Wanzi-z/access-controller/images/20260709_174217.jpg

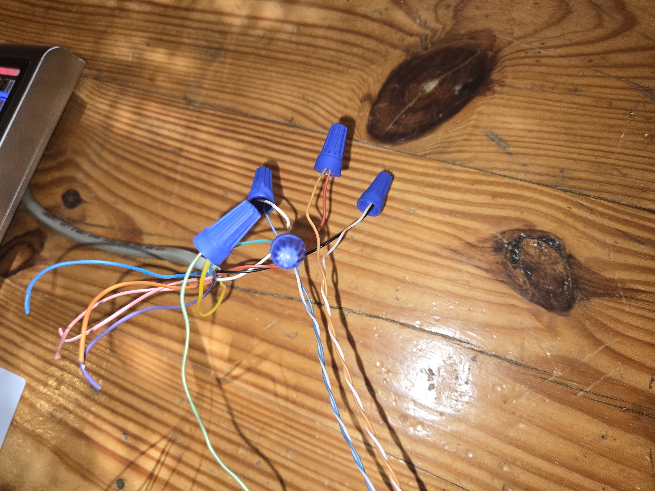
images/20260709_174217.jpg
