Wanzi-z/access-controller/images/20260709_174414.jpg

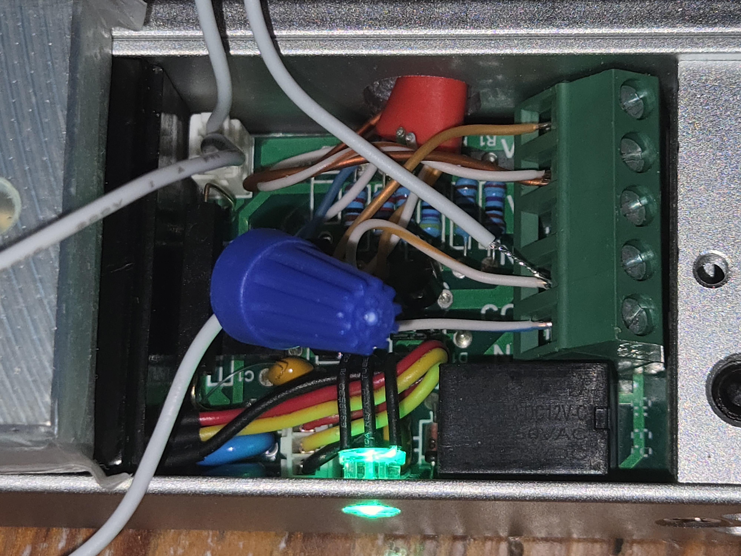
images/20260709_174414.jpg
