Wanzi-z/access-controller/code/controller/tests/artifacts/system-overview-mobile.png

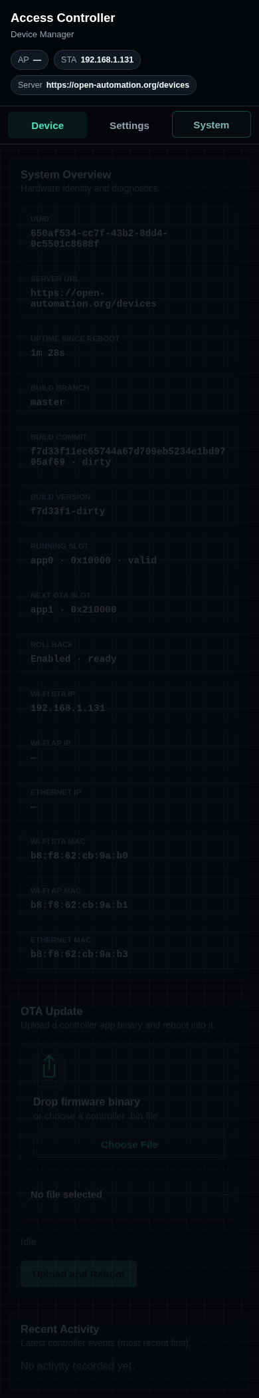
code/controller/tests/artifacts/system-overview-mobile.png
