Wanzi-z/access-controller/code/controller/tests/artifacts/system-overview-wide-refined.png

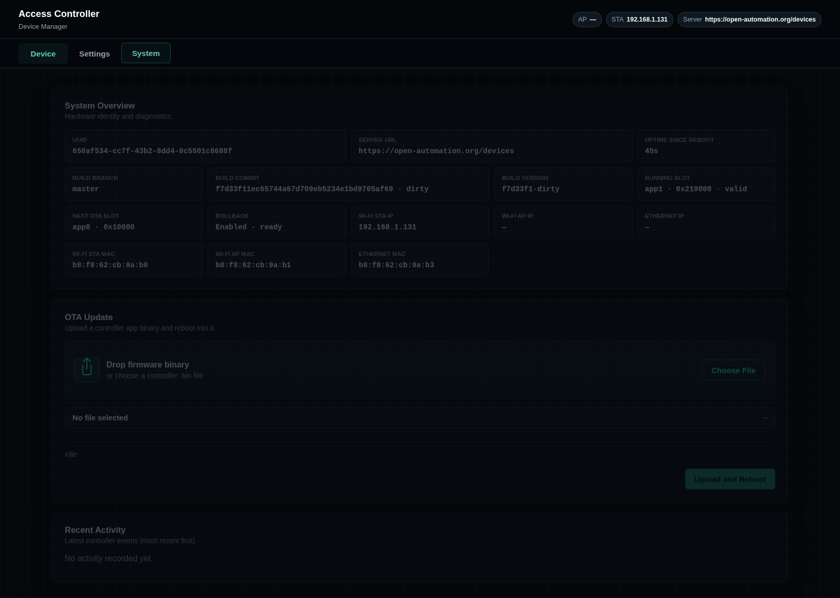
code/controller/tests/artifacts/system-overview-wide-refined.png
