Wanzi-z/access-controller/code/controller/tests/artifacts/system-overview-wide.png

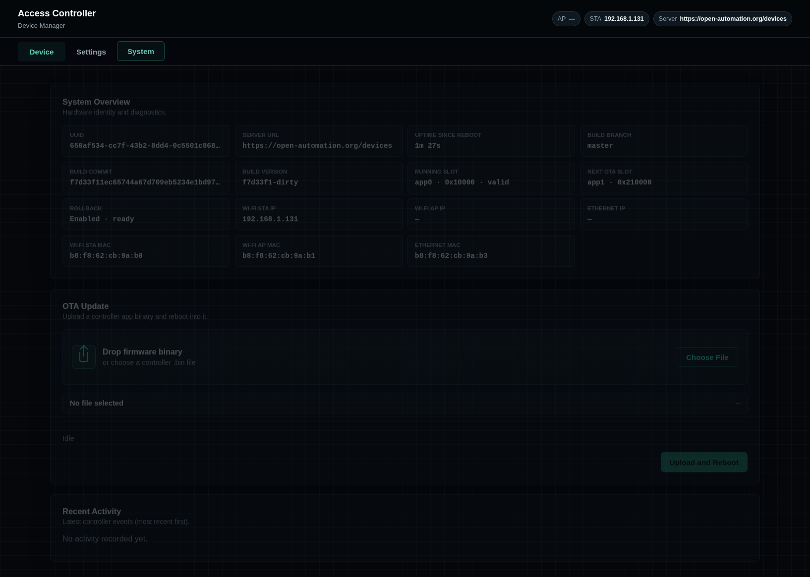
code/controller/tests/artifacts/system-overview-wide.png
