Wanzi-z/access-controller/images/20260709_150411.jpg

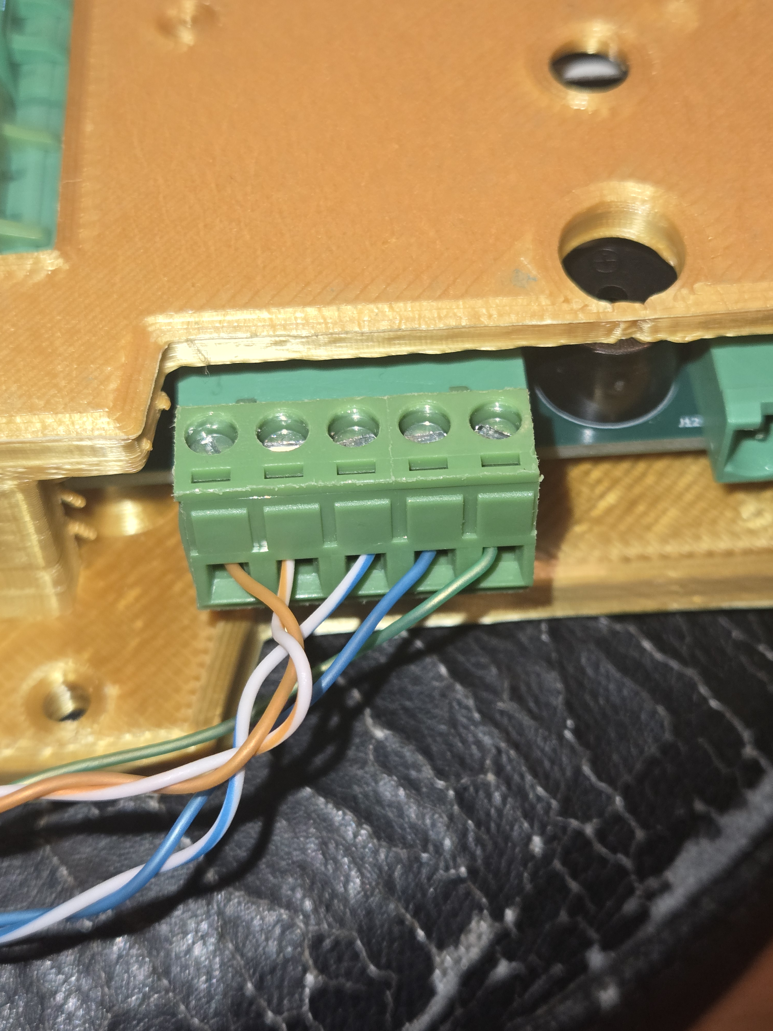
images/20260709_150411.jpg
