Wanzi-z/access-controller/images/20260709_150417.jpg

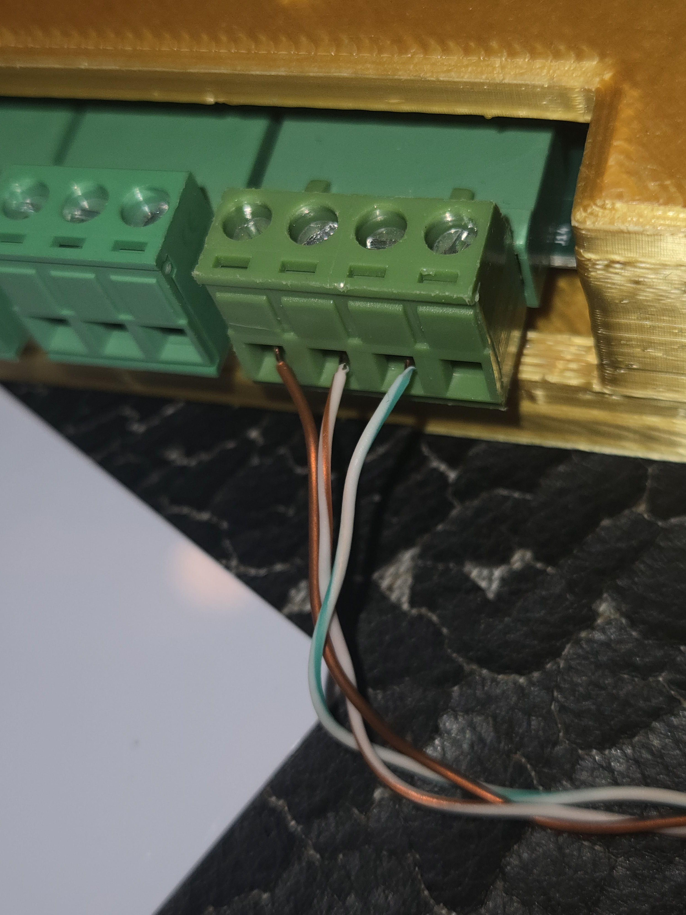
images/20260709_150417.jpg
