Wanzi-z/access-controller/images/20260709_174208.jpg

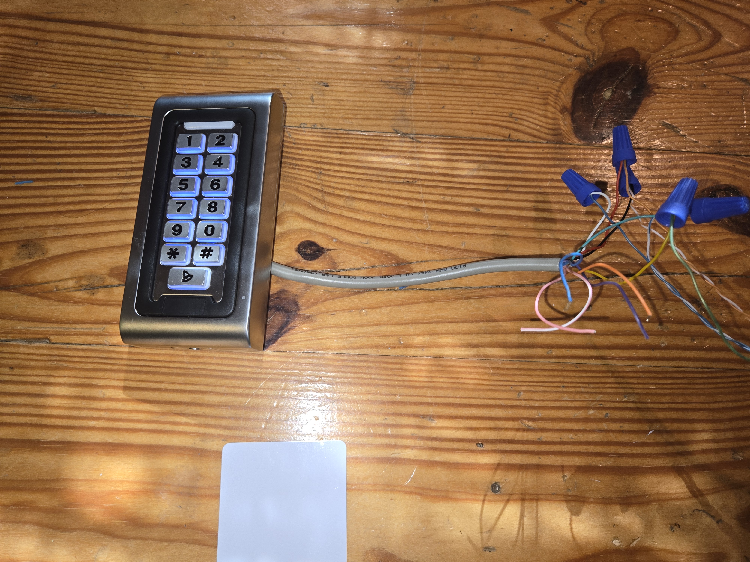
images/20260709_174208.jpg
