Wanzi-z/access-controller/images/20260709_174212.jpg

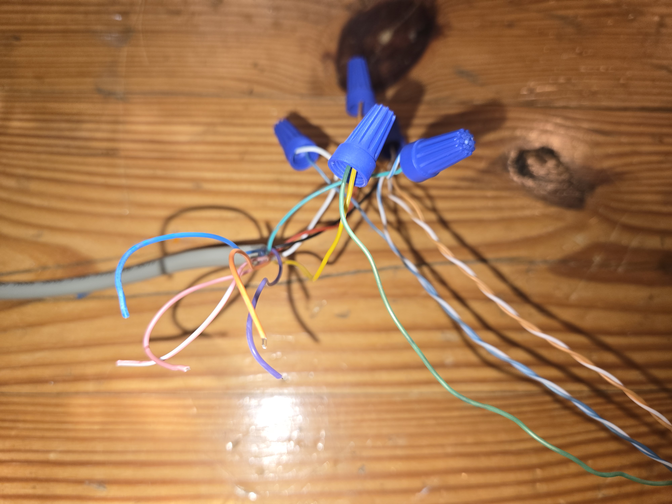
images/20260709_174212.jpg
