Wanzi-z/access-controller/images/20260709_174222.jpg

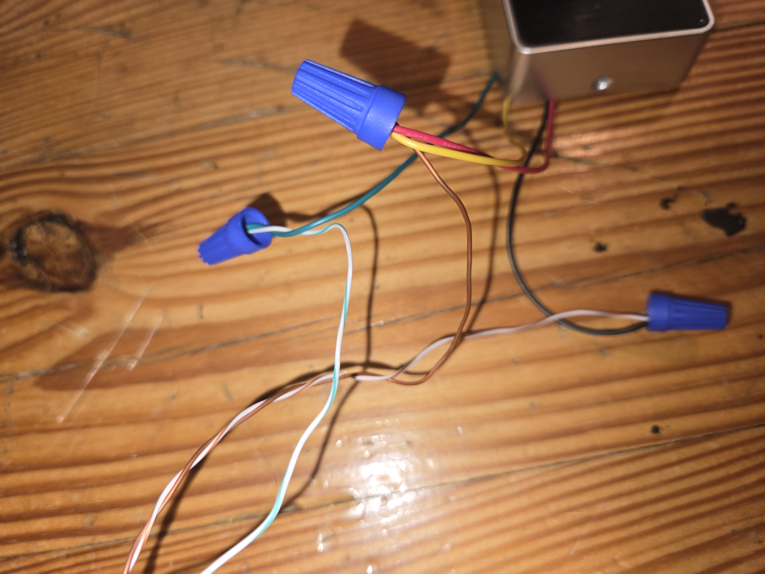
images/20260709_174222.jpg
