Wanzi-z/access-controller/images/20260709_174225.jpg

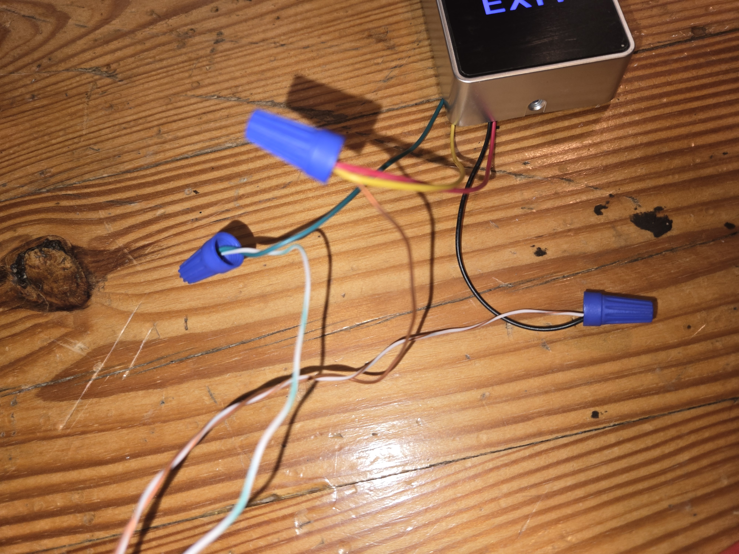
images/20260709_174225.jpg
