Wanzi-z/access-controller/images/20260709_174229.jpg

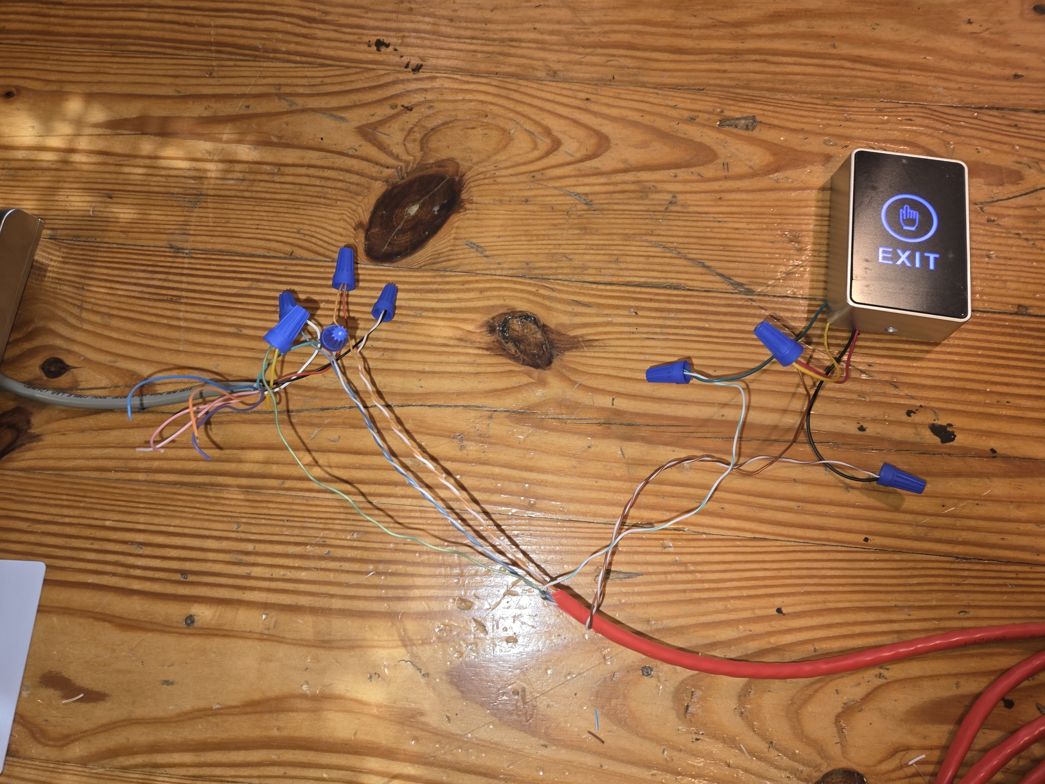
images/20260709_174229.jpg
