Wanzi-z/access-controller/images/20260709_174233.jpg

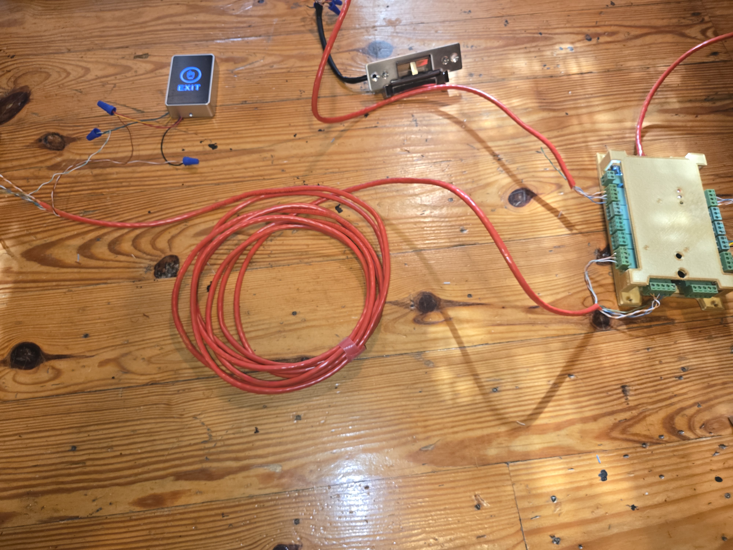
images/20260709_174233.jpg
