Wanzi-z/access-controller/images/20260709_174241.jpg

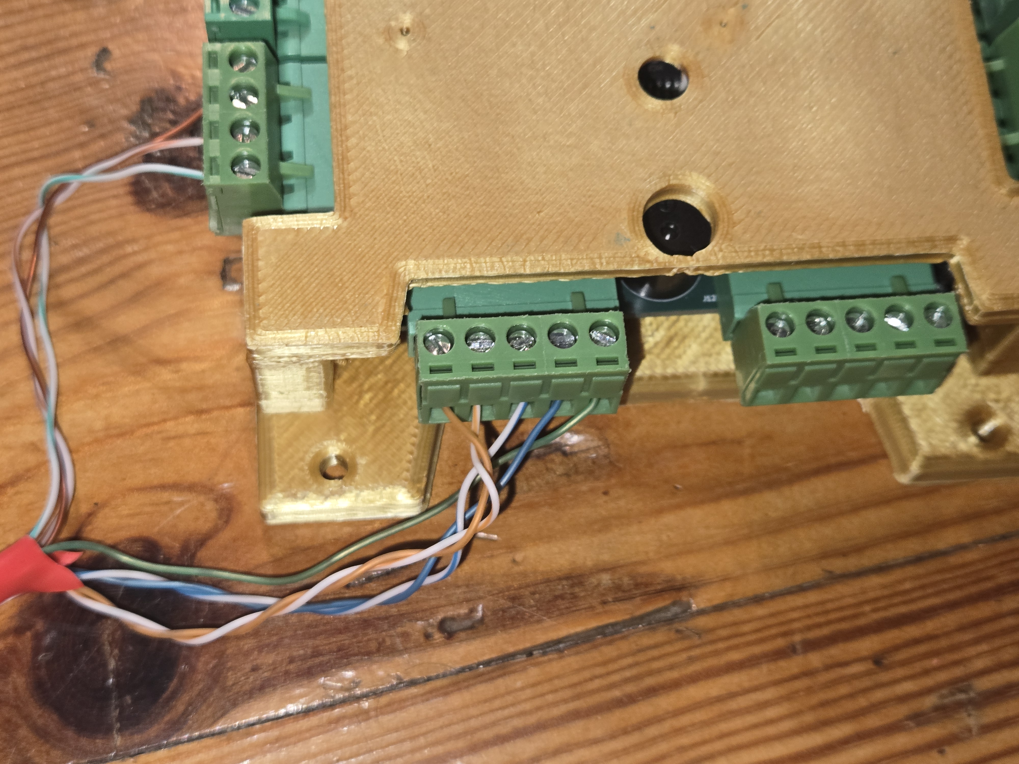
images/20260709_174241.jpg
