Wanzi-z/access-controller/images/20260709_174245.jpg

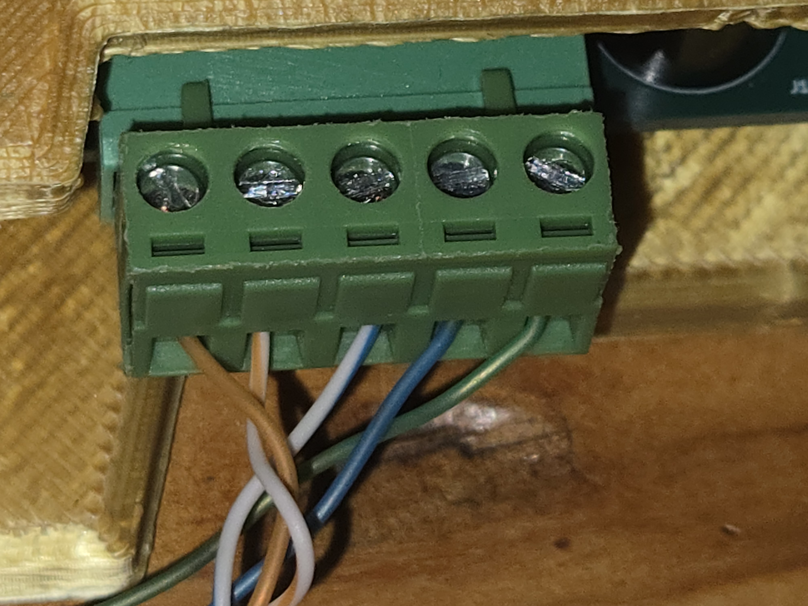
images/20260709_174245.jpg
