Wanzi-z/access-controller/images/20260709_174251.jpg

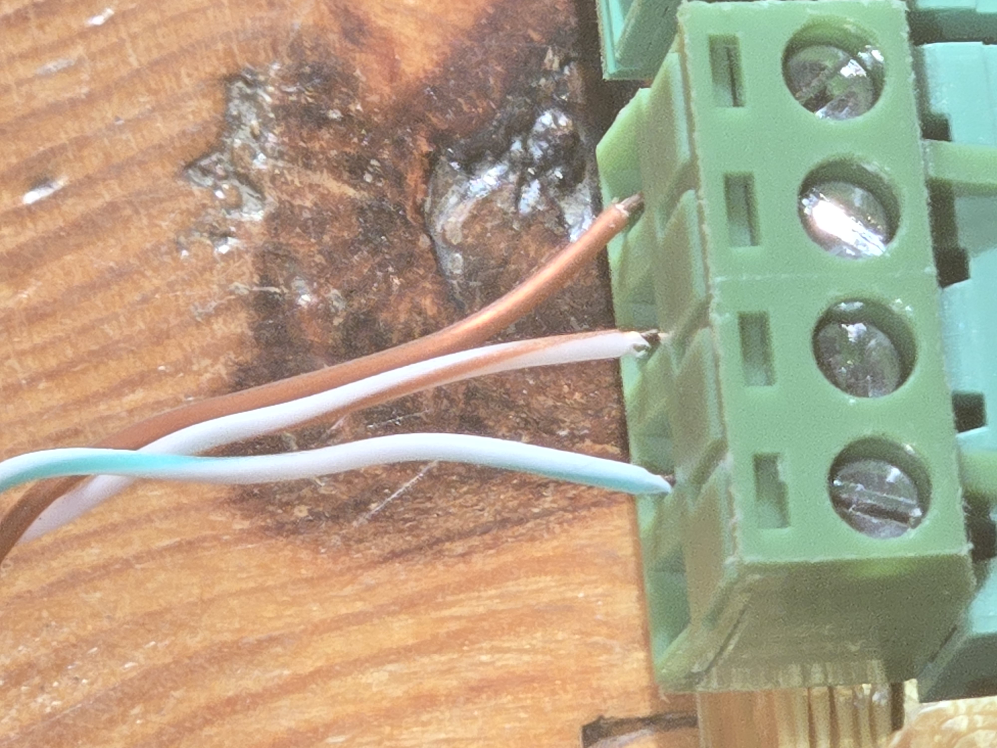
images/20260709_174251.jpg
