Wanzi-z/access-controller/images/20260709_174256.jpg

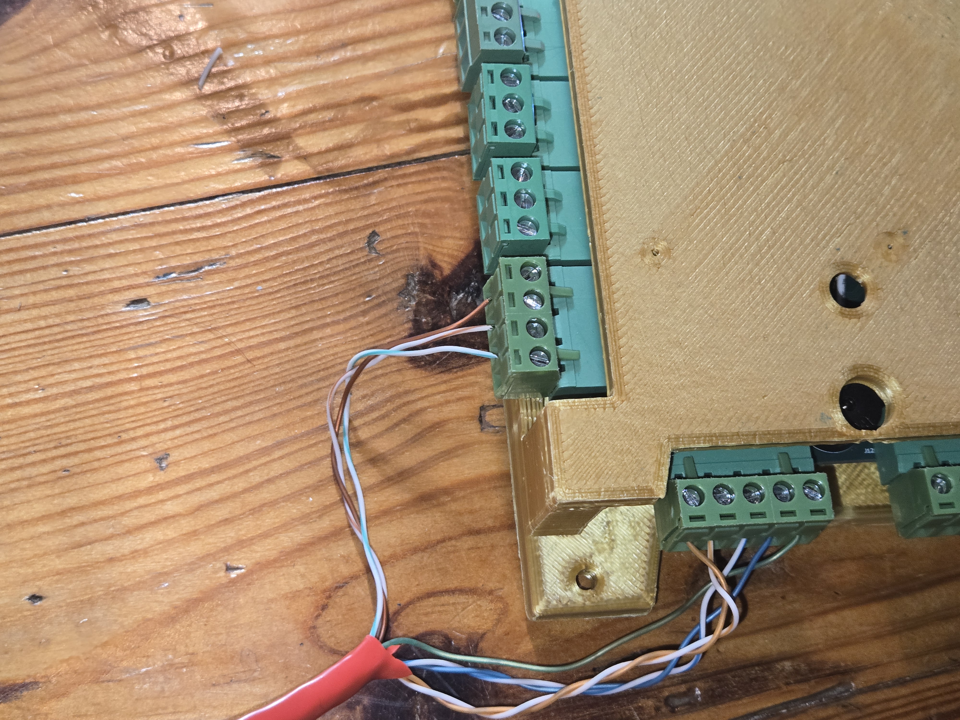
images/20260709_174256.jpg
