Wanzi-z/access-controller/images/20260709_174305.jpg

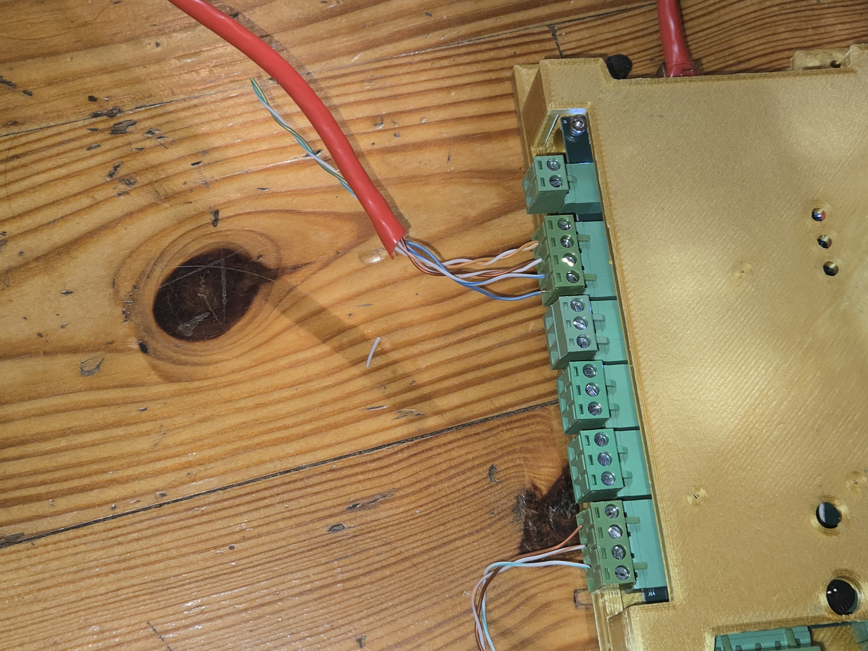
images/20260709_174305.jpg
