Wanzi-z/access-controller/images/20260709_174310.jpg

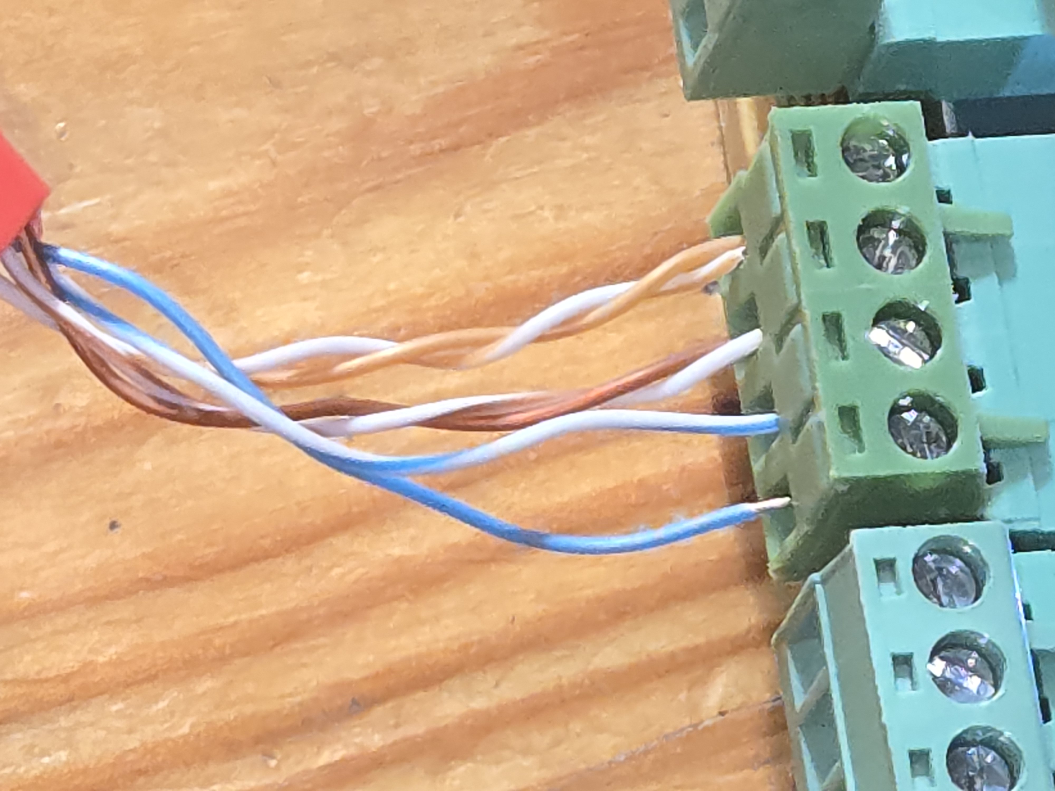
images/20260709_174310.jpg
