Wanzi-z/access-controller/images/20260709_174321.jpg

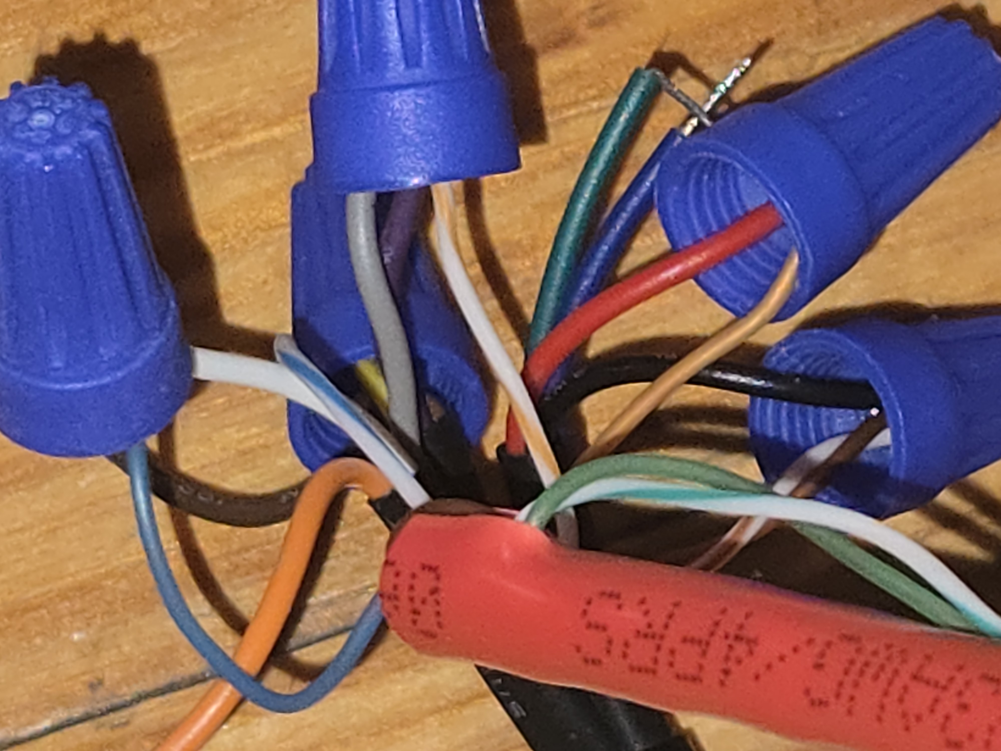
images/20260709_174321.jpg
