Wanzi-z/access-controller/images/20260709_174329.jpg

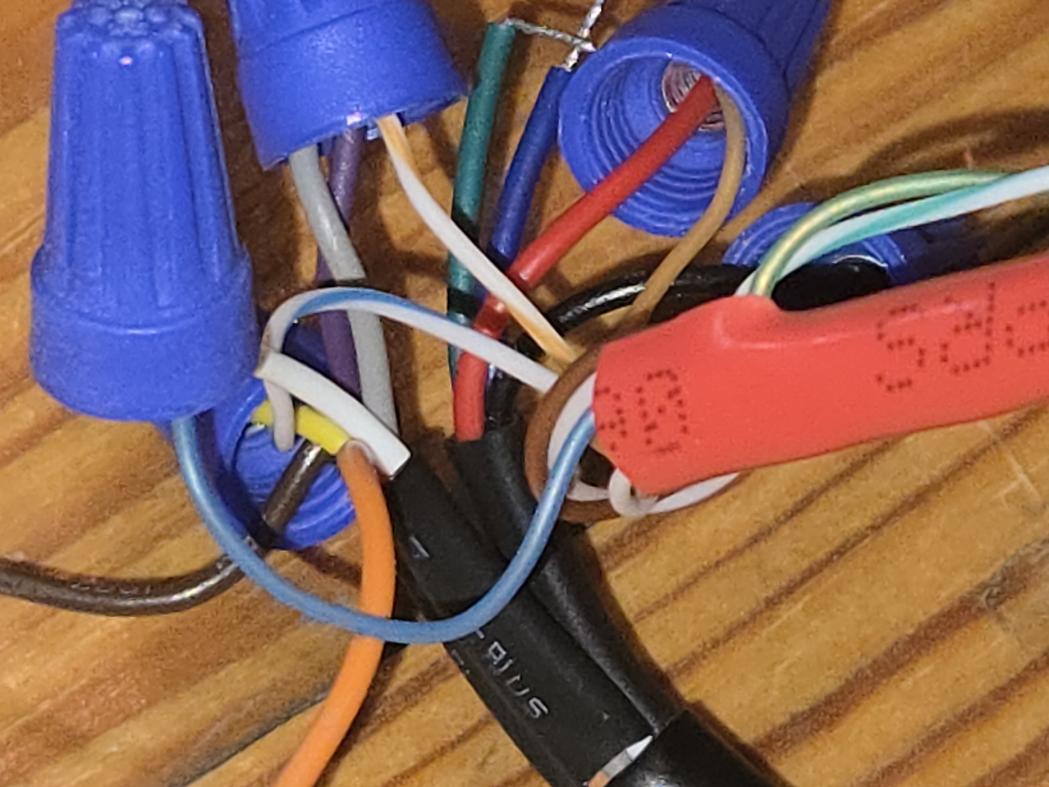
images/20260709_174329.jpg
