Wanzi-z/access-controller/images/20260709_174342.jpg

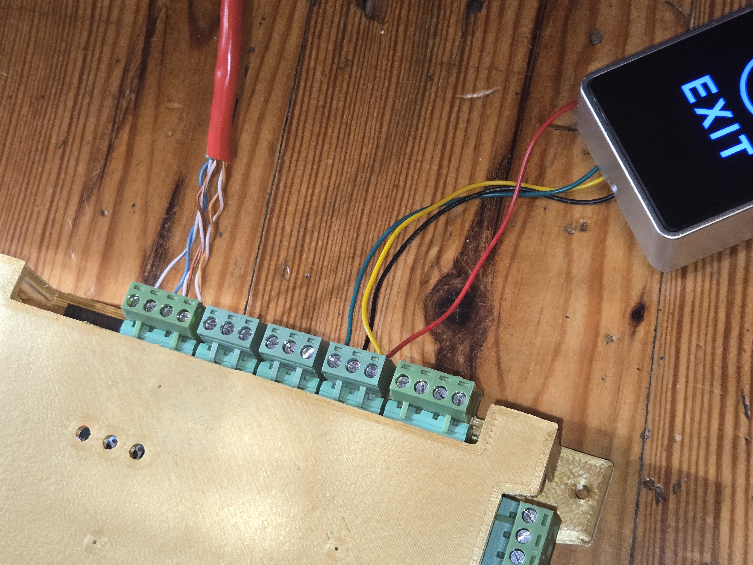
images/20260709_174342.jpg
