Wanzi-z/access-controller/images/20260709_174347.jpg

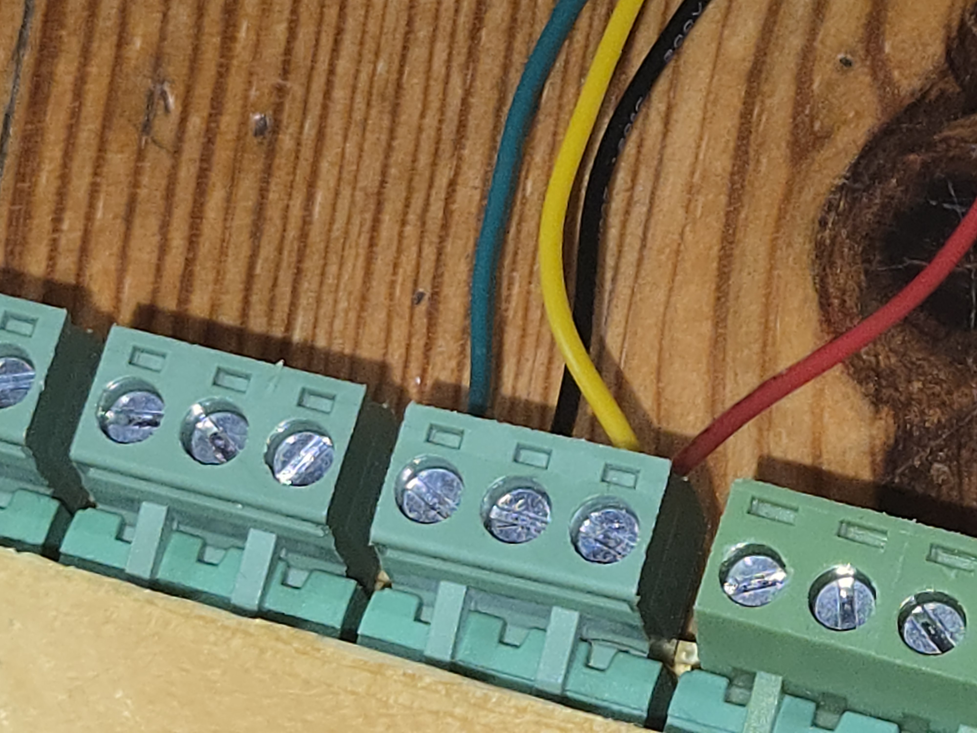
images/20260709_174347.jpg
