Wanzi-z/access-controller/images/20260709_174352.jpg

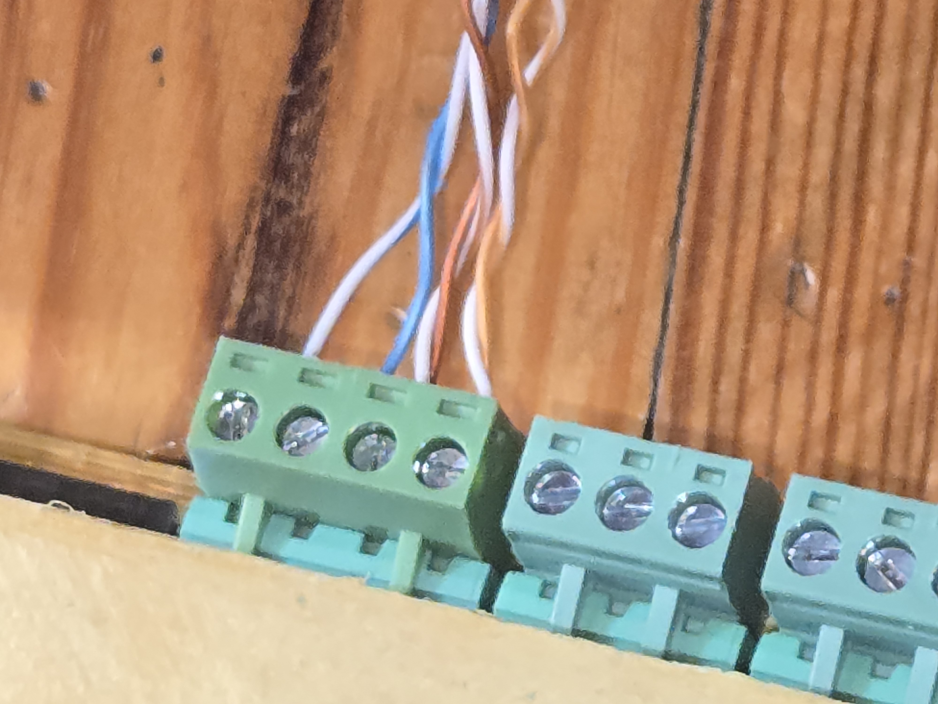
images/20260709_174352.jpg
