Wanzi-z/access-controller/images/20260709_174356.jpg

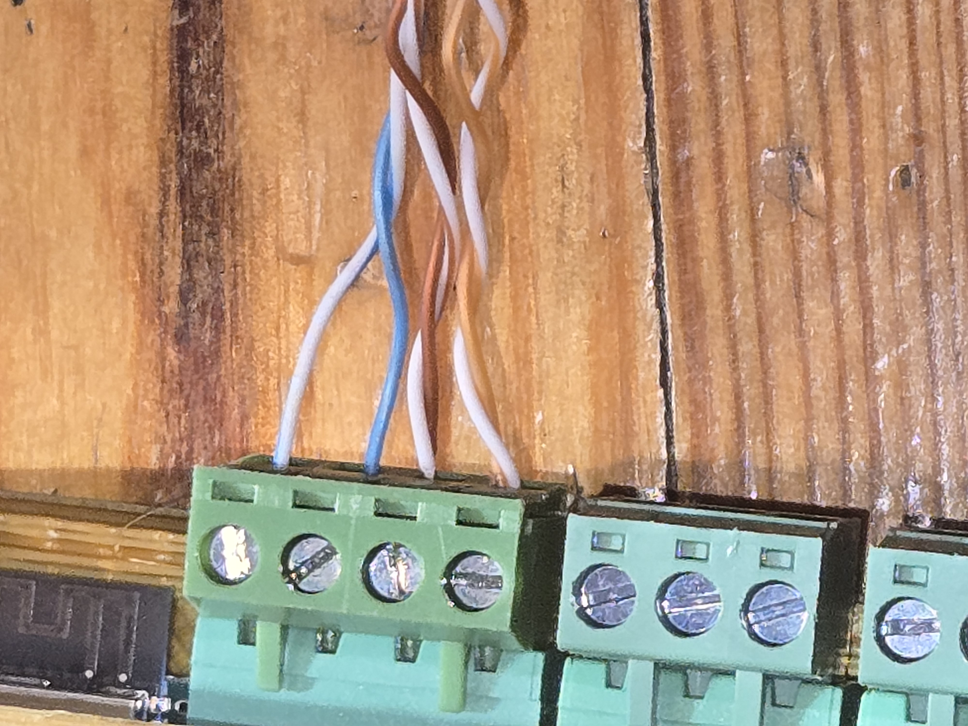
images/20260709_174356.jpg
