Wanzi-z/access-controller/images/20260709_174419.jpg

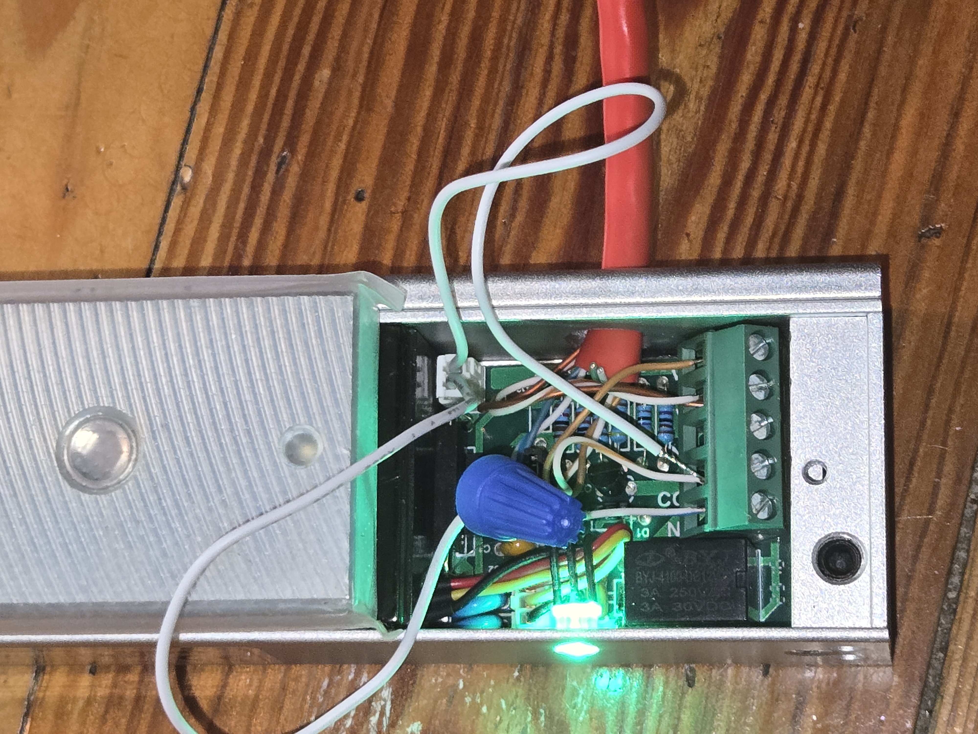
images/20260709_174419.jpg
