Wanzi-z/access-controller/images/20260709_174429.jpg

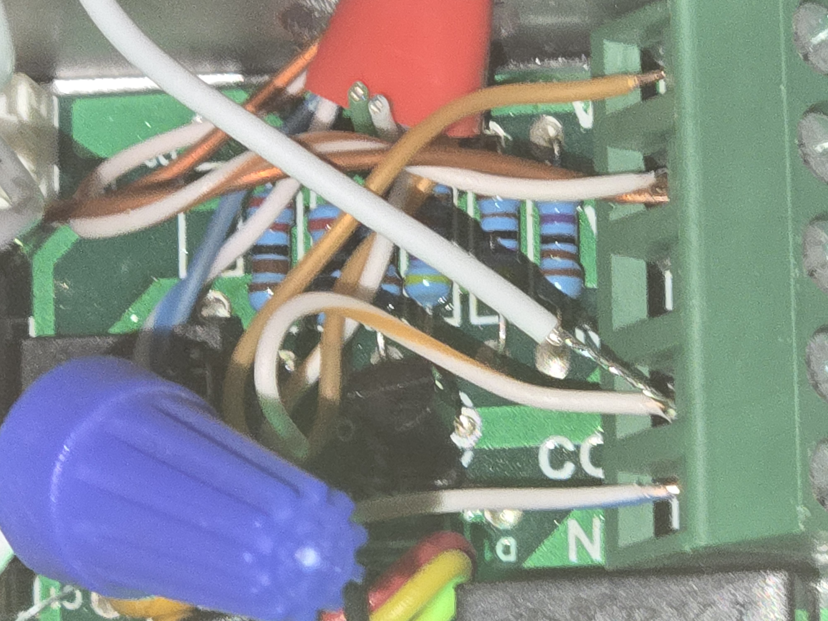
images/20260709_174429.jpg
