Wanzi-z/access-controller/images/20260724_203152.jpg

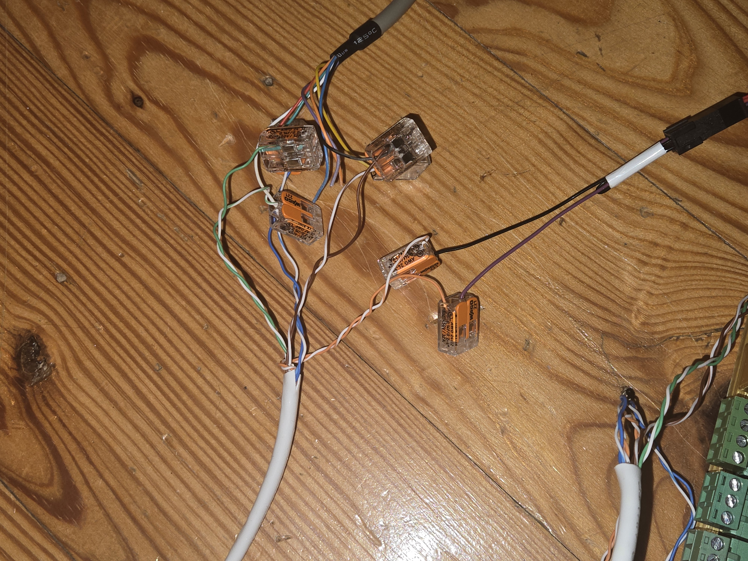
images/20260724_203152.jpg
