Wanzi-z/access-controller/images/20260724_203221.jpg

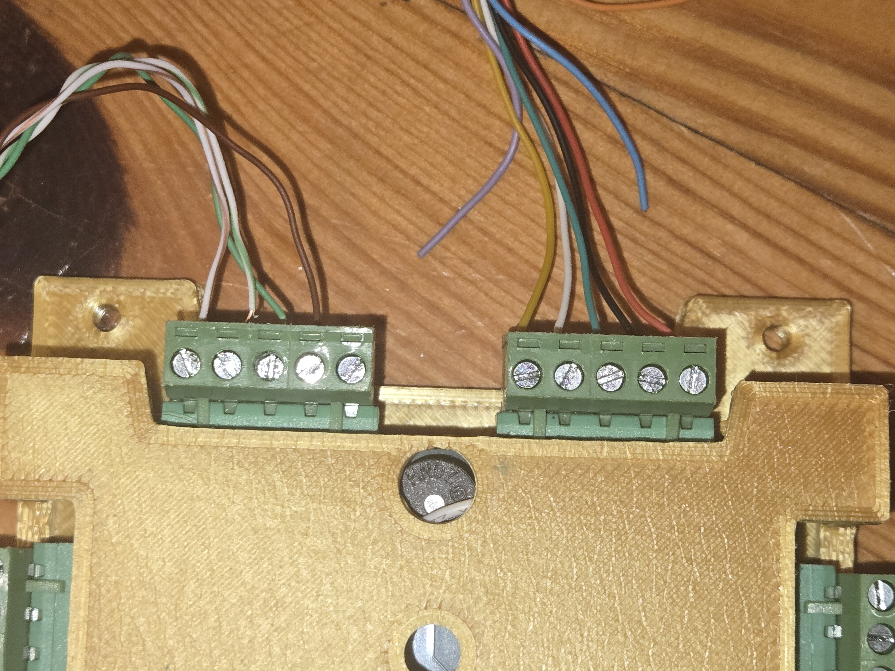
images/20260724_203221.jpg
