Wanzi-z/access-controller/images/20260724_203311.jpg

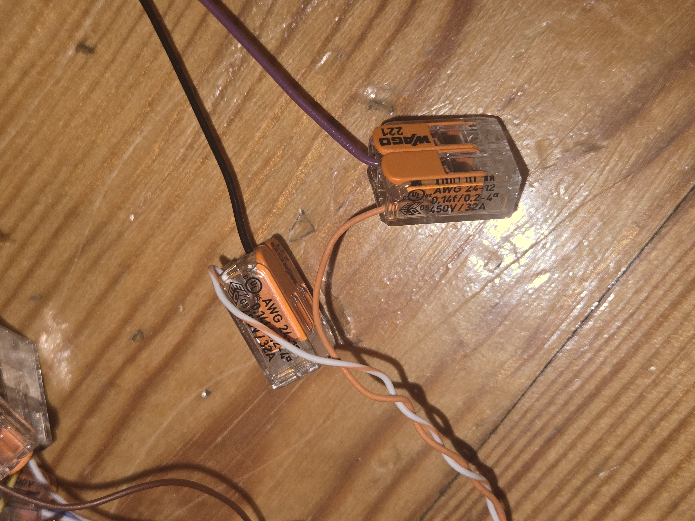
images/20260724_203311.jpg
