Wanzi-z/access-controller/images/20260724_203321.jpg

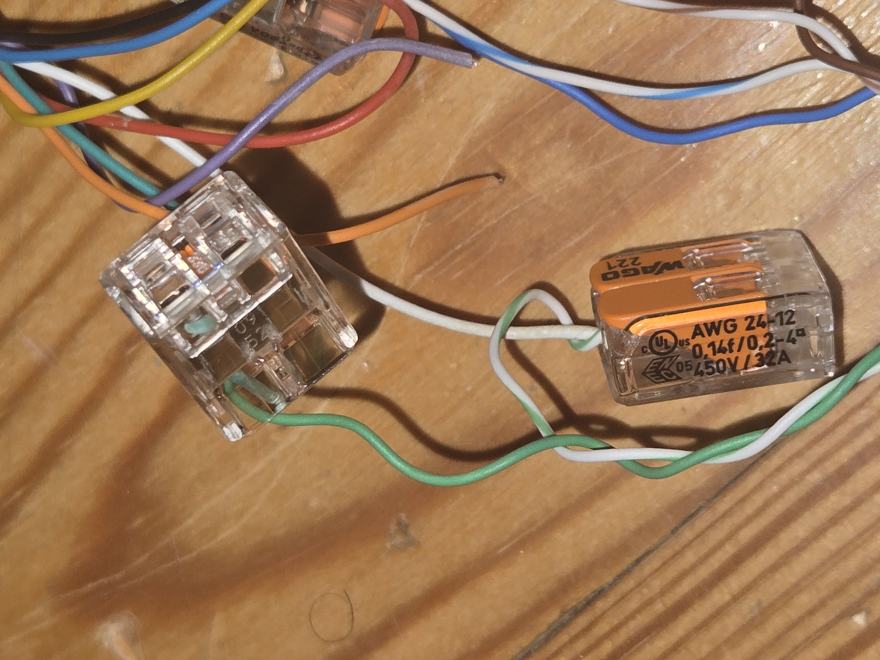
images/20260724_203321.jpg
