Wanzi-z/access-controller/images/20260724_203324.jpg

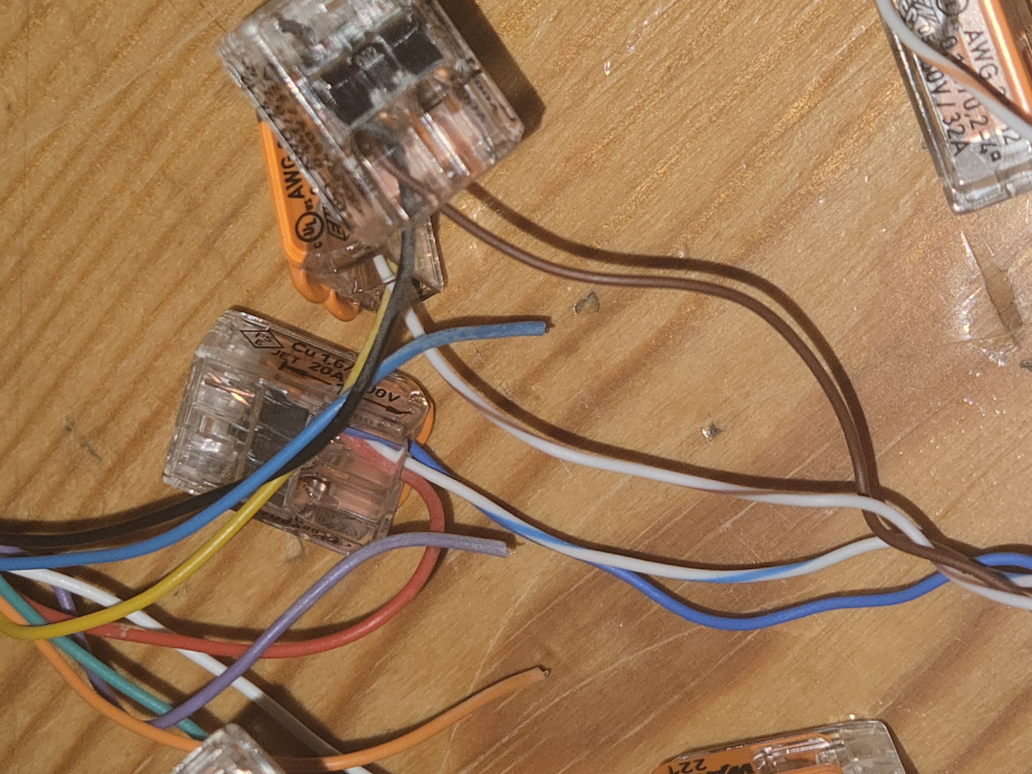
images/20260724_203324.jpg
