Wanzi-z/access-controller/images/20260724_203329.jpg

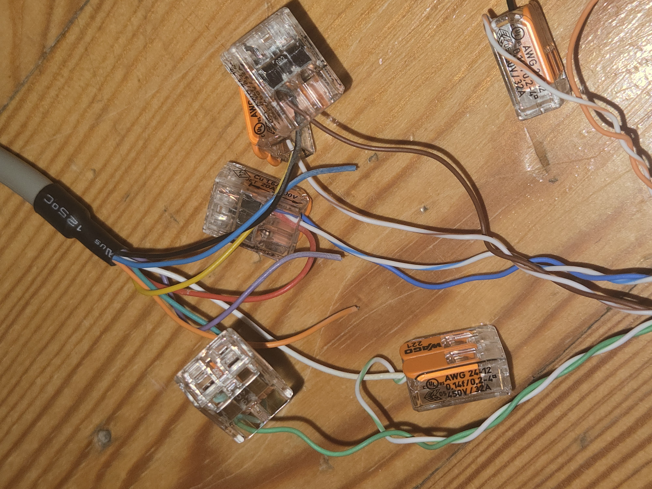
images/20260724_203329.jpg
