Wanzi-z/access-controller/images/20260724_203333.jpg

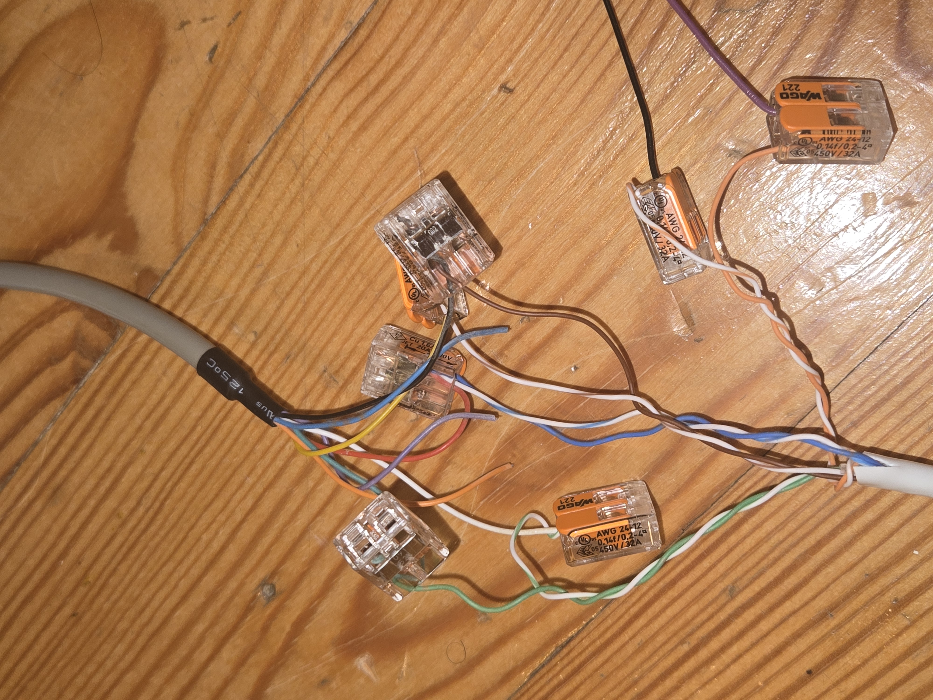
images/20260724_203333.jpg
