Wanzi-z/access-controller/images/20260725_wifi_credentials_note.jpg

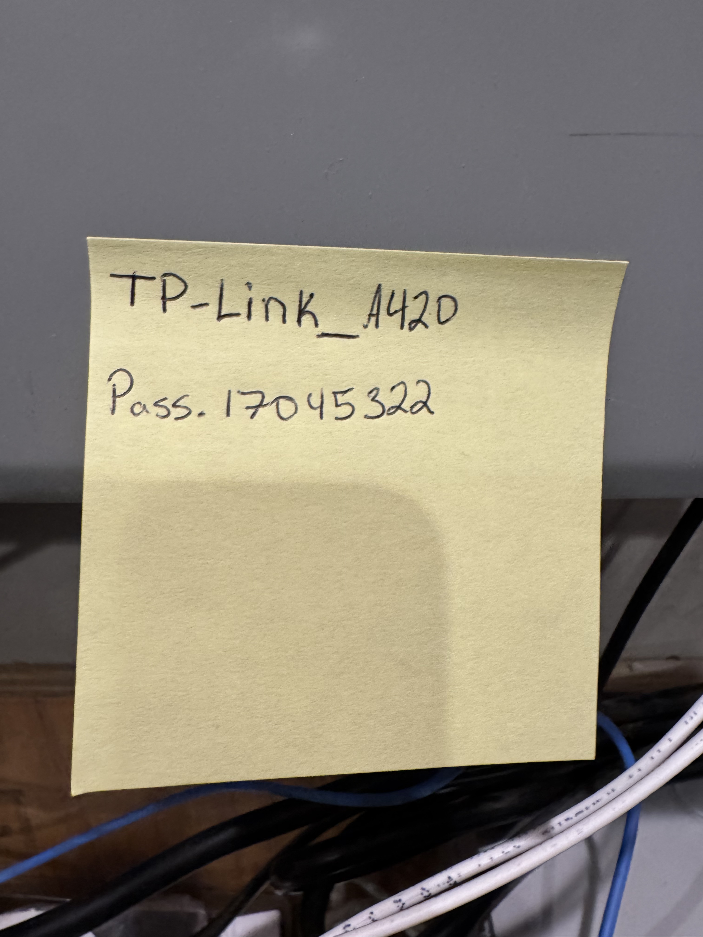
images/20260725_wifi_credentials_note.jpg
