Wanzi-z/access-controller/tmp/access-controller-device-smoke.png

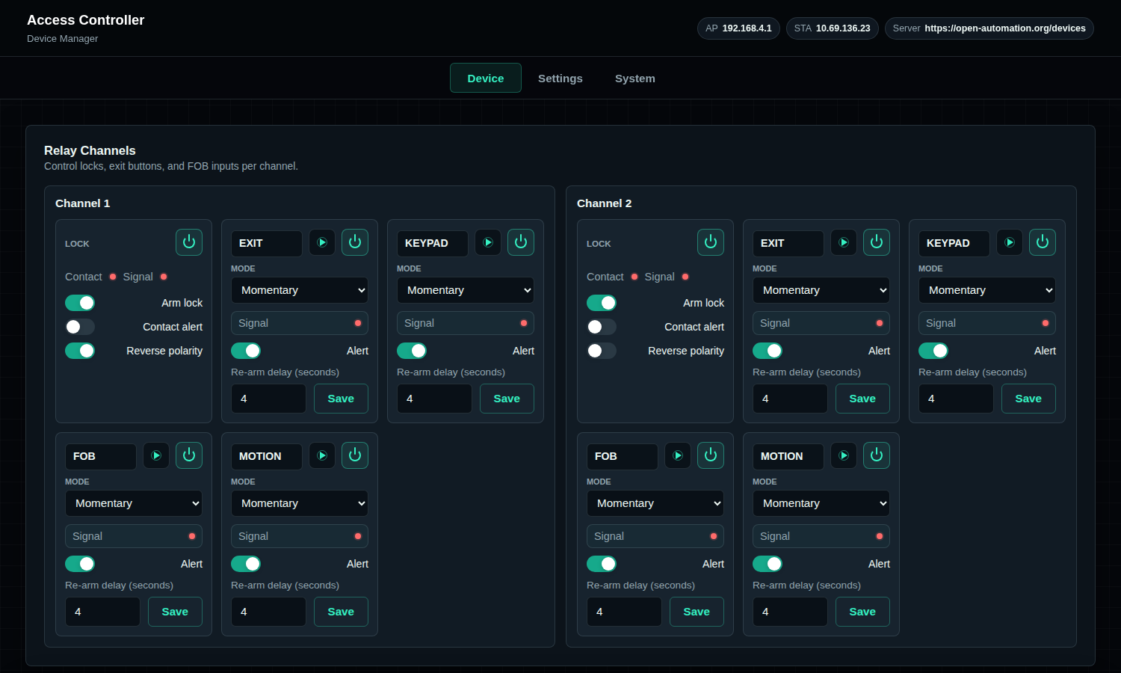
tmp/access-controller-device-smoke.png
