Wanzi-z/access-controller/model/controller/controller-plate.stl

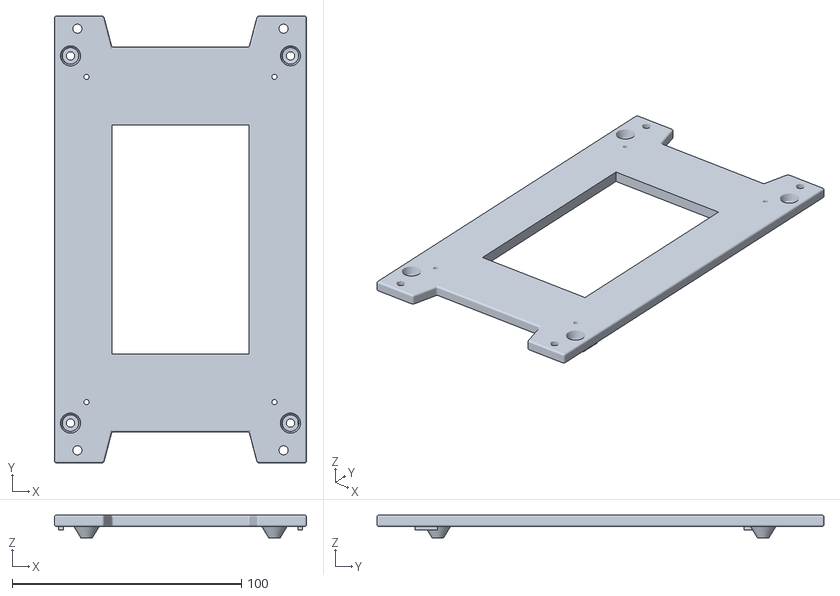
[picture p42: CAD file, 2026-07-09]
model/controller/controller-plate.stl
110.0 x 195.1 x 10.0
