Wanzi-z/access-controller/model/controller/controller-cover.3mf

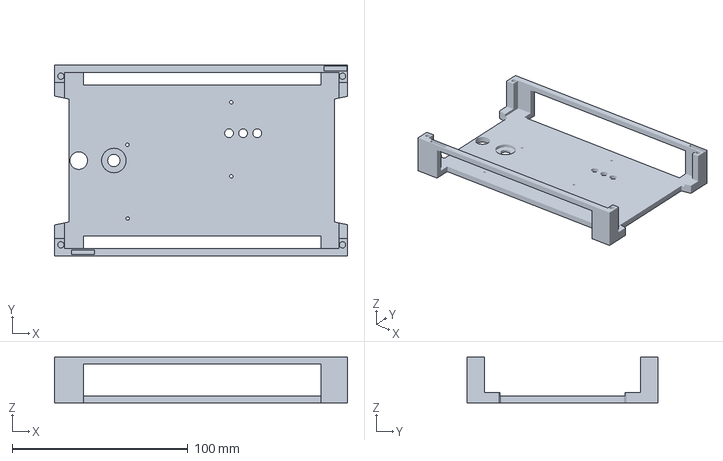
[picture p43: CAD file, 2026-07-09]
model/controller/controller-cover.3mf
166.8 x 108.6 x 26.0 mm
