Wanzi-z/access-controller/(list of files, cad)

Other CAD files:
model/controller/controller-cover.stl
model/controller/controller.blend
