Wanzi-z/access-controller/code/controller/tests/artifacts/activity-outline-v27-smoke.png

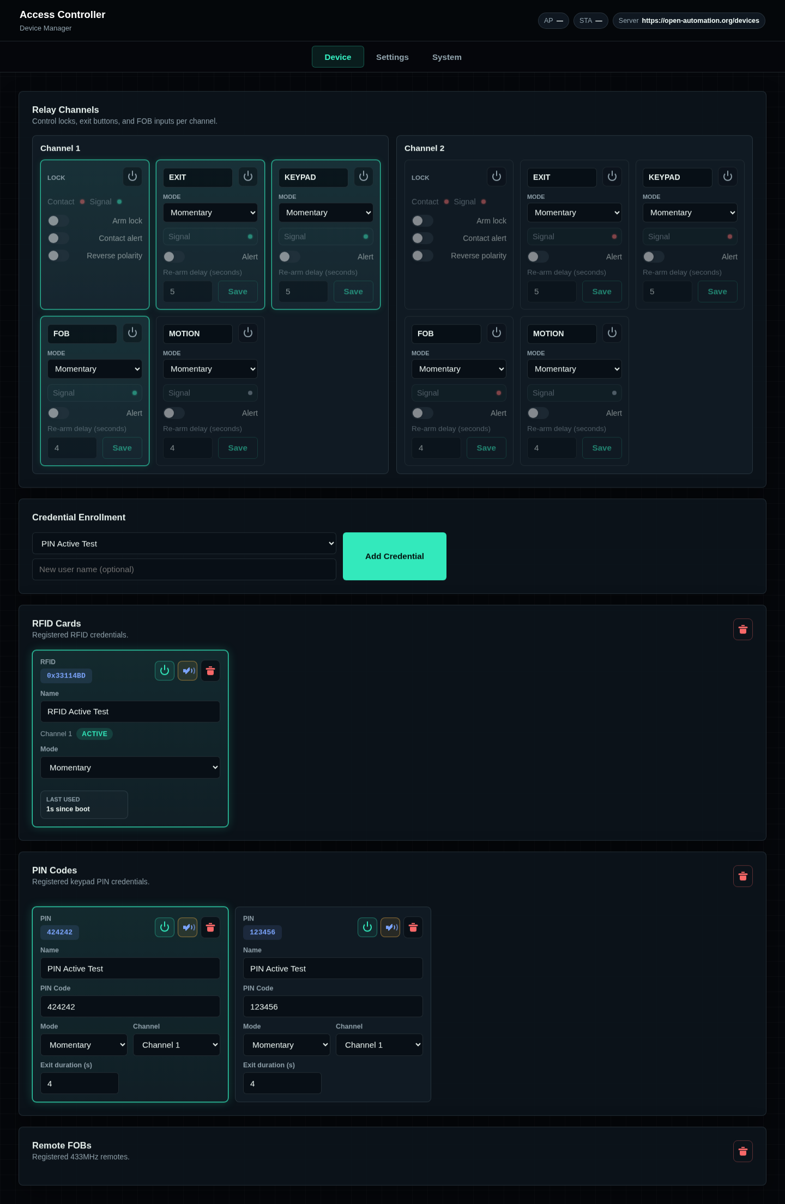
code/controller/tests/artifacts/activity-outline-v27-smoke.png
