Wanzi-z/access-controller/code/controller/tests/artifacts/card-enable-ui-final-rfid-mode.png

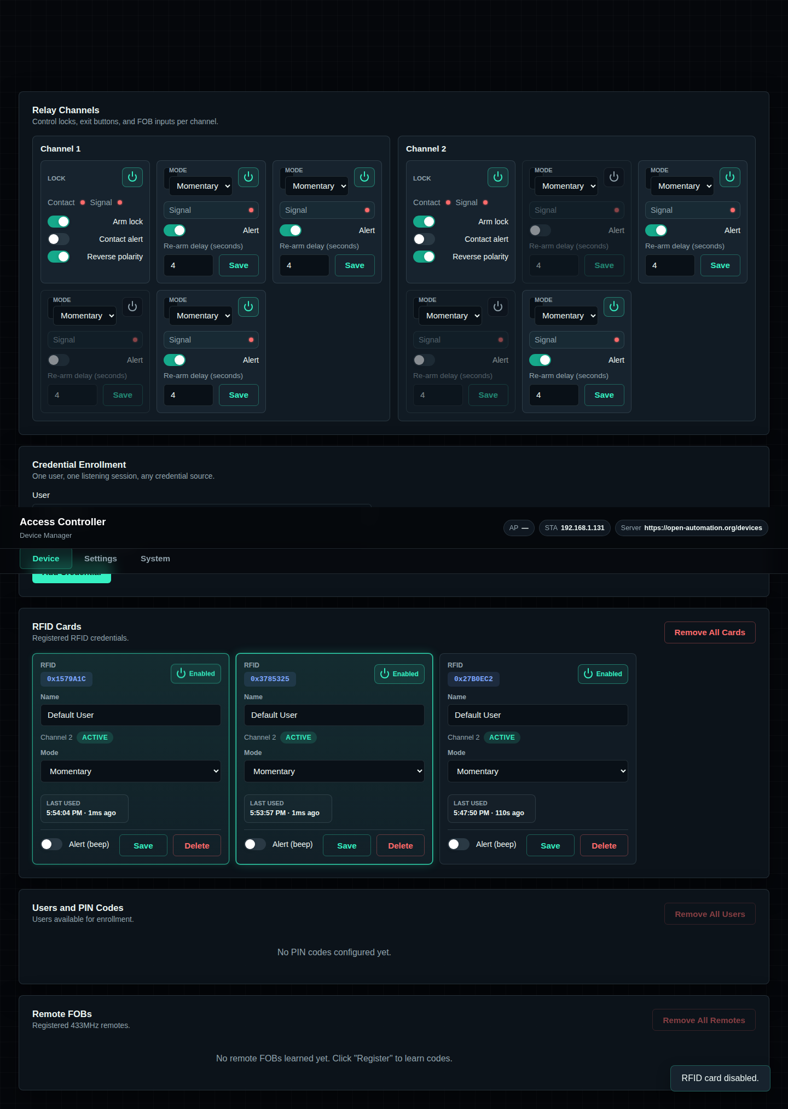
code/controller/tests/artifacts/card-enable-ui-final-rfid-mode.png
