Wanzi-z/access-controller/code/controller/tests/artifacts/card-enable-ui-final.png

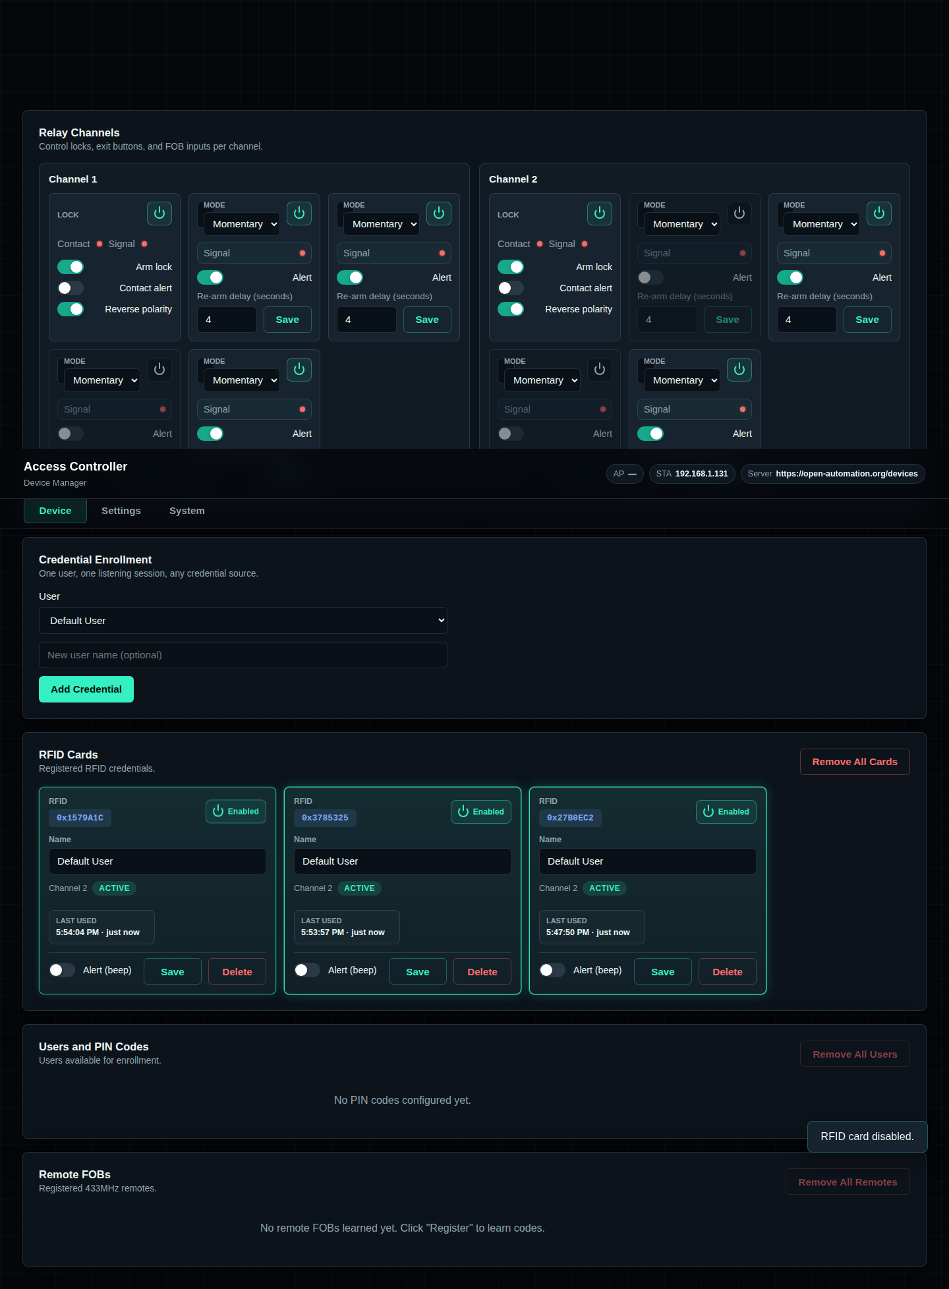
code/controller/tests/artifacts/card-enable-ui-final.png
