Wanzi-z/access-controller/code/controller/tests/artifacts/channel-card-modes-58db8b7.png

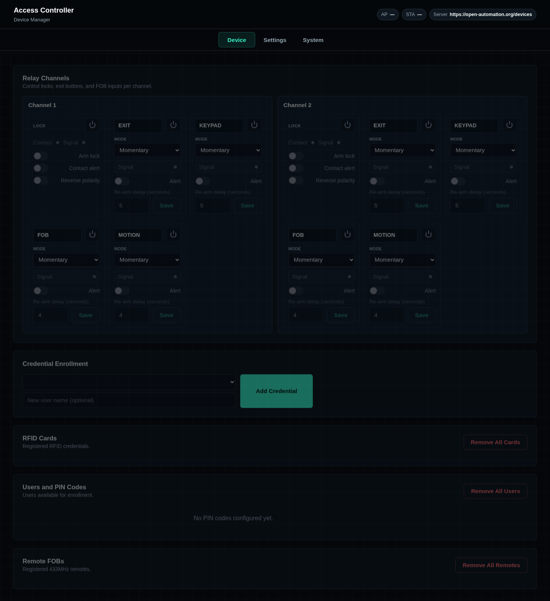
code/controller/tests/artifacts/channel-card-modes-58db8b7.png
