Wanzi-z/access-controller/code/controller/tests/artifacts/channel-card-modes-live-final-layout.png

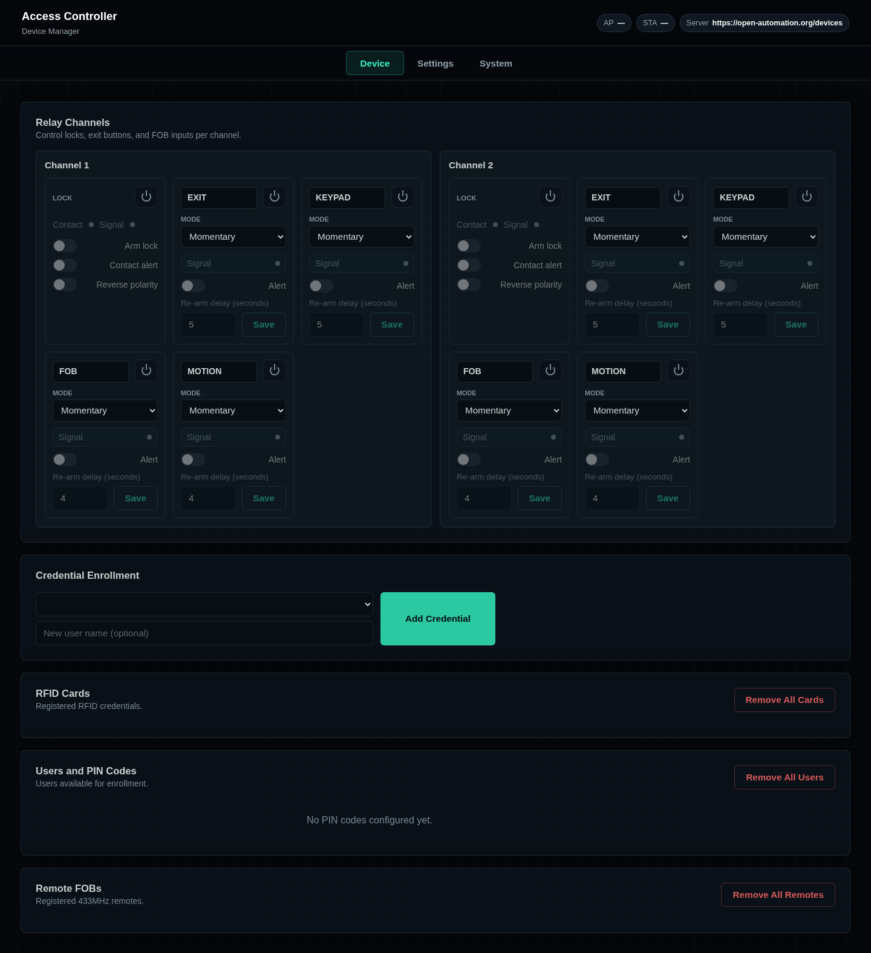
code/controller/tests/artifacts/channel-card-modes-live-final-layout.png
