Wanzi-z/access-controller/code/controller/tests/artifacts/channel-card-modes-live.png

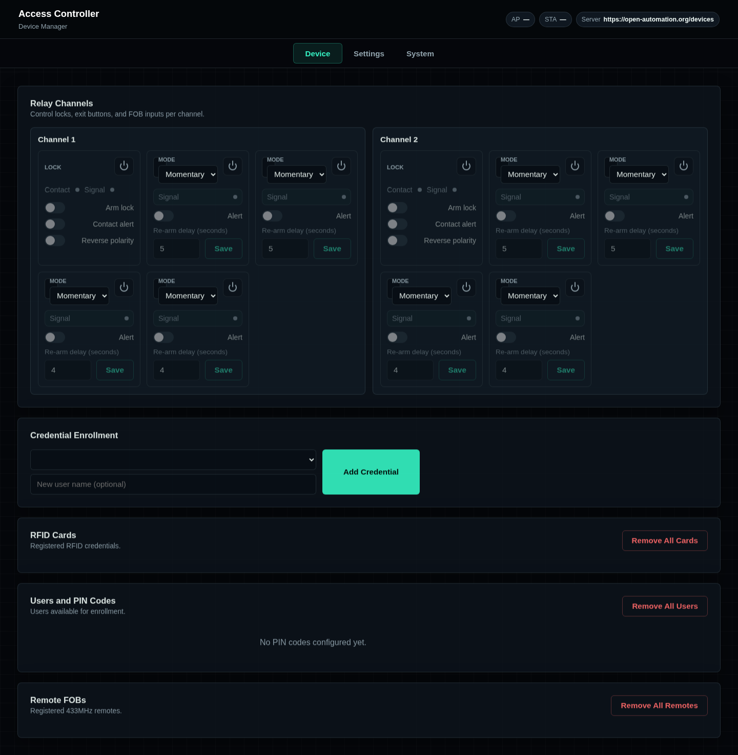
code/controller/tests/artifacts/channel-card-modes-live.png
