Wanzi-z/access-controller/code/controller/tests/artifacts/enrollment-card-mobile.png

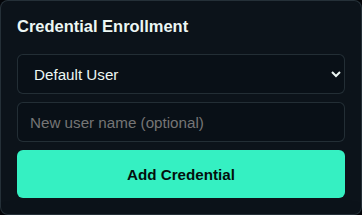
code/controller/tests/artifacts/enrollment-card-mobile.png
