Wanzi-z/access-controller/code/controller/tests/artifacts/enrollment-compact-desktop.png

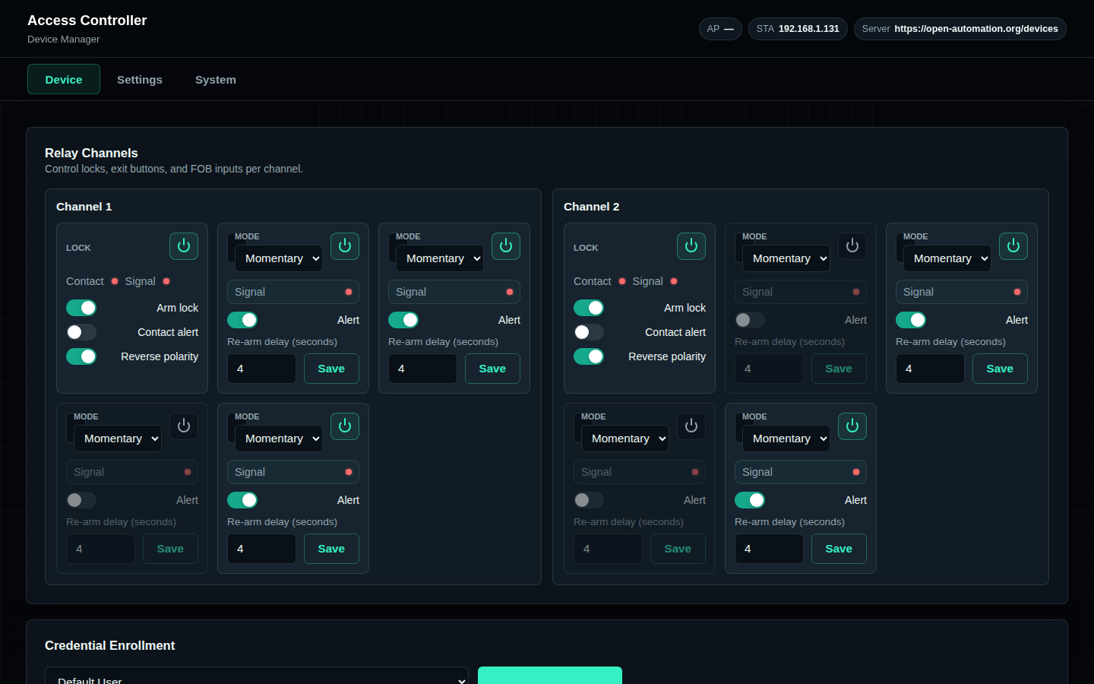
code/controller/tests/artifacts/enrollment-compact-desktop.png
