Wanzi-z/access-controller/code/controller/tests/artifacts/enrollment-compact-mobile.png

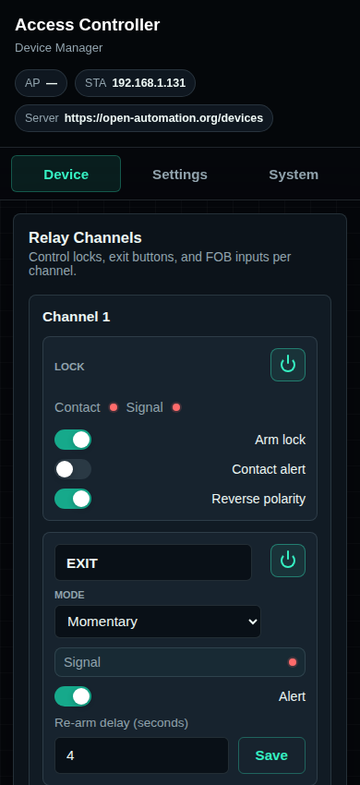
code/controller/tests/artifacts/enrollment-compact-mobile.png
