Wanzi-z/access-controller/code/controller/tests/artifacts/enrollment-rfid-layout-final.png

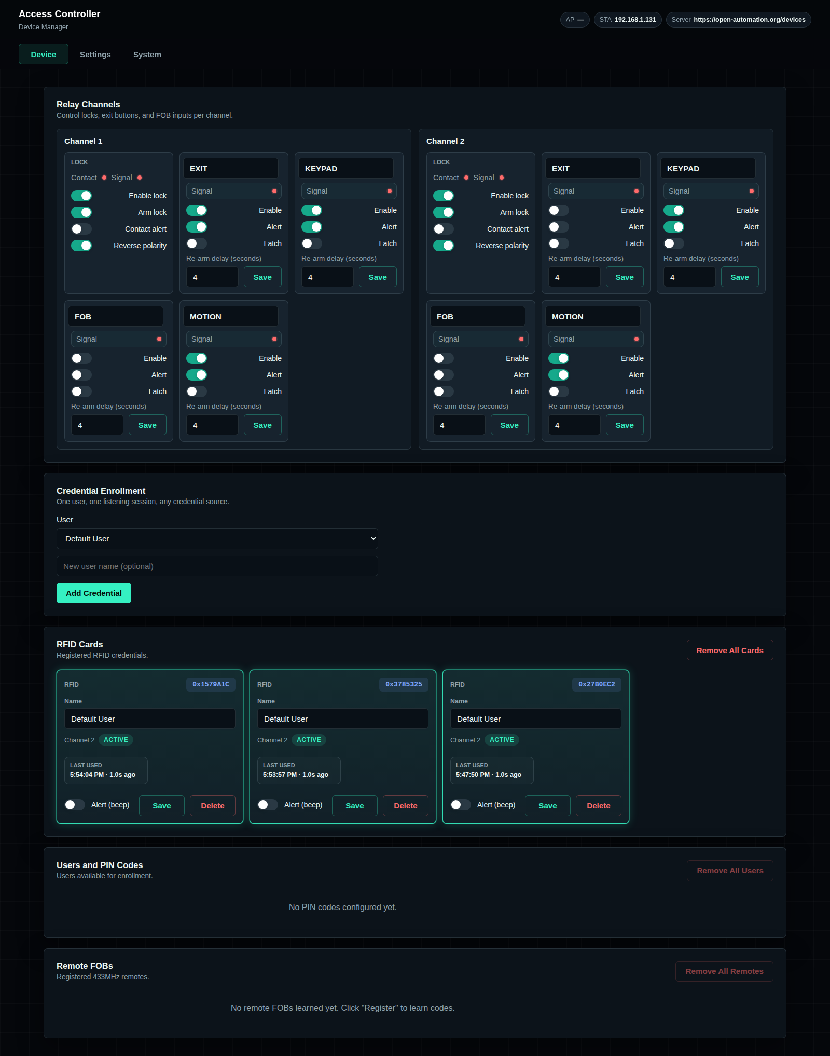
code/controller/tests/artifacts/enrollment-rfid-layout-final.png
