Wanzi-z/access-controller/code/controller/tests/artifacts/live-credential-resilience-socket-budget.png

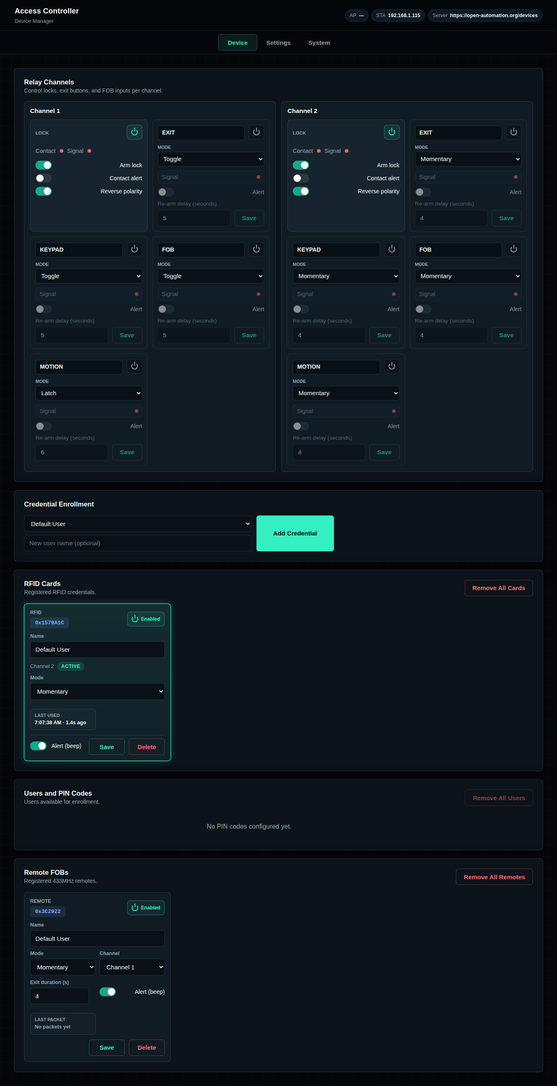
code/controller/tests/artifacts/live-credential-resilience-socket-budget.png
