Wanzi-z/access-controller/code/controller/tests/artifacts/live-credential-resilience.png

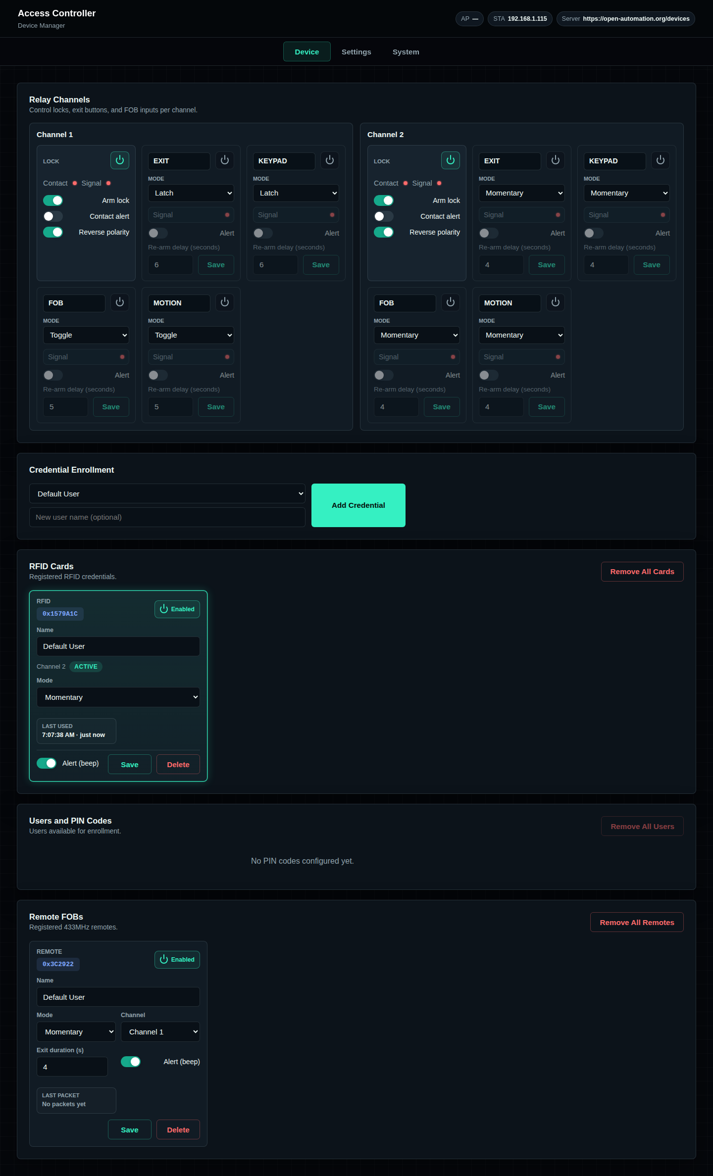
code/controller/tests/artifacts/live-credential-resilience.png
