Wanzi-z/access-controller/code/controller/tests/artifacts/live-pin-multi-card-current.png

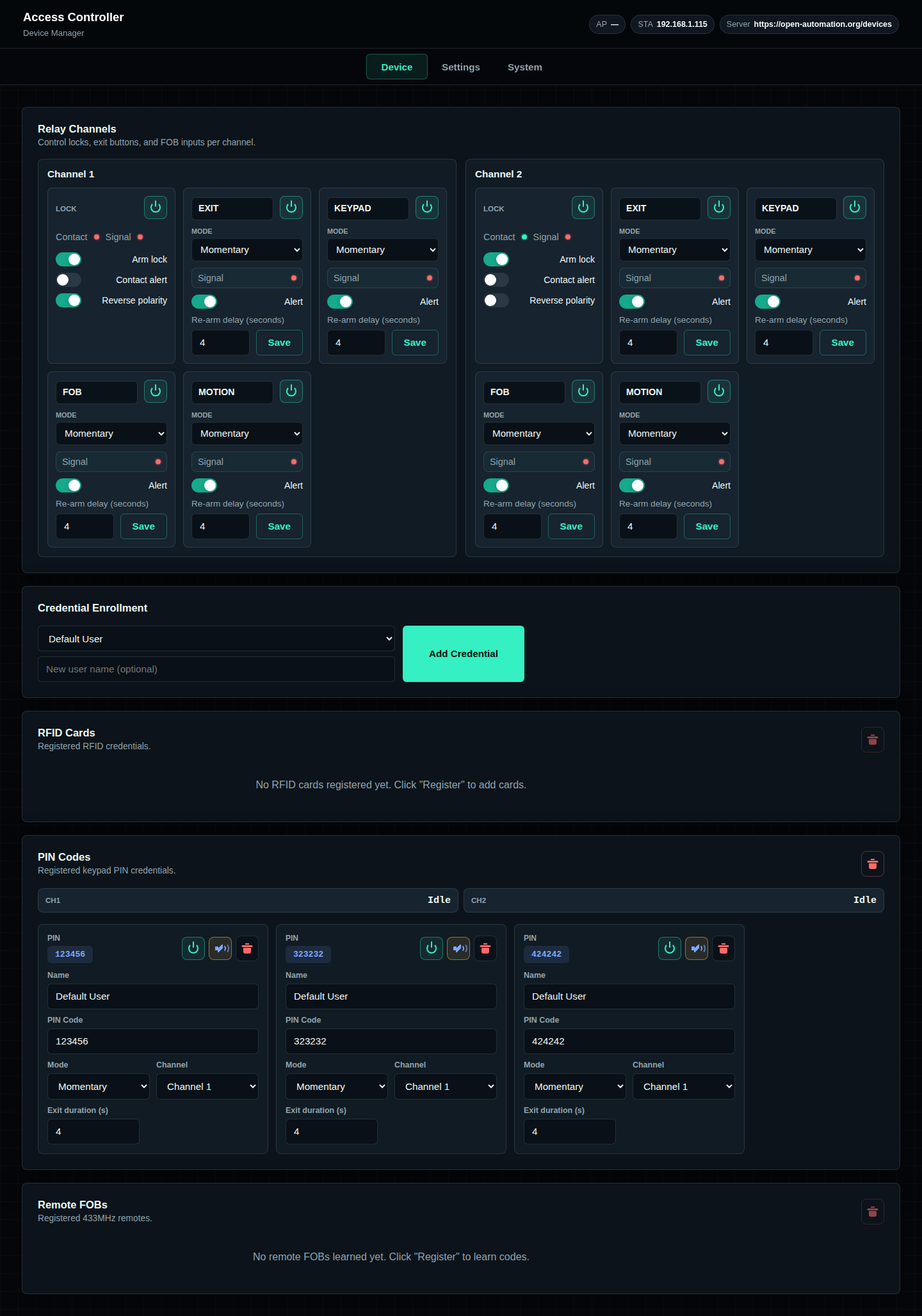
code/controller/tests/artifacts/live-pin-multi-card-current.png
