Wanzi-z/access-controller/code/controller/tests/artifacts/nav-centered-lan-desktop.png

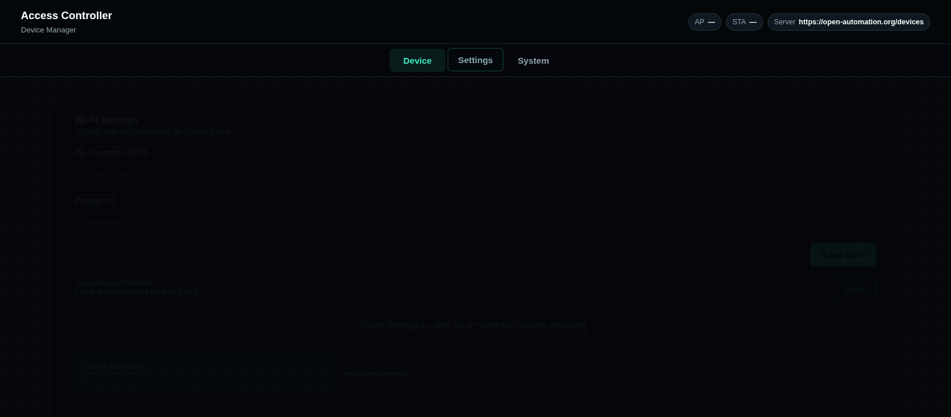
code/controller/tests/artifacts/nav-centered-lan-desktop.png
