Wanzi-z/access-controller/code/controller/tests/artifacts/nav-centered-lan-mobile.png

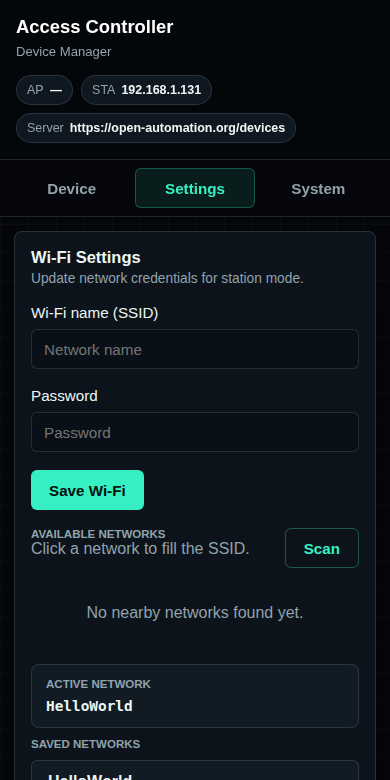
code/controller/tests/artifacts/nav-centered-lan-mobile.png
