Wanzi-z/access-controller/code/controller/tests/artifacts/network-settings-desktop.png

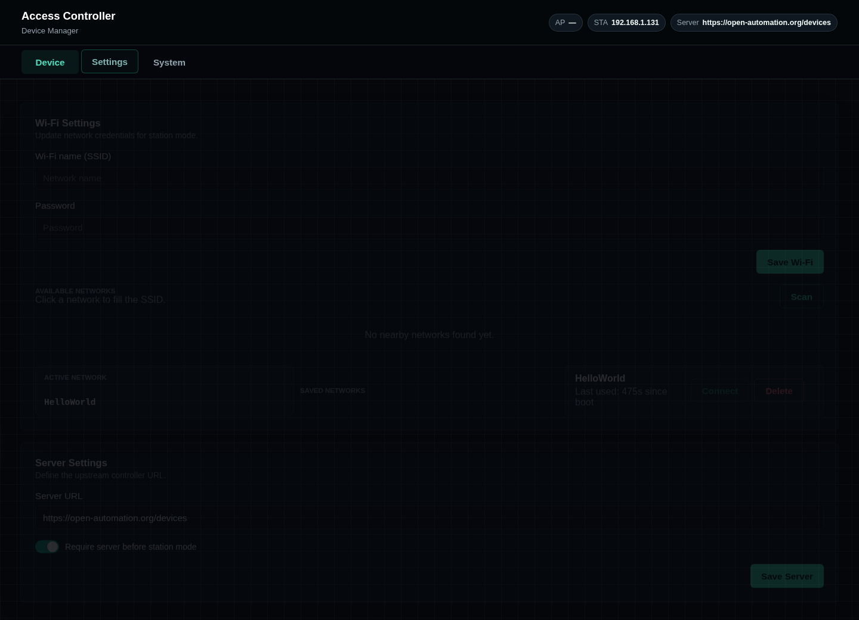
code/controller/tests/artifacts/network-settings-desktop.png
