Wanzi-z/access-controller/code/controller/tests/artifacts/network-settings-mobile.png

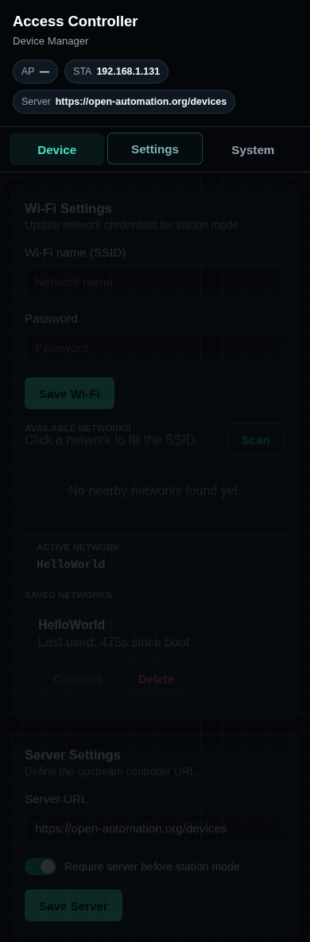
code/controller/tests/artifacts/network-settings-mobile.png
