Wanzi-z/access-controller/code/controller/tests/artifacts/pin-card-layout-live.png

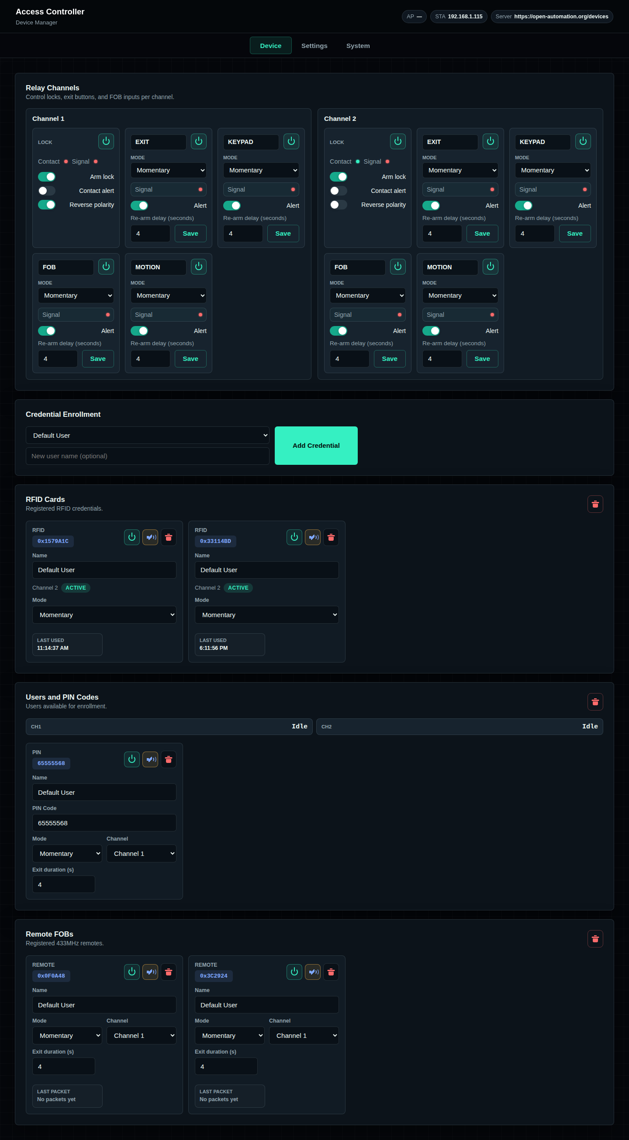
code/controller/tests/artifacts/pin-card-layout-live.png
