Wanzi-z/access-controller/code/controller/tests/artifacts/pin-codes-section-card-smoke.png

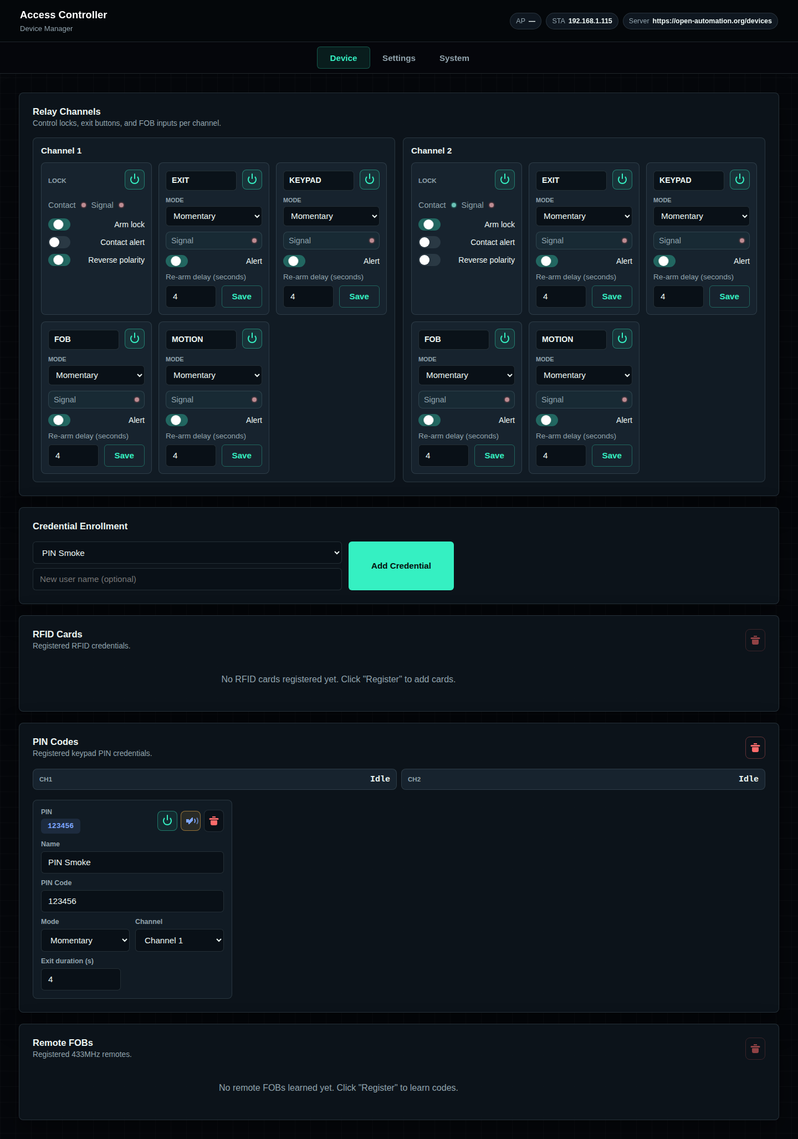
code/controller/tests/artifacts/pin-codes-section-card-smoke.png
