Wanzi-z/access-controller/code/controller/tests/artifacts/pin-live-pending-card-smoke.png

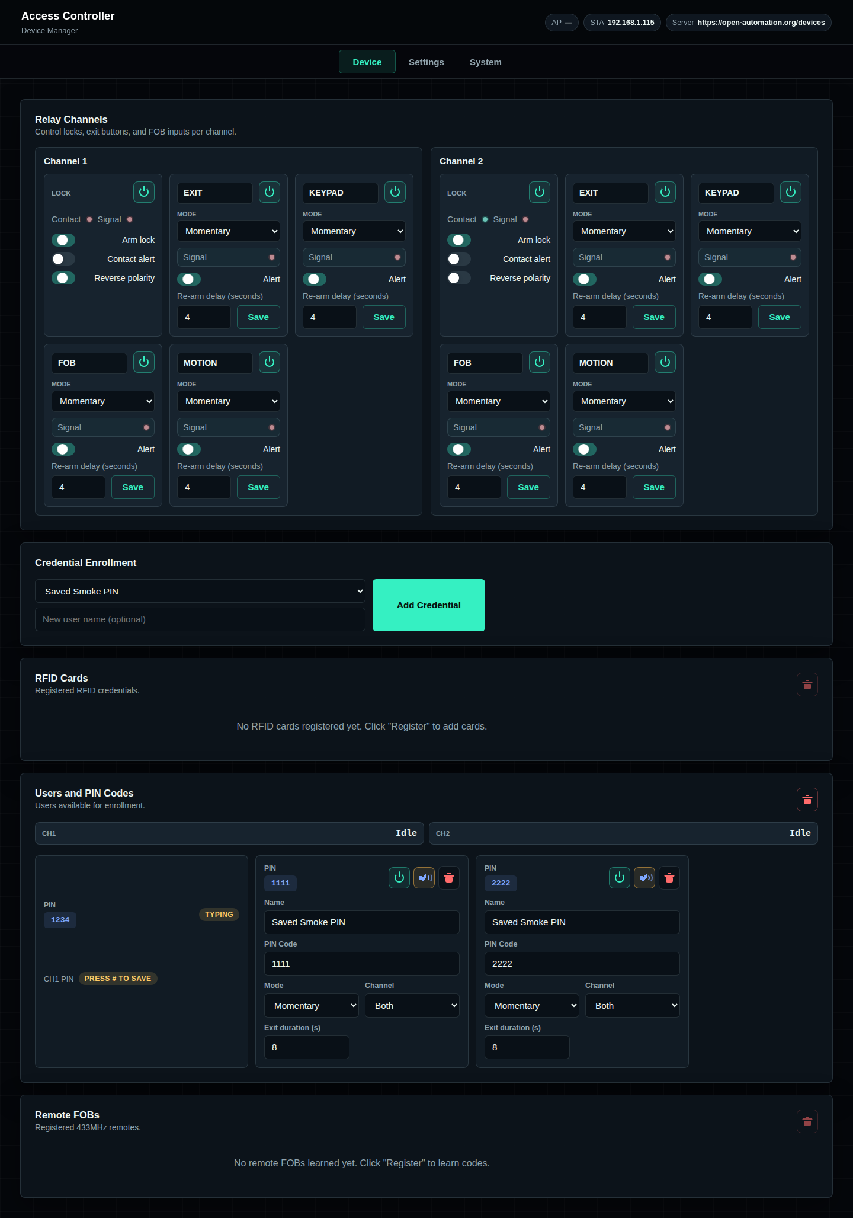
code/controller/tests/artifacts/pin-live-pending-card-smoke.png
