Wanzi-z/access-controller/code/controller/tests/artifacts/pin-pound-activity-refresh-v27.png

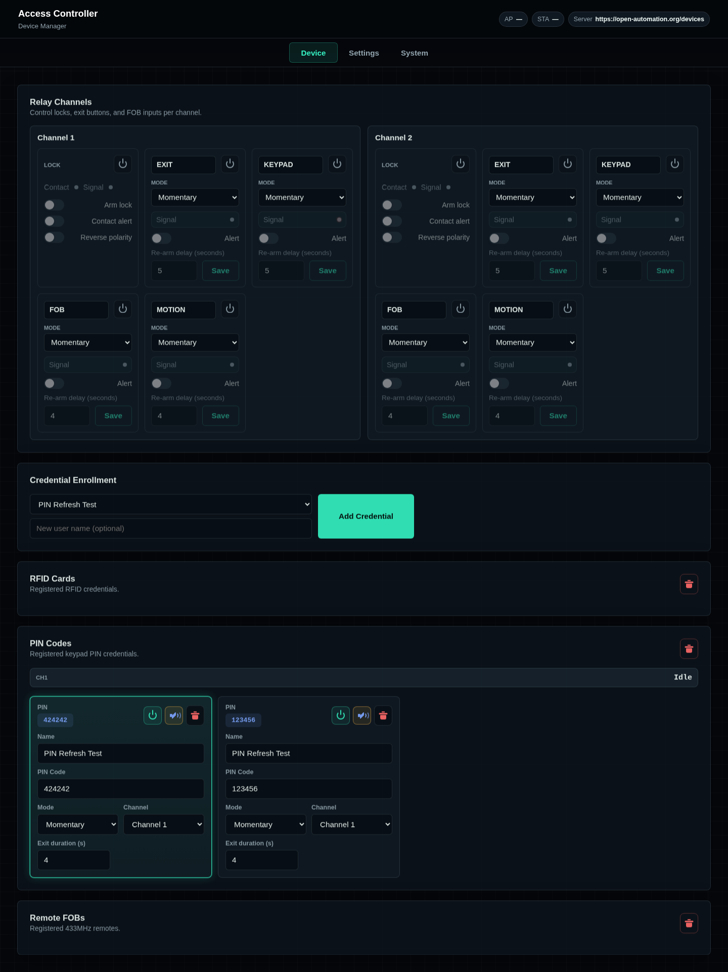
code/controller/tests/artifacts/pin-pound-activity-refresh-v27.png
