Wanzi-z/access-controller/code/controller/tests/artifacts/rf-card-metrics.png

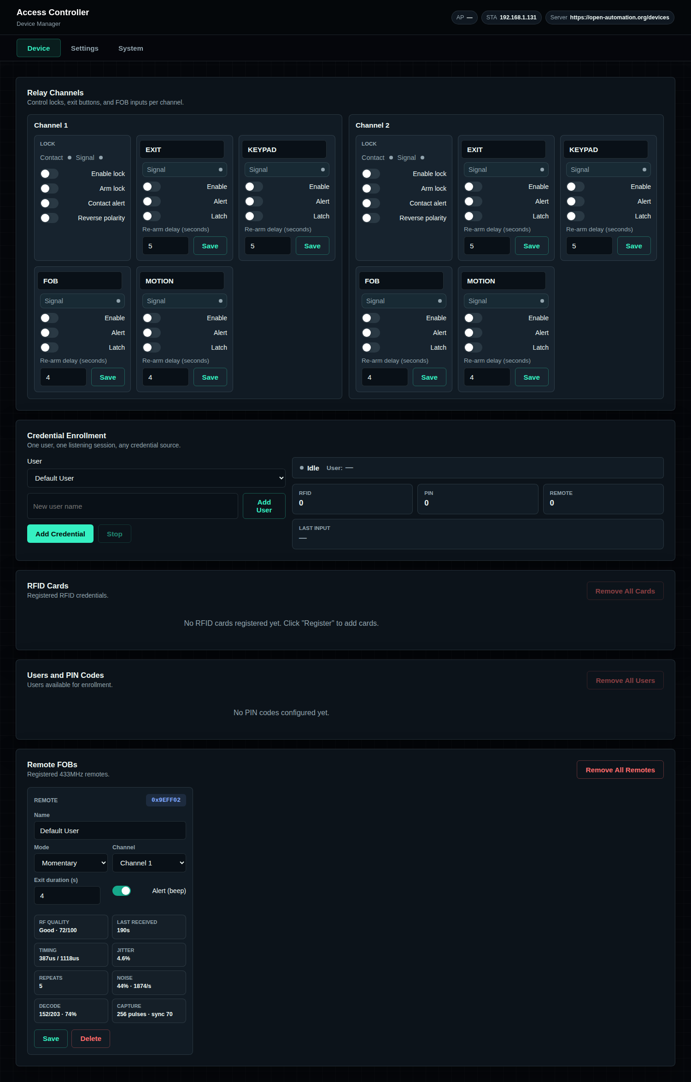
code/controller/tests/artifacts/rf-card-metrics.png
