Wanzi-z/access-controller/code/controller/tests/artifacts/rfid-cards-alert-ui-final.png

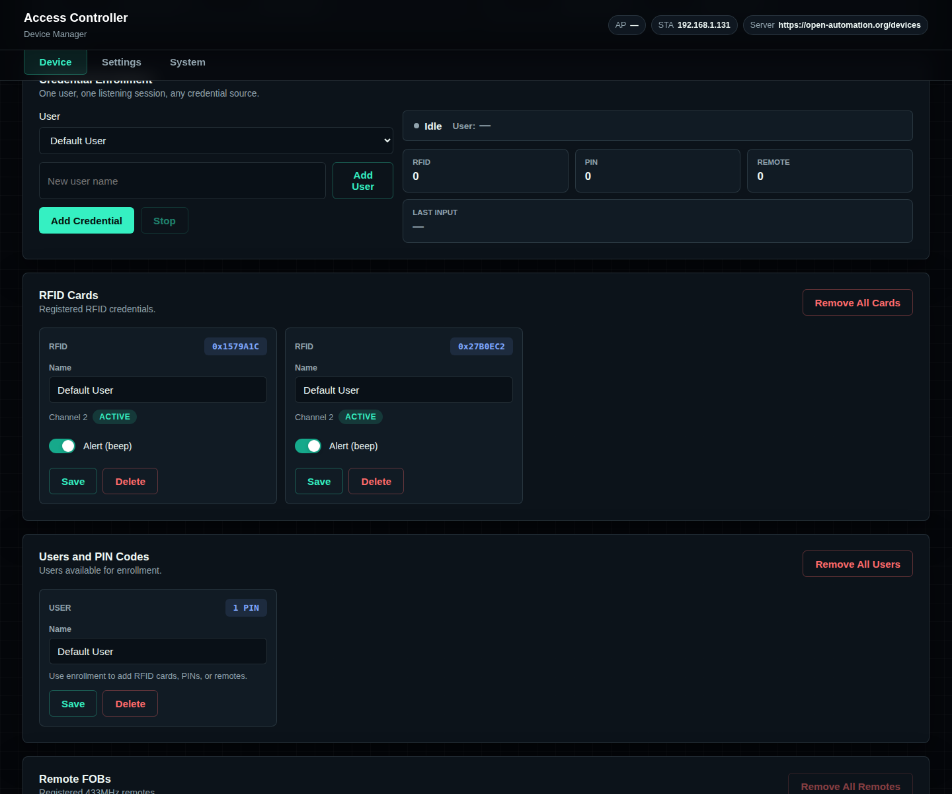
code/controller/tests/artifacts/rfid-cards-alert-ui-final.png
