Wanzi-z/access-controller/code/controller/tests/artifacts/rfid-last-used-final.png

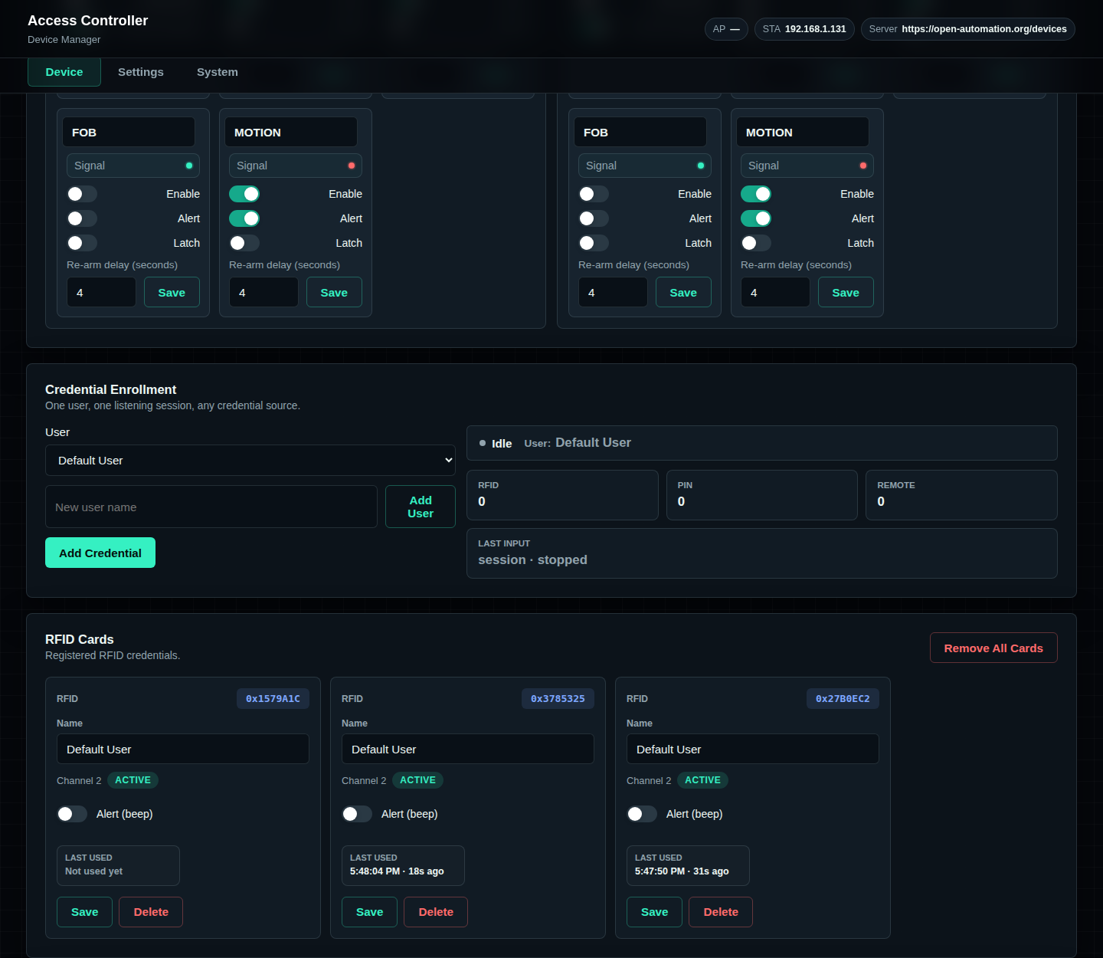
code/controller/tests/artifacts/rfid-last-used-final.png
