Wanzi-z/access-controller/code/controller/tests/artifacts/rfid-live-enrollment-card-smoke.png

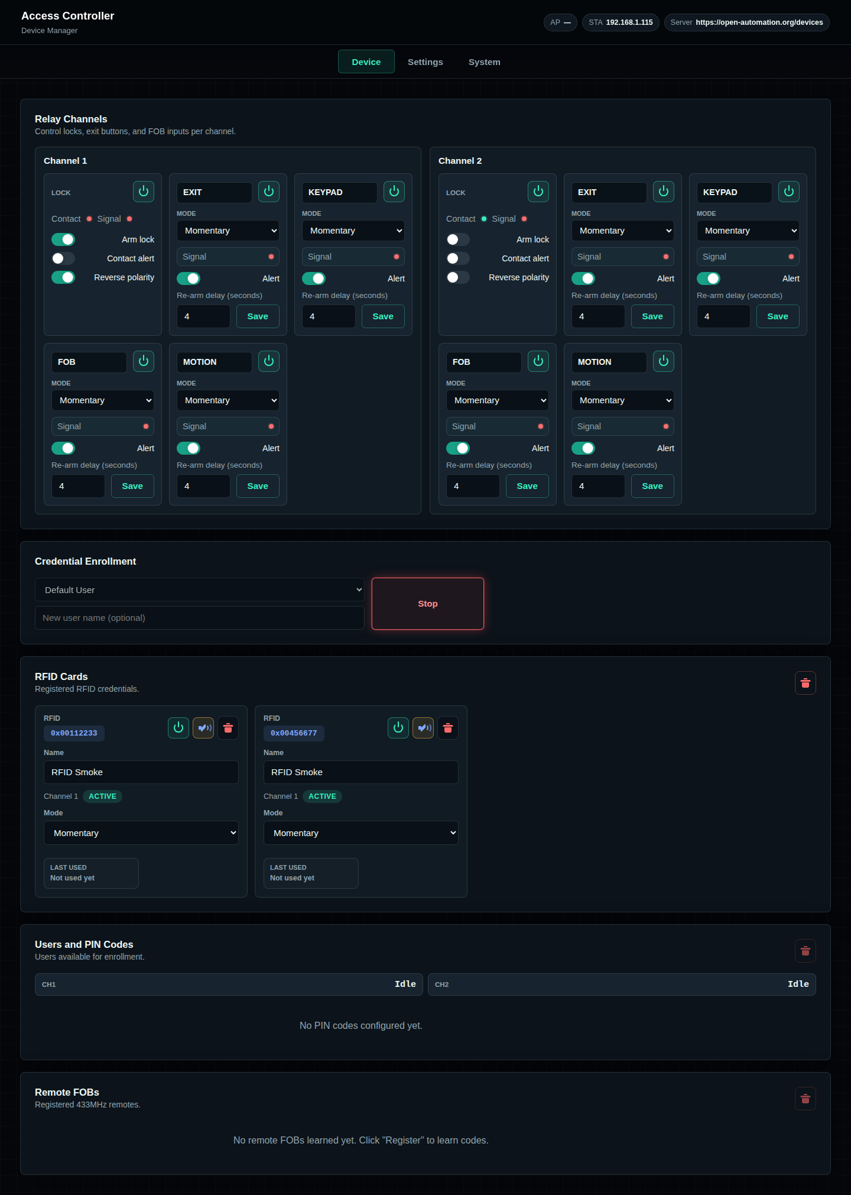
code/controller/tests/artifacts/rfid-live-enrollment-card-smoke.png
