Wanzi-z/access-controller/code/controller/tests/artifacts/system-ota-desktop.png

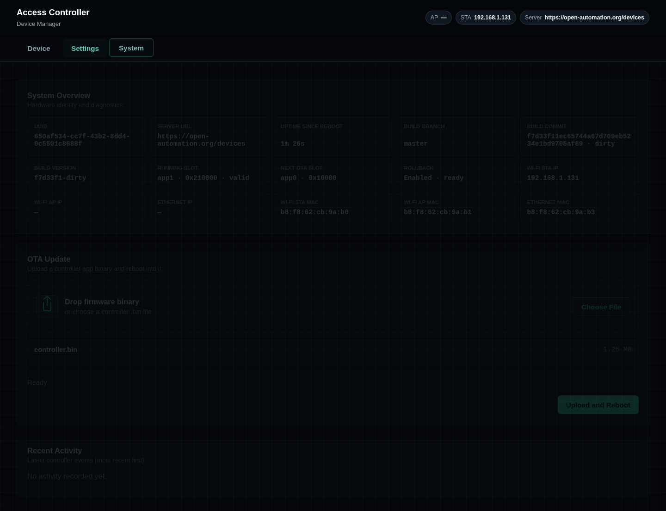
code/controller/tests/artifacts/system-ota-desktop.png
