Wanzi-z/access-controller/circuits/controller/_restore_backup_2026-07-07T06-08-03-889/adapter/Adapter-TE-52/Adapter-TE-52.kicad_pcb

## KiCad design circuits/controller/_restore_backup_2026-07-07T06-08-03-889/adapter/Adapter-TE-52/Adapter-TE-52.kicad_pcb (2026-07-10)

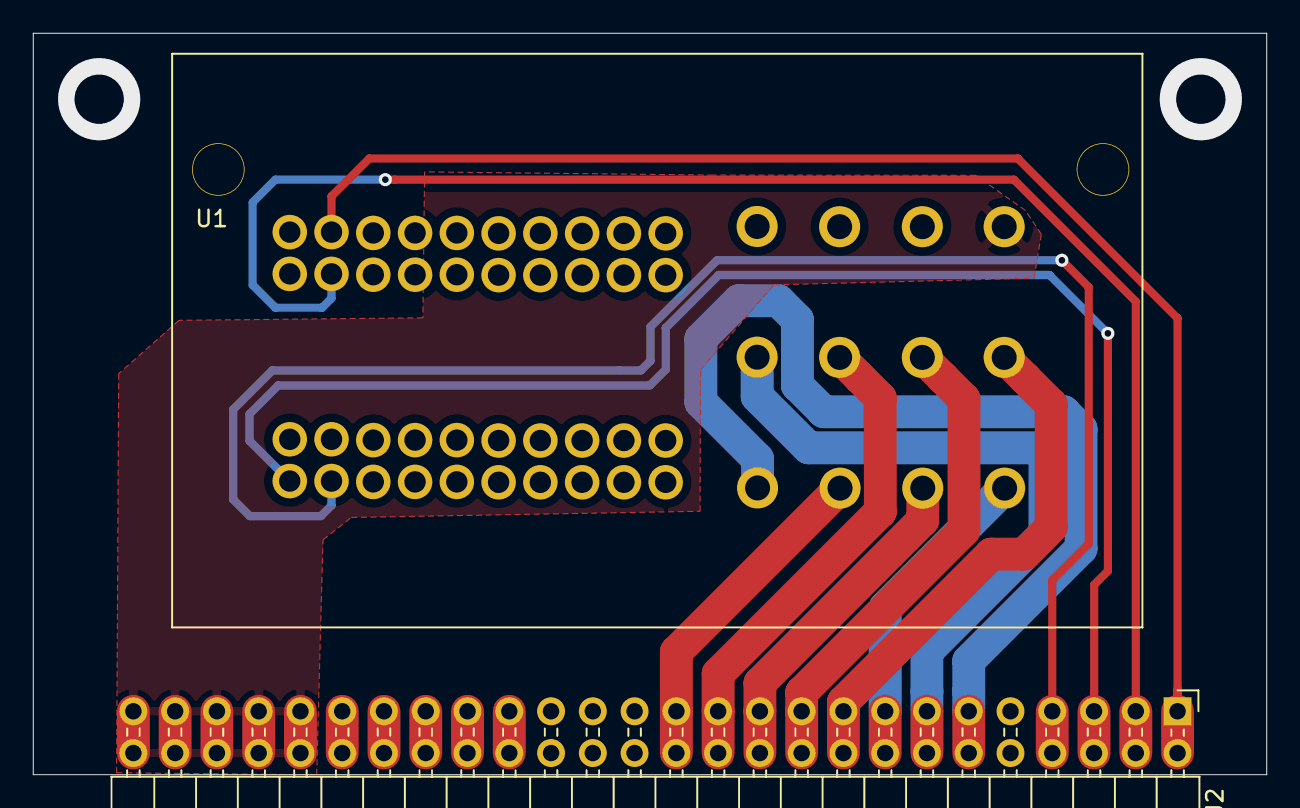
[picture p72: board Adapter-TE-52.kicad_pcb from above]

Board: 2 copper layers, 75.0 x 45.1 mm, 3 parts (1 on the bottom side), 14 nets.

Parts:
LOGO: LOGO
U1: Adapter-TE-52
U2: TE-AUTO-CONN-52

Connections:
/BATTERY: U1.44, U2.44
/CAMERA+: U1.31, U2.31
/CAMERA-: U1.32, U2.32
/CAN+: U1.2, U2.2
/CAN-: U1.12, U2.12
/LF+: U1.47, U2.47
/LF-: U1.51, U2.51
/LR+: U1.48, U2.48
/LR-: U1.52, U2.52
/RF+: U1.46, U2.46
/RF-: U1.50, U2.50
/RR+: U1.45, U2.45
/RR-: U1.49, U2.49
GND: U1.33, U1.43, U2.33, U2.43
