Wanzi-z/access-controller/circuits/controller/_restore_backup_2026-07-07T06-08-03-889/access-controller.kicad_pcb

## KiCad design circuits/controller/_restore_backup_2026-07-07T06-08-03-889/access-controller.kicad_pcb (2026-07-10)

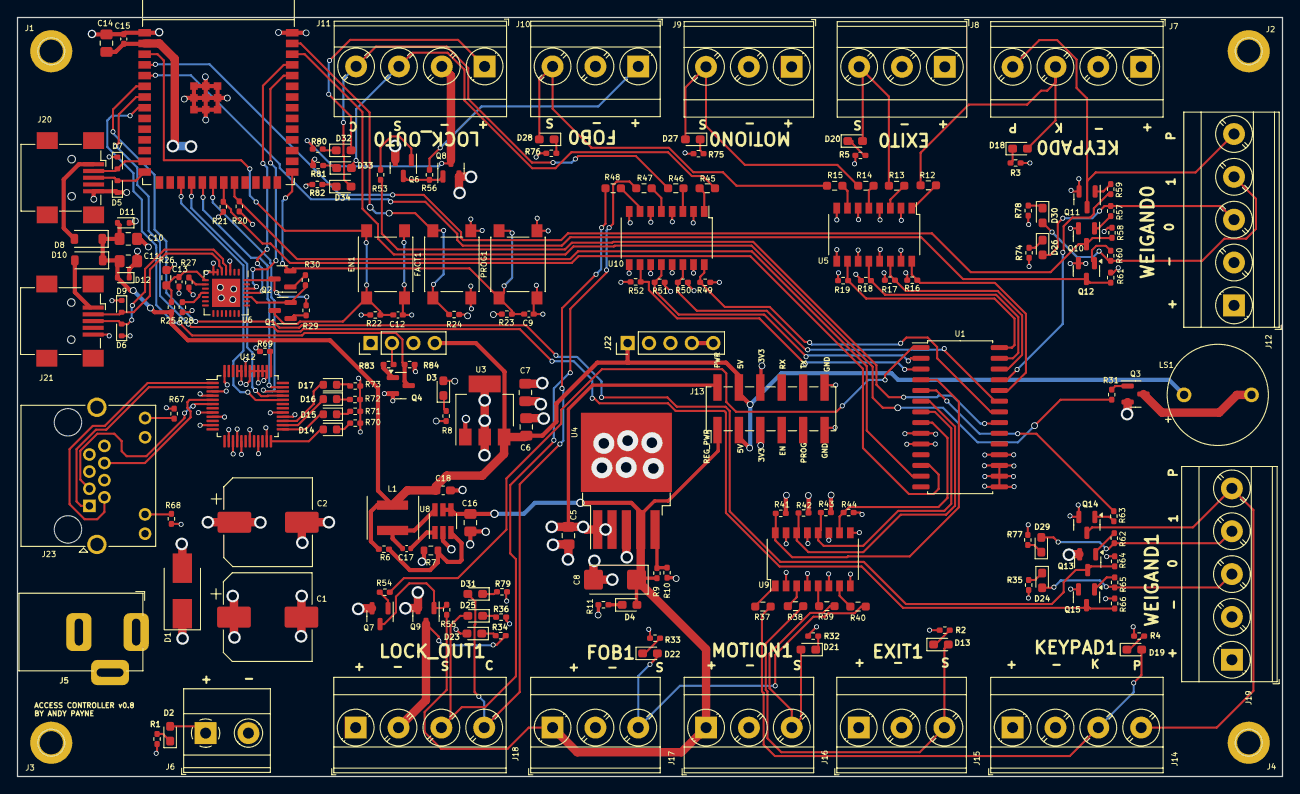
[picture p73: board access-controller.kicad_pcb from above]

Board: 4 copper layers, 150.0 x 90.0 mm, 186 parts (0 on the bottom side), 138 nets.

Parts:
C1, C2: C_470uF; CP_Elec_10x10
C5, C6, C7, C10, C11, C14, C16: C_10uF; C_0805_2012Metric_Pad1.18x1.45mm_HandSolder
C8: C_10uF_Ta; CP_EIA-6032-15_Kemet-U_Pad2.25x2.35mm_HandSolder
C9, C12, C13: 1uF; C_0402_1005Metric_Pad0.74x0.62mm_HandSolder
C15: 100nF; C_0402_1005Metric_Pad0.74x0.62mm_HandSolder
C17: 22nF; C_0402_1005Metric
C18: C_22uF; C_0603_1608Metric_Pad1.08x0.95mm_HandSolder
D1: D_Zener; D_SMB_Handsoldering
D2, D3, D4, D13, D18, D19, D20, D21, D22, D23, D24, D25, D26, D27, D28, D29, D30, D31, D32, D33, D34: White; LED_0603_1608Metric_Pad1.05x0.95mm_HandSolder
D5, D6, D7, D9, D11, D12: ESD_5V; D_SOD-523
D8, D10: D_1N5819HW; D_SOD-123
D14, D15, D16, D17: Red; LED_0603_1608Metric
EN1: SW_PUSH; SW_SPST_PTS645
FACT1: SW_PUSH; SW_SPST_PTS645
J1, J2, J3, J4: Conn_01x01_Female; Mount_Hole
J5: Barrel_Jack_Switch; BarrelJack_OD5.5_ID2.5
J6: Screw_Terminal_01x02; TerminalBlock_Phoenix_MKDS-1,5-2-5.08_1x02_P5.08mm_Horizont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
J7, J11, J14, J18: Terminal_01x04; TerminalBlock_Phoenix_MKDS-3-4-5.08_1x04_P5.08mm_Horizontal
J8, J9, J10, J15, J16, J17: Terminal_01x03; TerminalBlock_Phoenix_MKDS-3-3-5.08_1x03_P5.08mm_Horizontal
J12, J19: Screw_Terminal_01x05; TerminalBlock_Phoenix_MKDS-3-5-5.08_1x05_P5.08mm_Horizontal
J13: Conn_02x06_Odd_Even; PinHeader_2x06_P2.54mm_Vertical_SMD
J20, J21: USB_MINI_B; USB_Mini-B_Wuerth_65100516121_Horizontal
J22: RF_MODULE; RXB6_RF_MODULE
J23: CONN_RJ45; RJ45_Amphenol_RJHSE538X
L1: 10uH; L_4x4
LS1: TMB12A05; S_YXDZ
PROG1: SW_PUSH; SW_SPST_PTS645
Q1: Q_L8050QLT1G; SOT-23
Q2: Q_L8550HQLT1G; SOT-23
Q3, Q4, Q6, Q7, Q10, Q11, Q12, Q13, Q14, Q15: Q_MMBT5551; SOT-23
Q8, Q9: Q_AO3400A; SOT-23
R1, R2, R3, R4, R5, R8, R11, R20, R21, R22, R23, R24, R28, R29, R30, R32, R33, R34, R35, R36, R67, R68, R74, R75, R76, R77, R78, R79, R80, R81, R82, R83, R84: 10K; R_0402_1005Metric_Pad0.72x0.64mm_HandSolder
R6: 100K; R_0402_1005Metric_Pad0.72x0.64mm_HandSolder
R7: 13K; R_0603_1608Metric
R9: R_20K; R_0402_1005Metric_Pad0.72x0.64mm_HandSolder
R10: R_2.2K; R_0402_1005Metric_Pad0.72x0.64mm_HandSolder
R12, R13, R14, R15, R37, R38, R39, R40, R45, R46, R47, R48: R_1K; R_0603_1608Metric_Pad0.98x0.95mm_HandSolder
R16, R17, R18, R19, R41, R42, R43, R44, R49, R50, R51, R52, R53, R54, R55, R56: R_10K_0402; R_0402_1005Metric_Pad0.72x0.64mm_HandSolder
R25: 22.1K; R_0402_1005Metric_Pad0.72x0.64mm_HandSolder
R26: 47.5K; R_0603_1608Metric_Pad0.98x0.95mm_HandSolder
R27, R69, R70, R71, R72, R73: 1K; R_0402_1005Metric_Pad0.72x0.64mm_HandSolder
R31, R59, R63: R_100; R_0402_1005Metric_Pad0.72x0.64mm_HandSolder
R57, R58, R60, R61, R62, R64, R65, R66: R_1K_0402; R_0402_1005Metric_Pad0.72x0.64mm_HandSolder
U1: MCP23017_SS; SOIC-28W_7.5x17.9mm_P1.27mm
U3: REG_AMS1117-3.3; SOT-223-3_TabPin2
U4: MIC29302WU; TO-263-5_TabPin3
U5, U9, U10: TLP291-4; SOP-16_4.4x10.4mm_P1.27mm
U6: CP2102N-Axx-xQFN28; QFN-28-1EP_5x5mm_P0.5mm_EP3.35x3.35mm
U7: ESP32-S3-WROOM-1
U8: REG_MT2492; SOT-23-6_Handsoldering
U12: W5500; LQFP-48_7x7mm_P0.5mm

Connections:
/3V3: C7.1, C14.1, C15.1, D3.2 (A), J13.5, J13.6, R16.1, R17.1, R18.1, R19.1, R20.1, R21.2, R22.1, R23.1, R24.1, R27.1, R41.1, R42.1, R43.1, R44.1, R49.1, R50.1, R51.1, R52.1, R58.2, R61.2, R64.2, R66.2, R67.2, R69.2, R84.1, U1.9 (VDD), U1.18 (~RESET), U3.2 (Vout), U6.6 (VDD), U6.7 (VREGIN), U7.2 (3V3), U12.4 (AVDD), U12.8 (AVDD), U12.11 (AVDD), U12.15 (AVDD), U12.17 (AVDD), U12.21 (AVDD), U12.28 (VDD), U12.43 (PMODE2)
/5V: C6.1, C10.1, C11.1, C18.1, D8.1 (K), D10.1 (K), D11.2 (A2), D12.2 (A2), J13.3, J13.4, J22.4, J22.5, L1.2, LS1.1, R6.1, R25.2, U3.3 (Vin)
/ANTENNA: J22.8, J22.9
/BUZZER: R31.1, U7.38 (GPIO2/TOUCH2/ADC1_CH1)
/CS: U7.17 (GPIO9/TOUCH9/ADC1_CH8/FSPIHD/SUBSPIHD), U12.32 (~SCS)
/DATA: J22.2, R83.2
/DATA_IO: Q4.3 (C), R84.2, U7.8 (GPIO15/U0RTS/ADC2_CH4/XTAL_32K_P)
/EXIT0: D20.2 (A), J8.3, R13.2
/EXIT0_SENSE: R17.2, U1.26 (GPA5), U5.14
/EXIT1: D13.2 (A), J15.3, R38.2
/EXIT1_SENSE: R42.2, U1.6 (GPB5), U9.14
/Ethernet/RX_N: J23.6, U12.5 (RXN)
/Ethernet/RX_P: J23.3, U12.6 (RXP)
/Ethernet/TX_N: J23.2, U12.1 (TXN)
/Ethernet/TX_P: J23.1, U12.2 (TXP)
/FOB0: D28.2 (A), J10.3, R15.2
/FOB0_SENSE: R19.2, U1.28 (GPA7), U5.10
/FOB1: D22.2 (A), J17.3, R40.2
/FOB1_SENSE: R44.2, U1.8 (GPB7), U9.10
/KEYPAD0: D18.2 (A), J7.3, R12.2
/KEYPAD0_SENSE: R16.2, U1.24 (GPA3), U5.16
/KEYPAD1: D19.2 (A), J14.3, R37.2
/KEYPAD1_SENSE: R41.2, U1.4 (GPB3), U9.16
/LOCK0_CLOSE: D34.2 (A), J11.4, R46.2
/LOCK0_CLOSE_IO: R50.2, U1.23 (GPA2), U10.14
/LOCK0_CONTROL: R53.2, U1.21 (GPA0)
/LOCK0_OUT: J11.2, Q8.3 (D), R80.1
/LOCK0_SENSE: R49.2, U1.22 (GPA1), U10.16
/LOCK0_STATE: D33.2 (A), J11.3, R45.2
/LOCK1_CLOSE: D31.2 (A), J18.4, R48.2
/LOCK1_CLOSE_IO: R52.2, U1.3 (GPB2), U10.10
/LOCK1_CONTROL: R54.2, U1.1 (GPB0)
/LOCK1_OUT: J18.2, Q9.3 (D), R34.1
/LOCK1_SENSE: R51.2, U1.2 (GPB1), U10.12
/LOCK1_STATE: D25.2 (A), J18.3, R47.2
/MISO: U7.20 (GPIO12/TOUCH12/ADC2_CH1/FSPICLK/FSPIIO6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), U12.34 (MISO)
/MOSI: U7.19 (GPIO11/TOUCH11/ADC2_CH0/FSPID/FSPIIO5/S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), U12.35 (MOSI)
/MOTION0: D27.2 (A), J9.3, R14.2
/MOTION0_SENSE: R18.2, U1.27 (GPA6), U5.12
/MOTION1: D21.2 (A), J16.3, R39.2
/MOTION1_SENSE: R43.2, U1.7 (GPB6), U9.12
/Microcontroller/D+: D6.2 (A2), J21.3 (D+), U6.4 (D+)
/Microcontroller/D-: D9.2 (A2), J21.2 (D-), U6.5 (D-)
/Microcontroller/DTR: Q2.3 (C), R29.1, U6.28 (~DTR)
/Microcontroller/EN: C12.1, EN1.1, Q1.3 (C), R22.2, U7.3 (EN)
/Microcontroller/FACT: FACT1.1, R24.2, U7.39 (GPIO1/TOUCH1/ADC1_CH0)
/Microcontroller/IO19: D7.2 (A2), J20.2 (D-), U7.13 (GPIO19/U1RTS/ADC2_CH8/CLK_OUT2/USB_D-)
/Microcontroller/IO20: D5.2 (A2), J20.3 (D+), U7.14 (GPIO20/U1CTS/ADC2_CH9/CLK_OUT1/USB_D+)
/Microcontroller/IO43: U6.25 (RXD), U7.37 (U0TXD/GPIO43/CLK_OUT1)
/Microcontroller/IO44: U6.26 (TXD), U7.36 (U0RXD/GPIO44/CLK_OUT2)
/Microcontroller/PROG: C9.1, PROG1.1, Q2.2 (E), R23.2, U7.27 (GPIO0/BOOT)
/Microcontroller/RTS: Q1.2 (E), R30.1, U6.24 (~RTS)
/POWER: C1.1, C2.1, C5.1, D1.1 (K), D2.2 (A), D23.2 (A), D32.2 (A), J5.1, J6.1, J11.1, J13.2, J18.1, J23.4, J23.5, R68.2, U4.1 (EN), U4.2 (IN)
/PUSH0: J7.4, J12.5, Q11.3 (C)
/PUSH0_IO: R59.1, U1.25 (GPA4)
/PUSH1: J14.4, J19.5, Q14.3 (C)
/PUSH1_IO: R63.1, U1.5 (GPB4)
/REG_POWER: C8.1, C16.1, D4.2 (A), J7.1, J8.1, J9.1, J10.1, J12.1, J13.1, J14.1, J15.1, J16.1, J17.1, J19.1, R9.1, R55.2, R56.2, U4.4 (Output), U8.4 (EN), U8.5 (VIN)
/SCL: R21.1, U1.12 (SCK), U7.21 (GPIO13/TOUCH13/ADC2_CH2/FSPIQ/FSPIIO7/S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)
/SCLK: U7.18 (GPIO10/TOUCH10/ADC1_CH9/FSPICS0/FSPIIO4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), U12.33 (SCLK)
/SDA: R20.2, U1.13 (SDA), U7.22 (GPIO14/TOUCH14/ADC2_CH3/FSPIWP/FSPIDQS/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)
/WG0_DATA0: D26.2 (A), J12.3, R57.2
/WG0_DATA1: D30.2 (A), J12.4, R60.2
/WG0_DATA_SENSE0: Q10.3 (C), R58.1, U7.4 (GPIO4/TOUCH4/ADC1_CH3)
/WG0_DATA_SENSE1: Q12.3 (C), R61.1, U7.5 (GPIO5/TOUCH5/ADC1_CH4)
/WG1_DATA0: D24.2 (A), J19.3, R65.2
/WG1_DATA1: D29.2 (A), J19.4, R62.2
/WG1_DATA_SENSE0: Q13.3 (C), R64.1, U7.6 (GPIO6/TOUCH6/ADC1_CH5)
/WG1_DATA_SENSE1: Q15.3 (C), R66.1, U7.7 (GPIO7/TOUCH7/ADC1_CH6)
GND: C1.2, C2.2, C5.2, C6.2, C7.2, C8.2, C9.2, C10.2, C11.2, C12.2, C13.2, C14.2, C15.2, C16.2, C18.2, D1.2 (A), D5.1 (A1), D6.1 (A1), D7.1 (A1), D9.1 (A1), D11.1 (A1), D12.1 (A1), EN1.2, FACT1.2, J1.1, J2.1, J3.1, J4.1, J5.2, J5.3, J6.2, J7.2, J8.2, J9.2, J10.2, J12.2, J13.11, J13.12, J14.2, J15.2, J16.2, J17.2, J19.2, J20.5 (GND), J21.5 (GND), J22.1, J22.6, J22.7, J23.7, J23.8, J23.9, J23.11, PROG1.2, Q3.2 (E), Q4.2 (E), Q6.2 (E), Q7.2 (E), Q8.2 (S), Q9.2 (S), Q10.2 (E), Q11.2 (E), Q12.2 (E), Q13.2 (E), Q14.2 (E), Q15.2 (E), R1.1, R2.1, R3.1, R4.1, R5.1, R7.2, R8.1, R10.2, R11.1, R26.1, R28.2, R32.1, R33.1, R35.1, R36.1, R70.2, R71.2, R72.2, R73.2, R74.1, R75.1, R76.1, R77.1, R78.1, R79.1, R81.1, R82.1, U1.10 (VSS), U1.15 (A0), U1.16 (A1), U1.17 (A2), U3.1 (GND), U4.3 (GND), U5.2, U5.4, U5.6, U5.8, U5.9, U5.11, U5.13, U5.15, U6.3 (GND), U6.29 (GND), U7.1 (GND), U7.40 (GND), U7.41 (GND), U8.2 (GND), U9.2, U9.4, U9.6, U9.8, U9.9, U9.11, U9.13, U9.15, U10.2, U10.4, U10.6, U10.8, U10.9, U10.11, U10.13, U10.15, U12.3 (AGND), U12.9 (AGND), U12.14 (AGND), U12.16 (AGND), U12.19 (AGND), U12.23 (RSVD), U12.29 (GND), U12.38 (RSVD), U12.39 (RSVD), U12.40 (RSVD), U12.41 (RSVD), U12.42 (RSVD), U12.44 (PMODE1), U12.45 (PMODE0), U12.48 (AGND)
unnamed: D2.1 (K), R1.2
unnamed: D3.1 (K), R8.2
unnamed: D4.1 (K), R11.2
unnamed: D8.2 (A), J20.1 (VBUS)
unnamed: D10.2 (A), J21.1 (VBUS)
unnamed: D13.1 (K), R2.2
unnamed: D14.2 (A), U12.24 (SPDLED)
unnamed: D14.1 (K), R70.1
unnamed: D15.2 (A), U12.25 (LINKLED)
unnamed: D15.1 (K), R71.1
unnamed: D16.2 (A), U12.26 (DUPLED)
unnamed: D16.1 (K), R72.1
unnamed: D17.2 (A), U12.27 (ACTLED)
unnamed: D17.1 (K), R73.1
unnamed: D18.1 (K), R3.2
unnamed: D19.1 (K), R4.2
unnamed: D20.1 (K), R5.2
unnamed: D21.1 (K), R32.2
unnamed: D22.1 (K), R33.2
unnamed: D23.1 (K), R34.2
unnamed: D24.1 (K), R35.2
unnamed: D25.1 (K), R36.2
unnamed: D26.1 (K), R74.2
unnamed: D27.1 (K), R75.2
unnamed: D28.1 (K), R76.2
unnamed: D29.1 (K), R77.2
unnamed: D30.1 (K), R78.2
unnamed: D31.1 (K), R79.2
unnamed: D32.1 (K), R80.2
unnamed: D33.1 (K), R81.2
unnamed: D34.1 (K), R82.2
unnamed: J23.10, R68.1
unnamed: J23.12, R67.1
unnamed: Q1.1 (B), R29.2
unnamed: Q2.1 (B), R30.2
unnamed: Q3.1 (B), R31.2
unnamed: LS1.2, Q3.3 (C)
unnamed: Q4.1 (B), R83.1
unnamed: Q6.1 (B), R53.1
unnamed: Q6.3 (C), Q8.1 (G), R56.1
unnamed: Q7.1 (B), R54.1
unnamed: Q7.3 (C), Q9.1 (G), R55.1
unnamed: Q10.1 (B), R57.1
unnamed: Q11.1 (B), R59.2
unnamed: Q12.1 (B), R60.1
unnamed: Q13.1 (B), R62.1
unnamed: Q14.1 (B), R63.2
unnamed: Q15.1 (B), R65.1
unnamed: R12.1, U5.1
unnamed: R13.1, U5.3
unnamed: R14.1, U5.5
unnamed: R15.1, U5.7
unnamed: R37.1, U9.1
unnamed: R38.1, U9.3
unnamed: R39.1, U9.5
unnamed: R40.1, U9.7
unnamed: R45.1, U10.1
unnamed: R46.1, U10.3
unnamed: R47.1, U10.5
unnamed: R48.1, U10.7
unnamed: R9.2, R10.1, U4.5 (Feedback)
unnamed: C13.1, R25.1, R26.2, U6.8 (VBUS)
unnamed: R27.2, U6.9 (~RST)
unnamed: R28.1, U6.11 (~SUSPEND)
unnamed: C17.1, U8.1 (BS)
unnamed: R6.2, R7.1, U8.3 (FB)
unnamed: C17.2, L1.1, U8.6 (SW)
unnamed: R69.1, U12.37 (~RST)
