Wanzi-z/access-controller/code/controller/main/services/lock.c

#include <stdio.h>
#include <string.h>
#include "freertos/FreeRTOS.h"
#include "freertos/semphr.h"
#include "freertos/task.h"
#include "esp_log.h"
#include "cJSON.h"
#include "automation.h"
#include "esp_timer.h"

// Function declarations
bool get_io(uint8_t io);
void set_io(uint8_t io, bool val);
void set_mcp_io_dir(uint8_t io, bool dir);
void set_mcp_io(uint8_t io, bool val);
bool get_mcp_io(uint8_t io);
void set_bool(const char *key, bool value);
bool get_bool(const char *key, bool default_value);
void beep(int cnt);
void longBeep(int cnt);
void beep_keypad(int beeps, int channel);
void beep_keypad_force(int beeps, int channel);
void alert_output_signal(int beeps, int channel, int target);
bool wiegand_pin_entry_active(int channel);
int alert_target_from_bool(bool alert);
int alert_target_from_string(const char *value, bool fallback_alert);
const char *alert_target_to_string(int target);

// MCP definitions
#define MCP_OUTPUT 0
#define MCP_INPUT  1

// MCP pin definitions
#define MCP_A0  0
#define MCP_A1  1
#define MCP_A2  2
#define MCP_A3  3
#define MCP_A4  4
#define MCP_A5  5
#define MCP_A6  6
#define MCP_A7  7
#define MCP_B0  8
#define MCP_B1  9
#define MCP_B2  10
#define MCP_B3  11
#define MCP_B4  12
#define MCP_B5  13
#define MCP_B6  14
#define MCP_B7  15

#define LOCK_MCP_IO_1       MCP_A0
#define LOCK_MCP_IO_2       MCP_B0
#define NUM_OF_LOCKS        2

/* Channel 1 = LOCK0: GPA1=SENSE, GPA2=CLOSE_IO. Channel 2 = LOCK1: GPB1=SENSE, GPB2=CLOSE_IO */
const uint8_t LOCK_CONTACT_PIN_1 = A2;  /* LOCK0_CLOSE_IO (GPA2) */
const uint8_t LOCK_CONTACT_PIN_2 = B2;  /* LOCK1_CLOSE_IO (GPB2) */

const uint8_t LOCK_SIGNAL_PIN_1 = A1;   /* LOCK0_SENSE (GPA1) */
const uint8_t LOCK_SIGNAL_PIN_2 = B1;   /* LOCK1_SENSE (GPB1) */

bool ARM = false;
bool ALERT = true;
char lock_service_message[1000];
bool lock_service_message_ready = false;
int relock_delay = 2 * 1000;
int button_disabled = false;
cJSON *lock_payload = NULL;
int LOCK_DEBOUNCE_DELAY = 5;
bool lock_contact_timer_1_expired = true;
int lock_count = 0;

typedef struct {
    uint8_t controlPin;
    uint8_t contactPin;
	uint8_t signalPin;
    uint8_t channel;
    bool isContact;
    bool prevIsContact;
	bool shouldLock;
    bool isLocked;
	bool isSignal;
    bool pulse;
    bool fail_secure;
    bool expired;
    bool enable;
    bool enableContactAlert;
    int alert_target;
    int delay;
    int count;
    bool alert;
	bool sentSignalAlert;
	bool sentContactAlert;
    cJSON *payload;
    char settings[200];
    char key[50];
    char type[40];
} Lock;

Lock locks[NUM_OF_LOCKS];

/*
 * Map an input's configured lock target (channel_mask, 1=Lock1, 2=Lock2, 3=both)
 * onto the locks that are actually enabled. If the targeted lock(s) are all
 * disabled, fall back to the lowest-numbered enabled lock so an input wired to
 * the "other" channel still fires the enabled (e.g. front-entrance) lock instead
 * of silently doing nothing. This mirrors the web UI, which normalizes the shown
 * target to the enabled locks the same way.
 */
int lock_resolve_target_mask(int mask) {
    if (mask <= 0 || mask > 3) {
        return mask;  // invalid/unspecified; leave defaulting to the caller
    }
    int enabled_mask = 0;
    for (int i = 0; i < NUM_OF_LOCKS; i++) {
        if (locks[i].enable) {
            enabled_mask |= (1 << (locks[i].channel - 1));
        }
    }
    if (enabled_mask == 0) {
        return mask;  // nothing enabled to redirect to
    }
    int resolved = mask & enabled_mask;
    if (resolved != 0) {
        return resolved;  // at least one targeted lock is enabled
    }
    for (int bit = 0; bit < NUM_OF_LOCKS; bit++) {
        if (enabled_mask & (1 << bit)) {
            return (1 << bit);  // lowest-numbered enabled lock
        }
    }
    return mask;
}

static char s_last_action_source[24] = "sys";
static SemaphoreHandle_t s_action_source_mutex;
static StaticSemaphore_t s_action_source_mutex_storage;
static TaskHandle_t s_action_source_owner;
static portMUX_TYPE s_action_source_init_mux = portMUX_INITIALIZER_UNLOCKED;

static void lock_action_source_ensure_mutex(void) {
    if (s_action_source_mutex) {
        return;
    }
    taskENTER_CRITICAL(&s_action_source_init_mux);
    if (!s_action_source_mutex) {
        s_action_source_mutex = xSemaphoreCreateMutexStatic(&s_action_source_mutex_storage);
    }
    taskEXIT_CRITICAL(&s_action_source_init_mux);
}

void lock_set_action_source(const char *source) {
    const char *fallback = "sys";
    if (!source || source[0] == '\0') {
        source = fallback;
    }
    lock_action_source_ensure_mutex();
    if (s_action_source_mutex && xSemaphoreTake(s_action_source_mutex, portMAX_DELAY) == pdTRUE) {
        s_action_source_owner = xTaskGetCurrentTaskHandle();
        strlcpy(s_last_action_source, source, sizeof(s_last_action_source));
    }
}

static void lock_action_source_consume(char *source, size_t source_len) {
    const char *selected = "sys";
    TaskHandle_t current = xTaskGetCurrentTaskHandle();
    bool owned_by_current = s_action_source_owner && s_action_source_owner == current;
    if (owned_by_current) {
        selected = s_last_action_source;
    }
    strlcpy(source, selected, source_len);
    if (owned_by_current) {
        strlcpy(s_last_action_source, "sys", sizeof(s_last_action_source));
        s_action_source_owner = NULL;
        xSemaphoreGive(s_action_source_mutex);
    }
}

static bool lock_source_is_auto_rearm(const char *source) {
    return source &&
        (strcmp(source, "exit_auto") == 0 ||
         strcmp(source, "fob_auto") == 0 ||
         strcmp(source, "motion_auto") == 0 ||
         strcmp(source, "kp_auto") == 0 ||
         strcmp(source, "wg_auto") == 0 ||
         strcmp(source, "wg_pin_auto") == 0);
}

static bool lock_source_is_aux_input(const char *source) {
    if (!source || lock_source_is_auto_rearm(source)) {
        return false;
    }
    return strncmp(source, "exit_", 5) == 0 ||
           strncmp(source, "fob_", 4) == 0 ||
           strncmp(source, "motion", 6) == 0 ||
           strncmp(source, "kp_", 3) == 0;
}

void start_lock_contact_timer(Lock *lck, bool val) {
    lck->expired = !val;
    lck->count = 0;
    if (val) {
        lck->sentSignalAlert = false;
        lck->sentContactAlert = false;
    }
}

void check_lock_contact_timer(Lock *lck) {
	if (!lck->enable) return;
	if (lck->expired) return;
	char log_msg[500];

    if (lck->count >= lck->delay
        && lck->shouldLock
        && (!lck->isSignal || !lck->isContact)
        && lck->enableContactAlert
        && lck->enable
        && !lck->expired)
    {
        if (!lck->isSignal && !lck->sentSignalAlert) {
            snprintf(log_msg, sizeof(log_msg), 
                "{\"event_type\":\"log\",\"payload\":"
                "{\"service_id\":\"ac_1\", "
                "\"type\":\"access-control\", "
                "\"description\":\"No armed status coming from lock.\", "
                "\"event\":\"authentication\", "
                "\"value\":\"true\"}"
                "}");
            addServerMessageToQueue(log_msg);
            lck->sentSignalAlert = true;
        }
        if (!lck->isContact && !lck->sentContactAlert) {
            snprintf(log_msg, sizeof(log_msg), 
                "{\"event_type\":\"log\",\"payload\":"
                "{\"service_id\":\"ac_1\", "
                "\"type\":\"access-control\", "
                "\"description\":\"Door is still open when armed.\", "
                "\"event\":\"authentication\", "
                "\"value\":\"true\"}"
                "}");
            addServerMessageToQueue(log_msg);
            lck->sentContactAlert = true;
        }
        if (!wiegand_pin_entry_active(lck->channel)) {
            alert_output_signal(1, 0, lck->alert_target);
            ESP_LOGI(TAG, "Contact alert beep lock %d (contact=%d signal=%d)",
                     lck->channel,
                     lck->isContact ? 1 : 0,
                     lck->isSignal ? 1 : 0);
        }
        lck->expired = true;
    } else {
        lck->sentSignalAlert = false;
        lck->sentContactAlert = false;
        lck->count++;
    }

    // check for contact change and send opened or closed event depending on the contact state
    if (lck->isContact != lck->prevIsContact) {
		if (lck->isContact) {
			snprintf(log_msg, sizeof(log_msg), 
				"{\"event_type\":\"log\",\"payload\":"
				"{\"service_id\":\"ac_1\", "
				"\"type\":\"access-control\", "
				"\"description\":\"Door closed.\", "
				"\"event\":\"authentication\", "
				"\"value\":\"true\"}"
				"}");
			addServerMessageToQueue(log_msg);
			ESP_LOGI(TAG, "Door closed.");
		} else {
			snprintf(log_msg, sizeof(log_msg), 
				"{\"event_type\":\"log\",\"payload\":"
				"{\"service_id\":\"ac_1\", "
				"\"type\":\"access-control\", "
				"\"description\":\"Door opened.\", "
				"\"event\":\"authentication\", "
				"\"value\":\"true\"}"
				"}");
			addServerMessageToQueue(log_msg);
			ESP_LOGI(TAG, "Door opened.");
		}
    }
	lck->prevIsContact = lck->isContact;
}

static void lock_contact_timer(void *pvParameter) {
    while (1) {
        for (int i = 0; i < NUM_OF_LOCKS; i++)
            check_lock_contact_timer(&locks[i]);
        vTaskDelay(1000 / portTICK_PERIOD_MS);
    }
}

void createLockServiceMessage(bool value) {
    snprintf(lock_service_message, sizeof(lock_service_message),
             "{\"event_type\":\"service/state\",\"payload\":{\"service_id\":\"locks[0]\",\"state\":{\"locked\":%s}}}",
             value ? "true" : "false");
    lock_service_message_ready = true;
}

void enableLock(int ch, bool val) {
    for (int i = 0; i < NUM_OF_LOCKS; i++)
        if (locks[i].channel == ch) locks[i].enable = val;
}

void arm_lock(int channel, bool arm, bool alert) {
    char source[sizeof(s_last_action_source)];
    lock_action_source_consume(source, sizeof(source));

    int ch = channel - 1;
    if (ch < 0 || ch >= NUM_OF_LOCKS) {
        return;
    }
	if (!locks[ch].enable) {
        return;
    }

    locks[ch].alert = alert;

    bool requested_arm = arm;
    locks[ch].shouldLock = requested_arm;

    // Calibrated against the door: control pin HIGH (out=1) = LOCKED, LOW (out=0)
    // = UNLOCKED. With fail-secure ON, armed must drive out=1 (locked) and disarm
    // out=0 (unlock) — i.e. no inversion for fail-secure; fail-safe inverts.
    bool output_level = requested_arm;
    if (!locks[ch].fail_secure) {
        output_level = !output_level;
    }

    set_io(locks[ch].controlPin, output_level);
    start_lock_contact_timer(&locks[ch], true);

    if (USE_MCP23017) {
        locks[ch].isContact = get_mcp_io(locks[ch].contactPin);
        locks[ch].isSignal = get_mcp_io(locks[ch].signalPin);
    } else {
        locks[ch].isContact = get_io(locks[ch].contactPin);
        locks[ch].isSignal = get_io(locks[ch].signalPin);
    }

    char message[96];
    snprintf(message, sizeof(message),
             "Lock%d[%s] arm=%d out=%d en=%d contact=%d signal=%d alert=%d",
             locks[ch].channel,
             source,
             requested_arm ? 1 : 0,
             output_level ? 1 : 0,
             locks[ch].enable ? 1 : 0,
             locks[ch].isContact ? 1 : 0,
             locks[ch].isSignal ? 1 : 0,
             locks[ch].alert ? 1 : 0);
    automation_record_log(message);

    if (locks[ch].alert && !lock_source_is_auto_rearm(source)) {
        // While typing a PIN, suppress unrelated beeps (e.g. pad auto-rearm/contact alerts)
        // but still allow the feedback beep for the successful PIN submit path.
        bool aux_feedback = lock_source_is_aux_input(source);
        bool suppress = !aux_feedback && wiegand_pin_entry_active(locks[ch].channel) && strcmp(source, "wg_pin") != 0;
        if (!suppress) {
            alert_output_signal(1, 0, locks[ch].alert_target);
        }
    }
}

void storeLockSettings(void)
{
    for (int i = 0; i < NUM_OF_LOCKS; i++)
    {
        char key[16]; // NVS key max is 15 chars + null terminator
        
        // Use shorter key names to fit NVS 15-character limit
        snprintf(key, sizeof(key), "lock_%d_enable", i + 1);
        set_bool(key, locks[i].enable);
        
        snprintf(key, sizeof(key), "lock_%d_arm", i + 1);
        set_bool(key, locks[i].shouldLock);
        
        snprintf(key, sizeof(key), "lock_%d_alert", i + 1);  // Shortened from "contactAlert"
        set_bool(key, locks[i].enableContactAlert);

        snprintf(key, sizeof(key), "lock_%d_atgt", i + 1);
        store_u32(key, (uint32_t)locks[i].alert_target);
        
        snprintf(key, sizeof(key), "lock_%d_pol", i + 1);    // Shortened from "fail_secure"; key kept for on-flash compatibility
        set_bool(key, locks[i].fail_secure);
    }
}

void restoreLockSettings(void)
{
    for (int i = 0; i < NUM_OF_LOCKS; i++)
    {
        char key[16];
        
        snprintf(key, sizeof(key), "lock_%d_enable", i + 1);
        locks[i].enable = get_bool(key, true);
        
        snprintf(key, sizeof(key), "lock_%d_arm", i + 1);
        locks[i].shouldLock = get_bool(key, true);
        
        snprintf(key, sizeof(key), "lock_%d_alert", i + 1);
        locks[i].enableContactAlert = get_bool(key, false);

        snprintf(key, sizeof(key), "lock_%d_atgt", i + 1);
        locks[i].alert_target = alert_target_normalize(
            (int)get_u32(key, locks[i].enableContactAlert ? ALERT_TARGET_BOTH : ALERT_TARGET_NONE),
            locks[i].enableContactAlert);
        locks[i].enableContactAlert = locks[i].alert_target != ALERT_TARGET_NONE;
        
        snprintf(key, sizeof(key), "lock_%d_pol", i + 1);
        locks[i].fail_secure = get_bool(key, true);
    }
}

void sendLockState(void) {
    for (int i = 0; i < NUM_OF_LOCKS; i++) {
        cJSON *root = cJSON_CreateObject();
        cJSON_AddStringToObject(root, "eventType", "lock");
        cJSON *payload = cJSON_CreateObject();
        cJSON_AddNumberToObject(payload, "channel", i + 1);
        cJSON_AddBoolToObject(payload, "enable", locks[i].enable);
        cJSON_AddBoolToObject(payload, "arm", locks[i].shouldLock);
        cJSON_AddBoolToObject(payload, "enableContactAlert", locks[i].enableContactAlert);
        cJSON_AddStringToObject(payload, "alert_target", alert_target_to_string(locks[i].alert_target));
        cJSON_AddBoolToObject(payload, "failSecure", locks[i].fail_secure);
        cJSON_AddItemToObject(root, "payload", payload);
        
        addClientMessageToQueue(root);
        cJSON_Delete(root);
    }
}

cJSON *lock_state_snapshot(void) {
    cJSON *array = cJSON_CreateArray();
    if (!array) {
        return NULL;
    }

    for (int i = 0; i < NUM_OF_LOCKS; i++) {
        /* Refresh sense/contact from hardware so API reflects current I/O state */
        if (USE_MCP23017) {
            locks[i].isContact = get_mcp_io(locks[i].contactPin);
            locks[i].isSignal = get_mcp_io(locks[i].signalPin);
        } else {
            locks[i].isContact = get_io(locks[i].contactPin);
            locks[i].isSignal = get_io(locks[i].signalPin);
        }

        cJSON *entry = cJSON_CreateObject();
        if (!entry) {
            continue;
        }
        cJSON_AddNumberToObject(entry, "channel", i + 1);
        cJSON_AddBoolToObject(entry, "enable", locks[i].enable);
        cJSON_AddBoolToObject(entry, "arm", locks[i].shouldLock);
        cJSON_AddBoolToObject(entry, "enableContactAlert", locks[i].enableContactAlert);
        cJSON_AddStringToObject(entry, "alert_target", alert_target_to_string(locks[i].alert_target));
        cJSON_AddBoolToObject(entry, "failSecure", locks[i].fail_secure);
        /* Invert: pull-up means disconnected=high; we want true=closed/active (green) */
        bool sense_ok = !locks[i].isSignal;
        bool contact_ok = !locks[i].isContact;
        /* Channel 1: display contact as signal and signal as contact (UI swap) */
        if (i == 0) {
            cJSON_AddBoolToObject(entry, "sense", contact_ok);
            cJSON_AddBoolToObject(entry, "contact", sense_ok);
        } else {
            cJSON_AddBoolToObject(entry, "sense", sense_ok);
            cJSON_AddBoolToObject(entry, "contact", contact_ok);
        }
        cJSON_AddItemToArray(array, entry);
    }

    return array;
}

void handle_lock_message(cJSON * payload) {
    int ch=0;
    bool val;

    if (payload == NULL) return;

	cJSON *channel_item = cJSON_GetObjectItem(payload, "channel");
	cJSON *enable_item = cJSON_GetObjectItem(payload, "enable");
	cJSON *enableContactAlert_item = cJSON_GetObjectItem(payload, "enableContactAlert");
	cJSON *alert_target_item = cJSON_GetObjectItem(payload, "alert_target");
	cJSON *fail_secure_item = cJSON_GetObjectItem(payload, "failSecure");
	cJSON *arm_item = cJSON_GetObjectItem(payload, "arm");
	cJSON *getState_item = cJSON_GetObjectItem(payload,"getState");

	if (getState_item && getState_item->type == cJSON_True) {
		sendLockState();
		cJSON_Delete(payload);
		return;
	}

	if (channel_item) {
	 	ch = channel_item->valueint - 1;
        if (ch < 0 || ch >= NUM_OF_LOCKS) {
            ESP_LOGE(TAG, "Invalid channel: %d", ch + 1);
            cJSON_Delete(payload);
            return;
        }
    }

    // Debounce lock arm/disarm actions only. Configuration writes can arrive
    // back-to-back from the API/UI test suite and must not be dropped.
    static int64_t last_arm_change_time[NUM_OF_LOCKS] = {0};
    int64_t current_time = esp_timer_get_time() / 1000; // Convert to milliseconds

	if (enable_item) {
		val = (enable_item->type == cJSON_True);
        // Only update if value actually changed
        if (locks[ch].enable != val) {
            locks[ch].enable = val;
            ESP_LOGI(TAG, "Enable for lock %d changed to %d", ch + 1, val);
            char message[96];
            snprintf(message, sizeof(message), "Lock%d enable changed to %d via API", ch + 1, val ? 1 : 0);
            automation_record_log(message);
        }
    }

	if (enableContactAlert_item) {
        val = (enableContactAlert_item->type == cJSON_True);
        // Only update if value actually changed
        if (locks[ch].enableContactAlert != val) {
            locks[ch].enableContactAlert = val;
            if (!val) {
                locks[ch].alert_target = ALERT_TARGET_NONE;
            } else if (locks[ch].alert_target == ALERT_TARGET_NONE) {
                locks[ch].alert_target = ALERT_TARGET_BOTH;
            }
            ESP_LOGI(TAG, "Contact alert for lock %d changed to %d", ch + 1, val);
            char message[96];
            snprintf(message, sizeof(message), "Lock%d contact alert changed to %d via API", ch + 1, val ? 1 : 0);
            automation_record_log(message);
        }
    }

    if (alert_target_item) {
        int next_target = locks[ch].alert_target;
        if (cJSON_IsString(alert_target_item) && alert_target_item->valuestring) {
            next_target = alert_target_from_string(alert_target_item->valuestring, locks[ch].enableContactAlert);
        } else if (cJSON_IsNumber(alert_target_item)) {
            next_target = alert_target_normalize(alert_target_item->valueint, locks[ch].enableContactAlert);
        }
        next_target = alert_target_normalize(next_target, locks[ch].enableContactAlert);
        if (locks[ch].alert_target != next_target) {
            locks[ch].alert_target = next_target;
            locks[ch].enableContactAlert = next_target != ALERT_TARGET_NONE;
            ESP_LOGI(TAG, "Contact alert target for lock %d changed to %s", ch + 1, alert_target_to_string(next_target));
            char message[128];
            snprintf(message, sizeof(message), "Lock%d contact alert target changed to %s", ch + 1, alert_target_to_string(next_target));
            automation_record_log(message);
        }
    }

	if (fail_secure_item) {
        val = (fail_secure_item->type == cJSON_True);
        // Only update if value actually changed
        if (locks[ch].fail_secure != val) {
            locks[ch].fail_secure = val;
            ESP_LOGI(TAG, "Fail-secure for lock %d changed to %d", ch + 1, val);
            char message[96];
            snprintf(message, sizeof(message), "Lock%d fail-secure changed to %d via API", ch + 1, val ? 1 : 0);
            automation_record_log(message);
        }
    }

	if (arm_item) {
        val = (arm_item->type == cJSON_True);
        // Only update if value actually changed
        if (locks[ch].shouldLock != val) {
            if (current_time - last_arm_change_time[ch] < 100) {
                ESP_LOGW(TAG, "Debouncing arm toggle for lock %d, ignoring rapid change", ch + 1);
            } else {
            locks[ch].shouldLock = val;
            last_arm_change_time[ch] = current_time;
            lock_set_action_source("api");
            if (val) {
                arm_lock(ch + 1, true, true);
                ESP_LOGI(TAG, "Arming lock %d", ch + 1);
                char message[96];
                snprintf(message, sizeof(message), "Lock%d armed via API", ch + 1);
                automation_record_log(message);
            } else {
                arm_lock(ch + 1, false, true);
                ESP_LOGI(TAG, "Disarming lock %d", ch + 1);
                char message[96];
                snprintf(message, sizeof(message), "Lock%d disarmed via API", ch + 1);
                automation_record_log(message);
            }
            }
        }
    }

    // Save settings to flash storage only if any changes were made
    if (enable_item || enableContactAlert_item || alert_target_item || fail_secure_item || arm_item) {
        storeLockSettings();
        // Send updated state back to client to confirm the change
        sendLockState();
    }
    
    cJSON_Delete(payload);
}

void lock_init()
{
    locks[0].channel = 1;
    locks[0].controlPin = USE_MCP23017 ? LOCK_MCP_IO_1 : LOCK_IO_1;
    locks[0].isLocked = true;
	locks[0].shouldLock = true;
	locks[0].isSignal = true;
	locks[0].contactPin = USE_MCP23017 ? LOCK_CONTACT_PIN_1 : CONTACT_IO_1;
	locks[0].signalPin = USE_MCP23017 ? LOCK_SIGNAL_PIN_1 : SIGNAL_IO_1;
	locks[0].enable = true;
	locks[0].delay = 1;
	locks[0].alert = true;
	locks[0].enableContactAlert = false;
	locks[0].alert_target = ALERT_TARGET_NONE;
	locks[0].fail_secure = 0;
	strcpy(locks[0].type, "lock");

    locks[1].channel = 2;
    locks[1].controlPin = USE_MCP23017 ? LOCK_MCP_IO_2 : LOCK_IO_2;
    locks[1].isLocked = true;
	locks[1].shouldLock = true;
	locks[1].isSignal = true;
	locks[1].contactPin = USE_MCP23017 ? LOCK_CONTACT_PIN_2 : CONTACT_IO_2;
	locks[1].signalPin = USE_MCP23017 ? LOCK_SIGNAL_PIN_2 : SIGNAL_IO_2;
	locks[1].enable = true;
	locks[1].delay = 1;
	locks[1].alert = true;
	locks[1].enableContactAlert = false;
	locks[1].alert_target = ALERT_TARGET_NONE;
	locks[1].fail_secure = 0;
	strcpy(locks[1].type, "lock");

	for (int i=0; i < NUM_OF_LOCKS; i++) {
		locks[i].expired = true;
		locks[i].count = 0;
		locks[i].sentSignalAlert = false;
		locks[i].sentContactAlert = false;
		if (USE_MCP23017) {
			set_mcp_io_dir(locks[i].controlPin, MCP_OUTPUT);
			set_mcp_io_dir(locks[i].contactPin, MCP_INPUT);
			set_mcp_io_dir(locks[i].signalPin, MCP_INPUT);
		}
	}
}

static void lock_service(void *pvParameter) {
    while (1) {
        handle_lock_message(checkServiceMessageByType("lock"));
        vTaskDelay(SERVICE_LOOP / portTICK_PERIOD_MS);
    }
}

/*
 * Drive a lock's control output to match its (restored) armed state. Used at boot
 * so the lock powers up in the correct state instead of floating at the MCP23017
 * output default (LOW), which leaves a fail-safe lock unlocked until the first
 * exit/arm event.
 */
static void lock_apply_output_state(Lock *lck) {
    // Same polarity as arm_lock(): fail-secure armed -> HIGH/out=1/locked.
    bool output_level = lck->shouldLock;
    if (!lck->fail_secure) {
        output_level = !output_level;
    }
    set_io(lck->controlPin, output_level);
}

void lock_main() {
    ESP_LOGI(TAG, "Starting lock service.");

    lock_init();
    restoreLockSettings();

    // Always boot armed/secure. An access controller must come up LOCKED after a
    // power loss or restart, never open — regardless of the last runtime arm state.
    for (int i = 0; i < NUM_OF_LOCKS; i++) {
        locks[i].shouldLock = true;
        lock_apply_output_state(&locks[i]);
        char message[96];
        snprintf(message, sizeof(message),
                 "Lock%d boot output arm=%d fail_secure=%d enable=%d",
                 locks[i].channel,
                 locks[i].shouldLock ? 1 : 0,
                 locks[i].fail_secure ? 1 : 0,
                 locks[i].enable ? 1 : 0);
        automation_record_log(message);
    }

    xTaskCreate(&lock_service, "lock_service_task", 6 * 1024, NULL, 5, NULL);
    xTaskCreate(lock_contact_timer, "lock_contact_timer", 4 * 1000, NULL, 10, NULL);
}
