Wanzi-z/access-controller/code/controller/main/services/tunnel.c

#include <string.h>
#include <stdio.h>
#include <stdlib.h>
#include <stdbool.h>
#include <ctype.h>
#include <errno.h>
#include <fcntl.h>

#include "freertos/FreeRTOS.h"
#include "freertos/semphr.h"
#include "freertos/task.h"

#include "lwip/sockets.h"
#include "lwip/netdb.h"
#include "lwip/inet.h"

#include "esp_log.h"
#include "esp_http_client.h"
#include "esp_ota_ops.h"
#include "esp_app_format.h"
#include "esp_system.h"
#include "cJSON.h"
#include "automation.h"

extern char *get_char(const char *key);
extern void automation_record_log(const char *message);
extern cJSON *lock_state_snapshot(void);
extern cJSON *exit_state_snapshot(void);
extern cJSON *fob_state_snapshot(void);

static const char *TUNNEL_TAG = "tunnel";

#define TUNNEL_DEFAULT_HOST "142.93.57.114"
#define TUNNEL_DEFAULT_PORT 9111
#define TUNNEL_LEGACY_LAN_HOST "192.168.1.43"
#define TUNNEL_LEGACY_LAN_PORT 9001
#define PUBLIC_SERVER_HOST "open-automation.org"
#define PUBLIC_SERVER_PORT 443
#define TUNNEL_RECONNECT_DELAY_MS 3000
#define TUNNEL_CONNECT_TIMEOUT_MS 8000
#define TUNNEL_MAX_HEADER_BYTES (64 * 1024)
#define TUNNEL_MAX_BODY_BYTES   (128 * 1024)
#define LOCAL_HTTP_TIMEOUT_MS   8000
#define LOCAL_HTTP_OTA_TIMEOUT_MS (240 * 1000)
#define TUNNEL_TASK_STACK_BYTES  (8 * 1024)
#define TUNNEL_OTA_REBOOT_DELAY_MS 1500

#ifndef CONFIG_ACCESS_CONTROLLER_ENABLE_TUNNEL
#define CONFIG_ACCESS_CONTROLLER_ENABLE_TUNNEL 0
#endif

typedef struct {
    char host[64];
    int port;
} tunnel_config_t;

typedef struct {
    int sock;
    bool identified;
    char assigned_id[100];
    tunnel_config_t config;
} tunnel_client_t;

typedef struct {
    char key[64];
    char value[128];
} header_pair_t;

#define MAX_STREAM_HEADERS 20

typedef struct {
    tunnel_client_t *client;
    char request_id[64];
    header_pair_t headers[MAX_STREAM_HEADERS];
    int header_count;
    bool start_sent;
    bool finished;
    bool error;
    esp_err_t last_err;
} http_stream_context_t;

static void add_header_to_json(cJSON *headers_obj, const char *key, const char *value);
static void handle_abort_frame(tunnel_client_t *client, cJSON *header);
static esp_err_t read_frame(int sock, cJSON **header_out, uint8_t **body_out, size_t *body_len_out);

static const char *normalize_target(const char *target, char *buffer, size_t buffer_len) {
    if (!target) {
        return "/";
    }

    if (strncmp(target, "/device/", 8) == 0) {
        const char *after_id = strchr(target + 8, '/');
        if (after_id) {
            strlcpy(buffer, after_id, buffer_len);
            return buffer;
        }
        strlcpy(buffer, "/", buffer_len);
        return buffer;
    }

    return target;
}

static bool is_ota_upload_target(const char *target) {
    if (!target) {
        return false;
    }
    char normalized_path[256];
    const char *path = normalize_target(target, normalized_path, sizeof(normalized_path));
    const char *query = strchr(path, '?');
    size_t path_len = query ? (size_t)(query - path) : strlen(path);
    return path_len == strlen("/api/ota/upload") && strncmp(path, "/api/ota/upload", path_len) == 0;
}

static bool is_tunnel_forward_allowed(const char *target) {
    if (!target) {
        return false;
    }

    char normalized_path[256];
    const char *path = normalize_target(target, normalized_path, sizeof(normalized_path));
    const char *query = strchr(path, '?');
    size_t path_len = query ? (size_t)(query - path) : strlen(path);

    if (path_len == strlen("/api") && strncmp(path, "/api", path_len) == 0) {
        return true;
    }
    if (path_len > strlen("/api/") && strncmp(path, "/api/", strlen("/api/")) == 0) {
        return true;
    }
    if (path_len == strlen("/ws") && strncmp(path, "/ws", path_len) == 0) {
        return true;
    }
    return false;
}

static bool tunnel_task_started = false;
static SemaphoreHandle_t s_tunnel_ota_mutex = NULL;

void tunnel_ws_broadcast(const char *message) {
    (void)message;
}

static void load_tunnel_config(tunnel_config_t *cfg) {
    if (!cfg) {
        return;
    }

    char *stored_host = get_char("tunnel_host");
    char *stored_port = get_char("tunnel_port");

    const char *host_pick = (stored_host && stored_host[0]) ? stored_host : TUNNEL_DEFAULT_HOST;
    const char *port_pick_str = (stored_port && stored_port[0]) ? stored_port : NULL;

    snprintf(cfg->host, sizeof(cfg->host), "%s", host_pick);
    if (port_pick_str) {
        cfg->port = atoi(port_pick_str);
    } else {
        cfg->port = TUNNEL_DEFAULT_PORT;
    }

    if (cfg->port <= 0) {
        cfg->port = TUNNEL_DEFAULT_PORT;
    }

    if ((strcmp(cfg->host, PUBLIC_SERVER_HOST) == 0 && cfg->port == PUBLIC_SERVER_PORT) ||
        (strcmp(cfg->host, TUNNEL_LEGACY_LAN_HOST) == 0 && cfg->port == TUNNEL_LEGACY_LAN_PORT)) {
        ESP_LOGW(TUNNEL_TAG,
                 "Ignoring stale tunnel endpoint %s:%d from server URL settings; using default %s:%d",
                 cfg->host,
                 cfg->port,
                 TUNNEL_DEFAULT_HOST,
                 TUNNEL_DEFAULT_PORT);
        snprintf(cfg->host, sizeof(cfg->host), "%s", TUNNEL_DEFAULT_HOST);
        cfg->port = TUNNEL_DEFAULT_PORT;
    }

    if (stored_host) free(stored_host);
    if (stored_port) free(stored_port);
}

static esp_http_client_method_t http_method_from_string(const char *method) {
    if (!method) {
        return HTTP_METHOD_GET;
    }

    if (strcasecmp(method, "GET") == 0) return HTTP_METHOD_GET;
    if (strcasecmp(method, "POST") == 0) return HTTP_METHOD_POST;
    if (strcasecmp(method, "PUT") == 0) return HTTP_METHOD_PUT;
    if (strcasecmp(method, "DELETE") == 0) return HTTP_METHOD_DELETE;
    if (strcasecmp(method, "PATCH") == 0) return HTTP_METHOD_PATCH;
    if (strcasecmp(method, "HEAD") == 0) return HTTP_METHOD_HEAD;
    if (strcasecmp(method, "OPTIONS") == 0) return HTTP_METHOD_OPTIONS;
    return HTTP_METHOD_GET;
}

static esp_err_t send_all(int sock, const uint8_t *data, size_t len) {
    size_t total_sent = 0;
    while (total_sent < len) {
        int sent = send(sock, data + total_sent, len - total_sent, 0);
        if (sent < 0) {
            if (errno == EINTR) {
                continue;
            }
            ESP_LOGE(TUNNEL_TAG, "send failed: errno=%d", errno);
            return ESP_FAIL;
        }
        if (sent == 0) {
            ESP_LOGW(TUNNEL_TAG, "send returned 0 bytes");
            return ESP_FAIL;
        }
        total_sent += (size_t)sent;
    }
    return ESP_OK;
}

static esp_err_t read_exact(int sock, uint8_t *buf, size_t len) {
    size_t total_read = 0;
    while (total_read < len) {
        int received = recv(sock, buf + total_read, len - total_read, 0);
        if (received < 0) {
            if (errno == EINTR) {
                continue;
            }
            if (errno == EAGAIN || errno == EWOULDBLOCK) {
                vTaskDelay(pdMS_TO_TICKS(50));
                continue;
            }
            ESP_LOGE(TUNNEL_TAG, "recv failed: errno=%d", errno);
            return ESP_FAIL;
        }
        if (received == 0) {
            ESP_LOGW(TUNNEL_TAG, "Connection closed by peer");
            return ESP_FAIL;
        }
        total_read += (size_t)received;
    }
    return ESP_OK;
}

static esp_err_t send_frame(int sock, cJSON *header, const uint8_t *body, size_t body_len) {
    if (!header) {
        return ESP_ERR_INVALID_ARG;
    }

    cJSON_DeleteItemFromObjectCaseSensitive(header, "bodyLength");
    cJSON_AddNumberToObject(header, "bodyLength", (double)body_len);

    char *header_str = cJSON_PrintUnformatted(header);
    if (!header_str) {
        ESP_LOGE(TUNNEL_TAG, "Failed to serialize frame header");
        return ESP_FAIL;
    }

    size_t header_len = strlen(header_str);
    if (header_len > TUNNEL_MAX_HEADER_BYTES) {
        ESP_LOGE(TUNNEL_TAG, "Frame header too large (%u bytes)", (unsigned int)header_len);
        cJSON_free(header_str);
        return ESP_ERR_NO_MEM;
    }

    uint32_t header_len_be = htonl((uint32_t)header_len);
    esp_err_t err = send_all(sock, (uint8_t *)&header_len_be, sizeof(header_len_be));
    if (err != ESP_OK) {
        ESP_LOGE(TUNNEL_TAG, "Failed to send frame header length");
        cJSON_free(header_str);
        return err;
    }

    err = send_all(sock, (uint8_t *)header_str, header_len);
    if (err != ESP_OK) {
        ESP_LOGE(TUNNEL_TAG, "Failed to send frame header body");
        cJSON_free(header_str);
        return err;
    }

    cJSON_free(header_str);

    if (body_len > 0 && body) {
        err = send_all(sock, body, body_len);
        if (err != ESP_OK) {
            ESP_LOGE(TUNNEL_TAG, "Failed to send frame payload");
            return err;
        }
    }

    return ESP_OK;
}

static esp_err_t send_simple_frame(int sock, const char *type) {
    cJSON *root = cJSON_CreateObject();
    if (!root) {
        return ESP_ERR_NO_MEM;
    }
    cJSON_AddStringToObject(root, "type", type);
    esp_err_t err = send_frame(sock, root, NULL, 0);
    cJSON_Delete(root);
    return err;
}

static esp_err_t send_http_error(int sock, const char *request_id, const char *message) {
    cJSON *root = cJSON_CreateObject();
    if (!root) {
        return ESP_ERR_NO_MEM;
    }
    cJSON_AddStringToObject(root, "type", "httpError");
    if (request_id) {
        cJSON_AddStringToObject(root, "requestId", request_id);
    }
    if (message) {
        cJSON_AddStringToObject(root, "message", message);
    }
    esp_err_t err = send_frame(sock, root, NULL, 0);
    cJSON_Delete(root);
    return err;
}

static esp_err_t send_json_http_response(int sock, const char *request_id, int status_code, cJSON *payload) {
    if (!request_id || !payload) {
        return ESP_ERR_INVALID_ARG;
    }

    char *body = cJSON_PrintUnformatted(payload);
    if (!body) {
        return ESP_ERR_NO_MEM;
    }

    cJSON *root = cJSON_CreateObject();
    cJSON *headers = cJSON_CreateObject();
    cJSON *content_type = cJSON_CreateArray();
    cJSON *content_length = cJSON_CreateArray();
    if (!root || !headers || !content_type || !content_length) {
        if (root) cJSON_Delete(root);
        if (headers) cJSON_Delete(headers);
        if (content_type) cJSON_Delete(content_type);
        if (content_length) cJSON_Delete(content_length);
        cJSON_free(body);
        return ESP_ERR_NO_MEM;
    }

    char length_str[24];
    snprintf(length_str, sizeof(length_str), "%u", (unsigned int)strlen(body));
    cJSON_AddItemToArray(content_type, cJSON_CreateString("application/json; charset=utf-8"));
    cJSON_AddItemToArray(content_length, cJSON_CreateString(length_str));
    cJSON_AddItemToObject(headers, "content-type", content_type);
    cJSON_AddItemToObject(headers, "content-length", content_length);

    cJSON_AddStringToObject(root, "type", "httpResponse");
    cJSON_AddStringToObject(root, "requestId", request_id);
    cJSON_AddNumberToObject(root, "statusCode", status_code);
    cJSON_AddItemToObject(root, "headers", headers);

    esp_err_t err = send_frame(sock, root, (const uint8_t *)body, strlen(body));
    cJSON_Delete(root);
    cJSON_free(body);
    return err;
}

static esp_err_t send_tunnel_rejected_http_response(int sock, const char *request_id, const char *target) {
    cJSON *payload = cJSON_CreateObject();
    if (!payload) {
        return send_http_error(sock, request_id, "Endpoint is not exposed through the device tunnel");
    }
    cJSON_AddBoolToObject(payload, "ok", false);
    cJSON_AddStringToObject(payload, "message", "Endpoint is not exposed through the device tunnel");
    if (target) {
        cJSON_AddStringToObject(payload, "target", target);
    }
    esp_err_t err = send_json_http_response(sock, request_id, 404, payload);
    cJSON_Delete(payload);
    return err;
}

static void tunnel_ota_reboot_task(void *arg) {
    (void)arg;
    vTaskDelay(pdMS_TO_TICKS(TUNNEL_OTA_REBOOT_DELAY_MS));
    esp_restart();
}

static esp_err_t send_http_response_start(http_stream_context_t *ctx, esp_http_client_handle_t http_client) {
    if (!ctx || ctx->start_sent) {
        return ESP_OK;
    }

    cJSON *response_header = cJSON_CreateObject();
    if (!response_header) {
        return ESP_ERR_NO_MEM;
    }

    cJSON_AddStringToObject(response_header, "type", "httpResponseStart");
    cJSON_AddStringToObject(response_header, "requestId", ctx->request_id);

    int status_code = esp_http_client_get_status_code(http_client);
    cJSON_AddNumberToObject(response_header, "statusCode", status_code);

    cJSON *headers_obj = cJSON_CreateObject();
    if (!headers_obj) {
        cJSON_Delete(response_header);
        return ESP_ERR_NO_MEM;
    }

    for (int i = 0; i < ctx->header_count; ++i) {
        add_header_to_json(headers_obj, ctx->headers[i].key, ctx->headers[i].value);
    }

    int64_t content_length = esp_http_client_get_content_length(http_client);
    if (content_length >= 0 && !cJSON_HasObjectItem(headers_obj, "content-length")) {
        char content_length_str[24];
        snprintf(content_length_str, sizeof(content_length_str), "%lld", (long long)content_length);
        add_header_to_json(headers_obj, "content-length", content_length_str);
    }

    if (!cJSON_HasObjectItem(headers_obj, "connection")) {
        add_header_to_json(headers_obj, "connection", "close");
    }

    if (!cJSON_HasObjectItem(headers_obj, "content-type")) {
        char *content_type = NULL;
        if (esp_http_client_get_header(http_client, "Content-Type", &content_type) == ESP_OK && content_type) {
            add_header_to_json(headers_obj, "content-type", content_type);
        }
    }

    cJSON_AddItemToObject(response_header, "headers", headers_obj);

    esp_err_t err = send_frame(ctx->client->sock, response_header, NULL, 0);
    cJSON_Delete(response_header);
    if (err == ESP_OK) {
        ctx->start_sent = true;
    }
    return err;
}

static esp_err_t send_http_response_chunk(http_stream_context_t *ctx, const uint8_t *data, size_t len) {
    if (!ctx || !data || len == 0) {
        return ESP_OK;
    }

    cJSON *chunk_header = cJSON_CreateObject();
    if (!chunk_header) {
        return ESP_ERR_NO_MEM;
    }

    cJSON_AddStringToObject(chunk_header, "type", "httpResponseChunk");
    cJSON_AddStringToObject(chunk_header, "requestId", ctx->request_id);

    esp_err_t err = send_frame(ctx->client->sock, chunk_header, data, len);
    cJSON_Delete(chunk_header);
    return err;
}

static esp_err_t send_http_response_end(http_stream_context_t *ctx) {
    if (!ctx || ctx->finished) {
        return ESP_OK;
    }

    cJSON *end_header = cJSON_CreateObject();
    if (!end_header) {
        return ESP_ERR_NO_MEM;
    }

    cJSON_AddStringToObject(end_header, "type", "httpResponseEnd");
    cJSON_AddStringToObject(end_header, "requestId", ctx->request_id);

    esp_err_t err = send_frame(ctx->client->sock, end_header, NULL, 0);
    cJSON_Delete(end_header);
    if (err == ESP_OK) {
        ctx->finished = true;
    }
    return err;
}

static esp_err_t http_stream_event_handler(esp_http_client_event_t *evt) {
    http_stream_context_t *ctx = (http_stream_context_t *)evt->user_data;
    if (!ctx) {
        return ESP_OK;
    }

    switch (evt->event_id) {
    case HTTP_EVENT_ON_HEADER:
        if (evt->header_key && evt->header_value && ctx->header_count < MAX_STREAM_HEADERS) {
            snprintf(ctx->headers[ctx->header_count].key,
                     sizeof(ctx->headers[ctx->header_count].key),
                     "%s", evt->header_key);
            snprintf(ctx->headers[ctx->header_count].value,
                     sizeof(ctx->headers[ctx->header_count].value),
                     "%s", evt->header_value);
            ctx->header_count++;
        }
        break;
    case HTTP_EVENT_ON_DATA: {
        if (!ctx->start_sent) {
            esp_err_t err = send_http_response_start(ctx, evt->client);
            if (err != ESP_OK) {
                ctx->error = true;
                ctx->last_err = err;
                break;
            }
        }
        if (evt->data && evt->data_len > 0) {
            esp_err_t err = send_http_response_chunk(ctx, (const uint8_t *)evt->data, evt->data_len);
            if (err != ESP_OK) {
                ctx->error = true;
                ctx->last_err = err;
            }
        }
        break;
    }
    case HTTP_EVENT_ON_FINISH:
        if (!ctx->start_sent) {
            esp_err_t err = send_http_response_start(ctx, evt->client);
            if (err != ESP_OK) {
                ctx->error = true;
                ctx->last_err = err;
            }
        }
        if (!ctx->finished) {
            esp_err_t err = send_http_response_end(ctx);
            if (err != ESP_OK) {
                ctx->error = true;
                ctx->last_err = err;
            }
        }
        break;
    case HTTP_EVENT_DISCONNECTED:
        if (ctx->start_sent && !ctx->finished) {
            esp_err_t err = send_http_response_end(ctx);
            if (err != ESP_OK) {
                ctx->last_err = err;
            }
        }
        ctx->finished = true;
        break;
    case HTTP_EVENT_ERROR:
        ctx->error = true;
        break;
    default:
        break;
    }

    return ESP_OK;
}

static void add_header_to_json(cJSON *headers_obj, const char *key, const char *value) {
    if (!headers_obj || !key || !value) {
        return;
    }

    char lower_key[64];
    size_t i;
    for (i = 0; i < sizeof(lower_key) - 1 && key[i]; ++i) {
        lower_key[i] = (char)tolower((unsigned char)key[i]);
    }
    lower_key[i] = '\0';

    cJSON *array = cJSON_GetObjectItemCaseSensitive(headers_obj, lower_key);
    if (!array) {
        array = cJSON_CreateArray();
        if (!array) {
            return;
        }
        cJSON_AddItemToObject(headers_obj, lower_key, array);
    }

    cJSON_AddItemToArray(array, cJSON_CreateString(value));
}

static void handle_abort_frame(tunnel_client_t *client, cJSON *header) {
    (void)client;
    if (!header) {
        return;
    }
    cJSON *request_id_item = cJSON_GetObjectItemCaseSensitive(header, "requestId");
    const char *request_id = cJSON_IsString(request_id_item) ? request_id_item->valuestring : NULL;
    if (request_id && request_id[0] != '\0') {
        ESP_LOGI(TUNNEL_TAG, "Request %s aborted by tunnel server", request_id);
    } else {
        ESP_LOGI(TUNNEL_TAG, "Tunnel server aborted request");
    }
}

static esp_err_t forward_request_to_local_http(tunnel_client_t *client, const char *request_id, const char *method,
                                               const char *target, cJSON *headers, const uint8_t *body, size_t body_len) {
    if (!client || !request_id || !method || !target) {
        return ESP_ERR_INVALID_ARG;
    }

    if (body_len > TUNNEL_MAX_BODY_BYTES) {
        ESP_LOGW(TUNNEL_TAG, "Request body too large (%u bytes)", (unsigned int)body_len);
        return send_http_error(client->sock, request_id, "Request body too large");
    }

    if (!is_tunnel_forward_allowed(target)) {
        ESP_LOGW(TUNNEL_TAG, "Rejecting non-API tunnel request: %s %s", method, target);
        return send_tunnel_rejected_http_response(client->sock, request_id, target);
    }

    char normalized_path[256];
    const char *local_path = normalize_target(target, normalized_path, sizeof(normalized_path));

    char url[256];
    snprintf(url, sizeof(url), "http://127.0.0.1%s", (*local_path) ? local_path : "/");

    esp_http_client_config_t http_cfg = {
        .url = url,
        .method = http_method_from_string(method),
        .timeout_ms = is_ota_upload_target(target) ? LOCAL_HTTP_OTA_TIMEOUT_MS : LOCAL_HTTP_TIMEOUT_MS,
        .event_handler = http_stream_event_handler,
        .buffer_size = 1024,
        .buffer_size_tx = 1024,
    };

    http_stream_context_t stream_ctx = {
        .client = client,
        .header_count = 0,
        .start_sent = false,
        .finished = false,
        .error = false,
        .last_err = ESP_OK,
    };
    snprintf(stream_ctx.request_id, sizeof(stream_ctx.request_id), "%s", request_id);
    http_cfg.user_data = &stream_ctx;

    esp_http_client_handle_t http_client = esp_http_client_init(&http_cfg);
    if (!http_client) {
        return send_http_error(client->sock, request_id, "Failed to init local HTTP client");
    }

    if (headers && cJSON_IsObject(headers)) {
        cJSON *header = NULL;
        cJSON_ArrayForEach(header, headers) {
            const char *key = header->string;
            if (!key || !cJSON_IsArray(header)) {
                continue;
            }
            cJSON *value_item = cJSON_GetArrayItem(header, 0);
            if (!value_item || !cJSON_IsString(value_item)) {
                continue;
            }
            if (strcasecmp(key, "content-length") == 0) {
                continue;
            }
            if (strcasecmp(key, "connection") == 0) {
                continue;
            }
            esp_http_client_set_header(http_client, key, value_item->valuestring);
        }
    }

    esp_http_client_set_header(http_client, "Connection", "close");
    if (body && body_len > 0) {
        esp_http_client_set_post_field(http_client, (const char *)body, (int)body_len);
    }

    esp_err_t err = esp_http_client_perform(http_client);
    if (err != ESP_OK) {
        ESP_LOGE(TUNNEL_TAG, "Local HTTP request failed: %s", esp_err_to_name(err));
    }

    if (!stream_ctx.start_sent && !stream_ctx.error) {
        esp_err_t start_err = send_http_response_start(&stream_ctx, http_client);
        if (start_err != ESP_OK) {
            stream_ctx.error = true;
            stream_ctx.last_err = start_err;
        }
    }

    if (stream_ctx.start_sent && !stream_ctx.finished) {
        esp_err_t end_err = send_http_response_end(&stream_ctx);
        if (end_err != ESP_OK) {
            stream_ctx.error = true;
            stream_ctx.last_err = end_err;
        }
    }

    esp_http_client_cleanup(http_client);

    if (err != ESP_OK || stream_ctx.error) {
        if (!stream_ctx.start_sent) {
            return send_http_error(client->sock, request_id, "Local HTTP request failed");
        }
        if (!stream_ctx.finished) {
            send_http_response_end(&stream_ctx);
        }
        return ESP_FAIL;
    }

    return ESP_OK;
}

static bool request_id_matches(cJSON *header, const char *request_id) {
    cJSON *request_id_item = cJSON_GetObjectItemCaseSensitive(header, "requestId");
    return cJSON_IsString(request_id_item) &&
           request_id_item->valuestring &&
           strcmp(request_id_item->valuestring, request_id) == 0;
}

static esp_err_t http_client_write_all(esp_http_client_handle_t http_client, const uint8_t *body, size_t body_len) {
    size_t written = 0;
    while (written < body_len) {
        int sent = esp_http_client_write(http_client, (const char *)body + written, (int)(body_len - written));
        if (sent < 0) {
            ESP_LOGE(TUNNEL_TAG, "Local HTTP request body write failed");
            return ESP_FAIL;
        }
        if (sent == 0) {
            vTaskDelay(pdMS_TO_TICKS(10));
            continue;
        }
        written += (size_t)sent;
    }
    return ESP_OK;
}

static esp_err_t finish_streamed_local_response(http_stream_context_t *stream_ctx, esp_http_client_handle_t http_client) {
    int64_t header_result = esp_http_client_fetch_headers(http_client);
    if (header_result < 0) {
        ESP_LOGW(TUNNEL_TAG, "Local HTTP response header fetch returned %lld", (long long)header_result);
    }

    esp_err_t err = send_http_response_start(stream_ctx, http_client);
    if (err != ESP_OK) {
        return err;
    }

    uint8_t buffer[1024];
    while (1) {
        int received = esp_http_client_read(http_client, (char *)buffer, sizeof(buffer));
        if (received > 0) {
            err = send_http_response_chunk(stream_ctx, buffer, (size_t)received);
            if (err != ESP_OK) {
                return err;
            }
            continue;
        }
        if (received == 0) {
            if (esp_http_client_is_complete_data_received(http_client)) {
                break;
            }
            vTaskDelay(pdMS_TO_TICKS(10));
            continue;
        }
        ESP_LOGE(TUNNEL_TAG, "Local HTTP response read failed (%d)", received);
        return ESP_FAIL;
    }

    return send_http_response_end(stream_ctx);
}

static esp_err_t read_expected_stream_frame(tunnel_client_t *client,
                                            const char *request_id,
                                            const char *expected_type,
                                            cJSON **header_out,
                                            uint8_t **body_out,
                                            size_t *body_len_out) {
    cJSON *header = NULL;
    uint8_t *body = NULL;
    size_t body_len = 0;
    esp_err_t err = read_frame(client->sock, &header, &body, &body_len);
    if (err != ESP_OK) {
        if (body) free(body);
        if (header) cJSON_Delete(header);
        return err;
    }

    cJSON *type_item = cJSON_GetObjectItemCaseSensitive(header, "type");
    const char *type = cJSON_IsString(type_item) ? type_item->valuestring : NULL;
    if (!type || strcmp(type, expected_type) != 0 || !request_id_matches(header, request_id)) {
        ESP_LOGE(TUNNEL_TAG, "Unexpected streamed request frame (expected %s)", expected_type);
        if (body) free(body);
        cJSON_Delete(header);
        return ESP_ERR_INVALID_RESPONSE;
    }

    *header_out = header;
    *body_out = body;
    *body_len_out = body_len;
    return ESP_OK;
}

static esp_err_t handle_streamed_ota_upload(tunnel_client_t *client, const char *request_id, size_t request_body_len) {
    if (!client || !request_id || request_body_len == 0) {
        return ESP_ERR_INVALID_ARG;
    }

    const esp_partition_t *update_partition = esp_ota_get_next_update_partition(NULL);
    if (!update_partition) {
        return send_http_error(client->sock, request_id, "No OTA update partition available");
    }
    if (request_body_len > update_partition->size) {
        return send_http_error(client->sock, request_id, "Firmware binary exceeds OTA partition size");
    }

    if (!s_tunnel_ota_mutex) {
        s_tunnel_ota_mutex = xSemaphoreCreateMutex();
    }
    if (!s_tunnel_ota_mutex || xSemaphoreTake(s_tunnel_ota_mutex, 0) != pdTRUE) {
        return send_http_error(client->sock, request_id, "OTA update already in progress");
    }

    ESP_LOGI(TUNNEL_TAG,
             "Starting streamed tunnel OTA to partition %s (%u bytes)",
             update_partition->label,
             (unsigned int)request_body_len);

    esp_ota_handle_t update_handle = 0;
    esp_err_t err = esp_ota_begin(update_partition, request_body_len, &update_handle);
    if (err != ESP_OK) {
        xSemaphoreGive(s_tunnel_ota_mutex);
        ESP_LOGE(TUNNEL_TAG, "esp_ota_begin failed (%s)", esp_err_to_name(err));
        return send_http_error(client->sock, request_id, "Failed to start OTA update");
    }

    size_t remaining = request_body_len;
    size_t written = 0;
    while (remaining > 0) {
        cJSON *chunk_header = NULL;
        uint8_t *chunk_body = NULL;
        size_t chunk_len = 0;
        err = read_expected_stream_frame(client, request_id, "httpRequestChunk", &chunk_header, &chunk_body, &chunk_len);
        if (err != ESP_OK) {
            ESP_LOGE(TUNNEL_TAG, "Failed to read OTA chunk (%s)", esp_err_to_name(err));
            esp_ota_abort(update_handle);
            xSemaphoreGive(s_tunnel_ota_mutex);
            return err;
        }
        if (chunk_len == 0 || chunk_len > remaining) {
            ESP_LOGE(TUNNEL_TAG, "Invalid OTA chunk length %u remaining %u",
                     (unsigned int)chunk_len,
                     (unsigned int)remaining);
            if (chunk_body) free(chunk_body);
            cJSON_Delete(chunk_header);
            esp_ota_abort(update_handle);
            xSemaphoreGive(s_tunnel_ota_mutex);
            return send_http_error(client->sock, request_id, "Streamed OTA body length mismatch");
        }

        err = esp_ota_write(update_handle, chunk_body, chunk_len);
        if (chunk_body) free(chunk_body);
        cJSON_Delete(chunk_header);
        if (err != ESP_OK) {
            ESP_LOGE(TUNNEL_TAG, "esp_ota_write failed after %u bytes (%s)",
                     (unsigned int)written,
                     esp_err_to_name(err));
            esp_ota_abort(update_handle);
            xSemaphoreGive(s_tunnel_ota_mutex);
            return send_http_error(client->sock, request_id, "Firmware binary is not a valid ESP32 app image");
        }

        written += chunk_len;
        remaining -= chunk_len;
    }

    cJSON *end_header = NULL;
    uint8_t *end_body = NULL;
    size_t end_body_len = 0;
    err = read_expected_stream_frame(client, request_id, "httpRequestEnd", &end_header, &end_body, &end_body_len);
    if (end_body) free(end_body);
    if (end_header) cJSON_Delete(end_header);
    if (err != ESP_OK || end_body_len != 0) {
        ESP_LOGE(TUNNEL_TAG, "Invalid streamed OTA end frame");
        esp_ota_abort(update_handle);
        xSemaphoreGive(s_tunnel_ota_mutex);
        return send_http_error(client->sock, request_id, "Invalid streamed OTA end frame");
    }

    err = esp_ota_end(update_handle);
    if (err != ESP_OK) {
        ESP_LOGE(TUNNEL_TAG, "esp_ota_end failed (%s)", esp_err_to_name(err));
        xSemaphoreGive(s_tunnel_ota_mutex);
        return send_http_error(client->sock, request_id, "Firmware image validation failed");
    }

    esp_app_desc_t uploaded_desc;
    memset(&uploaded_desc, 0, sizeof(uploaded_desc));
    esp_err_t desc_err = esp_ota_get_partition_description(update_partition, &uploaded_desc);

    err = esp_ota_set_boot_partition(update_partition);
    if (err != ESP_OK) {
        ESP_LOGE(TUNNEL_TAG, "esp_ota_set_boot_partition failed (%s)", esp_err_to_name(err));
        xSemaphoreGive(s_tunnel_ota_mutex);
        return send_http_error(client->sock, request_id, "Failed to select uploaded firmware");
    }

    automation_record_log("OTA firmware uploaded through tunnel; rebooting into new image");

    cJSON *response = cJSON_CreateObject();
    if (!response) {
        xSemaphoreGive(s_tunnel_ota_mutex);
        return send_http_error(client->sock, request_id, "Firmware installed but response allocation failed");
    }
    cJSON_AddBoolToObject(response, "ok", true);
    cJSON_AddBoolToObject(response, "reboot", true);
    cJSON_AddNumberToObject(response, "bytes", written);
    cJSON_AddNumberToObject(response, "rebootDelayMs", TUNNEL_OTA_REBOOT_DELAY_MS);
    cJSON_AddStringToObject(response, "partition", update_partition->label);
    if (desc_err == ESP_OK) {
        cJSON_AddStringToObject(response, "projectName", uploaded_desc.project_name);
        cJSON_AddStringToObject(response, "projectVersion", uploaded_desc.version);
        cJSON_AddStringToObject(response, "buildDate", uploaded_desc.date);
        cJSON_AddStringToObject(response, "buildTime", uploaded_desc.time);
    }

    err = send_json_http_response(client->sock, request_id, 200, response);
    cJSON_Delete(response);
    if (err != ESP_OK) {
        ESP_LOGE(TUNNEL_TAG, "Failed to send streamed OTA response (%s)", esp_err_to_name(err));
        xSemaphoreGive(s_tunnel_ota_mutex);
        return err;
    }

    if (xTaskCreate(tunnel_ota_reboot_task, "tunnel_ota_reboot", 2048, NULL, 5, NULL) != pdPASS) {
        xSemaphoreGive(s_tunnel_ota_mutex);
        return send_http_error(client->sock, request_id, "Firmware installed but reboot task failed");
    }

    xSemaphoreGive(s_tunnel_ota_mutex);
    return ESP_OK;
}

static esp_err_t forward_streamed_request_to_local_http(tunnel_client_t *client, cJSON *start_header) {
    cJSON *request_id_item = cJSON_GetObjectItemCaseSensitive(start_header, "requestId");
    cJSON *method_item = cJSON_GetObjectItemCaseSensitive(start_header, "method");
    cJSON *target_item = cJSON_GetObjectItemCaseSensitive(start_header, "target");
    cJSON *headers_item = cJSON_GetObjectItemCaseSensitive(start_header, "headers");
    cJSON *body_len_item = cJSON_GetObjectItemCaseSensitive(start_header, "requestBodyLength");

    if (!cJSON_IsString(request_id_item) ||
        !cJSON_IsString(method_item) ||
        !cJSON_IsString(target_item) ||
        !cJSON_IsNumber(body_len_item) ||
        body_len_item->valuedouble < 0) {
        ESP_LOGE(TUNNEL_TAG, "Invalid streamed HTTP request start frame");
        return send_http_error(client->sock, NULL, "Malformed streamed httpRequest frame");
    }

    const char *request_id = request_id_item->valuestring;
    const char *method = method_item->valuestring;
    const char *target = target_item->valuestring;
    size_t request_body_len = (size_t)body_len_item->valuedouble;

    if (strcasecmp(method, "POST") == 0 && is_ota_upload_target(target)) {
        return handle_streamed_ota_upload(client, request_id, request_body_len);
    }

    if (!is_tunnel_forward_allowed(target)) {
        ESP_LOGW(TUNNEL_TAG, "Rejecting non-API streamed tunnel request: %s %s", method, target);
        return send_tunnel_rejected_http_response(client->sock, request_id, target);
    }

    char normalized_path[256];
    const char *local_path = normalize_target(target, normalized_path, sizeof(normalized_path));

    char url[256];
    snprintf(url, sizeof(url), "http://127.0.0.1%s", (*local_path) ? local_path : "/");

    ESP_LOGI(TUNNEL_TAG,
             "Forwarding streamed HTTP request %s %s (%u bytes)",
             method,
             local_path,
             (unsigned int)request_body_len);

    esp_http_client_config_t http_cfg = {
        .url = url,
        .method = http_method_from_string(method),
        .timeout_ms = is_ota_upload_target(target) ? LOCAL_HTTP_OTA_TIMEOUT_MS : LOCAL_HTTP_TIMEOUT_MS,
        .buffer_size = 1024,
        .buffer_size_tx = 1024,
    };

    esp_http_client_handle_t http_client = esp_http_client_init(&http_cfg);
    if (!http_client) {
        return send_http_error(client->sock, request_id, "Failed to init local HTTP client");
    }

    if (headers_item && cJSON_IsObject(headers_item)) {
        cJSON *header = NULL;
        cJSON_ArrayForEach(header, headers_item) {
            const char *key = header->string;
            if (!key || !cJSON_IsArray(header)) {
                continue;
            }
            cJSON *value_item = cJSON_GetArrayItem(header, 0);
            if (!value_item || !cJSON_IsString(value_item)) {
                continue;
            }
            if (strcasecmp(key, "content-length") == 0) {
                continue;
            }
            if (strcasecmp(key, "connection") == 0) {
                continue;
            }
            esp_http_client_set_header(http_client, key, value_item->valuestring);
        }
    }
    esp_http_client_set_header(http_client, "Connection", "close");

    esp_err_t err = esp_http_client_open(http_client, (int)request_body_len);
    if (err != ESP_OK) {
        ESP_LOGE(TUNNEL_TAG, "Local HTTP stream open failed: %s", esp_err_to_name(err));
        esp_http_client_cleanup(http_client);
        return send_http_error(client->sock, request_id, "Failed to open local HTTP request");
    }

    size_t remaining = request_body_len;
    while (remaining > 0) {
        cJSON *chunk_header = NULL;
        uint8_t *chunk_body = NULL;
        size_t chunk_len = 0;
        err = read_frame(client->sock, &chunk_header, &chunk_body, &chunk_len);
        if (err != ESP_OK) {
            ESP_LOGE(TUNNEL_TAG, "Failed to read streamed request chunk: %s", esp_err_to_name(err));
            if (chunk_body) free(chunk_body);
            if (chunk_header) cJSON_Delete(chunk_header);
            esp_http_client_close(http_client);
            esp_http_client_cleanup(http_client);
            return err;
        }

        cJSON *type_item = cJSON_GetObjectItemCaseSensitive(chunk_header, "type");
        const char *type = cJSON_IsString(type_item) ? type_item->valuestring : NULL;
        if (!type || strcmp(type, "httpRequestChunk") != 0 || !request_id_matches(chunk_header, request_id)) {
            ESP_LOGE(TUNNEL_TAG, "Unexpected frame while reading streamed request body");
            if (chunk_body) free(chunk_body);
            cJSON_Delete(chunk_header);
            esp_http_client_close(http_client);
            esp_http_client_cleanup(http_client);
            return send_http_error(client->sock, request_id, "Unexpected streamed request frame");
        }
        if (chunk_len > remaining) {
            ESP_LOGE(TUNNEL_TAG, "Streamed request chunk exceeds remaining body length");
            if (chunk_body) free(chunk_body);
            cJSON_Delete(chunk_header);
            esp_http_client_close(http_client);
            esp_http_client_cleanup(http_client);
            return send_http_error(client->sock, request_id, "Streamed request body length mismatch");
        }

        err = http_client_write_all(http_client, chunk_body, chunk_len);
        if (chunk_body) free(chunk_body);
        cJSON_Delete(chunk_header);
        if (err != ESP_OK) {
            esp_http_client_close(http_client);
            esp_http_client_cleanup(http_client);
            return send_http_error(client->sock, request_id, "Failed to write local HTTP request body");
        }
        remaining -= chunk_len;
    }

    cJSON *end_header = NULL;
    uint8_t *end_body = NULL;
    size_t end_body_len = 0;
    err = read_frame(client->sock, &end_header, &end_body, &end_body_len);
    if (err != ESP_OK) {
        ESP_LOGE(TUNNEL_TAG, "Failed to read streamed request end: %s", esp_err_to_name(err));
        if (end_body) free(end_body);
        if (end_header) cJSON_Delete(end_header);
        esp_http_client_close(http_client);
        esp_http_client_cleanup(http_client);
        return err;
    }

    cJSON *end_type_item = cJSON_GetObjectItemCaseSensitive(end_header, "type");
    const char *end_type = cJSON_IsString(end_type_item) ? end_type_item->valuestring : NULL;
    bool valid_end = end_type &&
                     strcmp(end_type, "httpRequestEnd") == 0 &&
                     request_id_matches(end_header, request_id) &&
                     end_body_len == 0;
    if (end_body) free(end_body);
    cJSON_Delete(end_header);
    if (!valid_end) {
        ESP_LOGE(TUNNEL_TAG, "Invalid streamed request end frame");
        esp_http_client_close(http_client);
        esp_http_client_cleanup(http_client);
        return send_http_error(client->sock, request_id, "Invalid streamed request end frame");
    }

    http_stream_context_t stream_ctx = {
        .client = client,
        .header_count = 0,
        .start_sent = false,
        .finished = false,
        .error = false,
        .last_err = ESP_OK,
    };
    snprintf(stream_ctx.request_id, sizeof(stream_ctx.request_id), "%s", request_id);

    err = finish_streamed_local_response(&stream_ctx, http_client);
    esp_http_client_close(http_client);
    esp_http_client_cleanup(http_client);

    if (err != ESP_OK) {
        ESP_LOGE(TUNNEL_TAG, "Failed to forward streamed local response: %s", esp_err_to_name(err));
        if (!stream_ctx.start_sent) {
            return send_http_error(client->sock, request_id, "Local HTTP request failed");
        }
        if (!stream_ctx.finished) {
            send_http_response_end(&stream_ctx);
        }
        return ESP_FAIL;
    }

    return ESP_OK;
}

static esp_err_t handle_http_request_frame(tunnel_client_t *client, cJSON *header, const uint8_t *body, size_t body_len) {
    if (!client || !header) {
        return ESP_ERR_INVALID_ARG;
    }

    cJSON *request_id_item = cJSON_GetObjectItemCaseSensitive(header, "requestId");
    cJSON *method_item = cJSON_GetObjectItemCaseSensitive(header, "method");
    cJSON *target_item = cJSON_GetObjectItemCaseSensitive(header, "target");
    cJSON *headers_item = cJSON_GetObjectItemCaseSensitive(header, "headers");

    if (!cJSON_IsString(request_id_item) || !cJSON_IsString(method_item) || !cJSON_IsString(target_item)) {
        ESP_LOGE(TUNNEL_TAG, "Invalid HTTP request frame");
        return send_http_error(client->sock, NULL, "Malformed httpRequest frame");
    }

    return forward_request_to_local_http(client,
                                         request_id_item->valuestring,
                                         method_item->valuestring,
                                         target_item->valuestring,
                                         headers_item,
                                         body,
                                         body_len);
}

static esp_err_t read_frame(int sock, cJSON **header_out, uint8_t **body_out, size_t *body_len_out) {
    if (!header_out || !body_out || !body_len_out) {
        return ESP_ERR_INVALID_ARG;
    }

    uint32_t header_len_be = 0;
    esp_err_t err = read_exact(sock, (uint8_t *)&header_len_be, sizeof(header_len_be));
    if (err != ESP_OK) {
        return err;
    }

    uint32_t header_len = ntohl(header_len_be);
    if (header_len == 0 || header_len > TUNNEL_MAX_HEADER_BYTES) {
        ESP_LOGE(TUNNEL_TAG, "Invalid frame header length: %u", header_len);
        return ESP_FAIL;
    }

    char *header_buf = malloc(header_len + 1);
    if (!header_buf) {
        return ESP_ERR_NO_MEM;
    }

    err = read_exact(sock, (uint8_t *)header_buf, header_len);
    if (err != ESP_OK) {
        free(header_buf);
        return err;
    }
    header_buf[header_len] = '\0';

    cJSON *header = cJSON_Parse(header_buf);
    free(header_buf);
    if (!header) {
        ESP_LOGE(TUNNEL_TAG, "Failed to parse frame header JSON");
        return ESP_FAIL;
    }

    size_t body_len = 0;
    cJSON *body_len_item = cJSON_GetObjectItemCaseSensitive(header, "bodyLength");
    if (cJSON_IsNumber(body_len_item)) {
        double len_value = body_len_item->valuedouble;
        if (len_value < 0 || len_value > TUNNEL_MAX_BODY_BYTES) {
            ESP_LOGE(TUNNEL_TAG, "Invalid body length: %.0f", len_value);
            cJSON_Delete(header);
            return ESP_FAIL;
        }
        body_len = (size_t)len_value;
    }

    uint8_t *body = NULL;
    if (body_len > 0) {
        body = malloc(body_len);
        if (!body) {
            cJSON_Delete(header);
            return ESP_ERR_NO_MEM;
        }
        err = read_exact(sock, body, body_len);
        if (err != ESP_OK) {
            free(body);
            cJSON_Delete(header);
            return err;
        }
    }

    *header_out = header;
    *body_out = body;
    *body_len_out = body_len;
    return ESP_OK;
}

static void close_tunnel_socket(tunnel_client_t *client) {
    if (client && client->sock >= 0) {
        close(client->sock);
        client->sock = -1;
    }
    if (client) {
        client->identified = false;
        client->assigned_id[0] = '\0';
    }
}

static esp_err_t connect_tunnel_socket(tunnel_client_t *client) {
    if (!client) {
        return ESP_ERR_INVALID_ARG;
    }

    char port_str[8];
    snprintf(port_str, sizeof(port_str), "%d", client->config.port);

    struct addrinfo hints = {
        .ai_family = AF_INET,
        .ai_socktype = SOCK_STREAM,
    };

    struct addrinfo *res = NULL;
    int err = getaddrinfo(client->config.host, port_str, &hints, &res);
    if (err != 0 || !res) {
        ESP_LOGE(TUNNEL_TAG, "getaddrinfo failed: %d", err);
        return ESP_FAIL;
    }

    int sock = -1;
    struct addrinfo *ptr = res;
    while (ptr) {
        sock = socket(ptr->ai_family, ptr->ai_socktype, 0);
        if (sock < 0) {
            ptr = ptr->ai_next;
            continue;
        }

        // Non-blocking connect with a bounded timeout so a stalled connect
        // (unreachable server, half-open network path) can't wedge the reconnect
        // loop for the OS default (~1-2 min). Restore blocking mode once connected.
        int flags = fcntl(sock, F_GETFL, 0);
        fcntl(sock, F_SETFL, flags | O_NONBLOCK);
        int cr = connect(sock, ptr->ai_addr, ptr->ai_addrlen);
        bool connected = (cr == 0);
        if (cr < 0 && errno == EINPROGRESS) {
            fd_set wset;
            FD_ZERO(&wset);
            FD_SET(sock, &wset);
            struct timeval tv = {
                .tv_sec = TUNNEL_CONNECT_TIMEOUT_MS / 1000,
                .tv_usec = (TUNNEL_CONNECT_TIMEOUT_MS % 1000) * 1000,
            };
            if (select(sock + 1, NULL, &wset, NULL, &tv) > 0) {
                int soerr = 0;
                socklen_t slen = sizeof(soerr);
                if (getsockopt(sock, SOL_SOCKET, SO_ERROR, &soerr, &slen) == 0 && soerr == 0) {
                    connected = true;
                }
            }
        }
        if (connected) {
            fcntl(sock, F_SETFL, flags);
            break;
        }
        close(sock);
        sock = -1;
        ptr = ptr->ai_next;
    }

    freeaddrinfo(res);

    if (sock < 0) {
        ESP_LOGE(TUNNEL_TAG, "Unable to connect to %s:%d", client->config.host, client->config.port);
        return ESP_FAIL;
    }

    int keepalive = 1;
    setsockopt(sock, SOL_SOCKET, SO_KEEPALIVE, &keepalive, sizeof(keepalive));
    // Detect a silently-dead link quickly (~30s) so we reconnect fast instead of
    // blocking on recv for the multi-hour OS default. Best-effort (ignored if the
    // lwip build lacks per-socket keepalive tuning).
    int keepidle = 15, keepintvl = 5, keepcnt = 3;
    setsockopt(sock, IPPROTO_TCP, TCP_KEEPIDLE, &keepidle, sizeof(keepidle));
    setsockopt(sock, IPPROTO_TCP, TCP_KEEPINTVL, &keepintvl, sizeof(keepintvl));
    setsockopt(sock, IPPROTO_TCP, TCP_KEEPCNT, &keepcnt, sizeof(keepcnt));

    client->sock = sock;
    ESP_LOGI(TUNNEL_TAG, "Connected tunnel socket to %s:%d", client->config.host, client->config.port);
    return ESP_OK;
}

static void tunnel_main_loop(tunnel_client_t *client) {
    while (1) {
        cJSON *header = NULL;
        uint8_t *body = NULL;
        size_t body_len = 0;

        esp_err_t err = read_frame(client->sock, &header, &body, &body_len);
        if (err != ESP_OK) {
            ESP_LOGW(TUNNEL_TAG, "Frame read failed, reconnecting");
            if (body) {
                free(body);
            }
            if (header) {
                cJSON_Delete(header);
            }
            break;
        }

        cJSON *type_item = cJSON_GetObjectItemCaseSensitive(header, "type");
        const char *type = cJSON_IsString(type_item) ? type_item->valuestring : NULL;

        if (!type) {
            ESP_LOGW(TUNNEL_TAG, "Received frame without type");
            cJSON_Delete(header);
            if (body) {
                free(body);
            }
            continue;
        }

        if (strcmp(type, "assign") == 0) {
            cJSON *device_id_item = cJSON_GetObjectItemCaseSensitive(header, "deviceId");
            if (cJSON_IsString(device_id_item)) {
                snprintf(client->assigned_id, sizeof(client->assigned_id), "%s", device_id_item->valuestring);
                ESP_LOGI(TUNNEL_TAG, "Assigned device ID: %s", client->assigned_id);
            }
            if (strlen(client->assigned_id) > 0) {
                cJSON *identify = cJSON_CreateObject();
                if (identify) {
                    const char *identity = (device_id[0] != '\0') ? device_id : client->assigned_id;
                    cJSON_AddStringToObject(identify, "type", "identify");
                    cJSON_AddStringToObject(identify, "deviceId", identity);
                    if (send_frame(client->sock, identify, NULL, 0) == ESP_OK) {
                        client->identified = true;
                        if (identity != client->assigned_id) {
                            snprintf(client->assigned_id, sizeof(client->assigned_id), "%s", identity);
                        }
                    }
                    cJSON_Delete(identify);
                }
            }
        } else if (strcmp(type, "ready") == 0) {
            cJSON *device_id_item = cJSON_GetObjectItemCaseSensitive(header, "deviceId");
            if (cJSON_IsString(device_id_item)) {
                snprintf(client->assigned_id, sizeof(client->assigned_id), "%s", device_id_item->valuestring);
                ESP_LOGI(TUNNEL_TAG, "Tunnel ready acknowledged by server (deviceId=%s)", client->assigned_id);
            } else {
                ESP_LOGI(TUNNEL_TAG, "Tunnel ready acknowledged by server");
            }
        } else if (strcmp(type, "ping") == 0) {
            send_simple_frame(client->sock, "pong");
        } else if (strcmp(type, "httpRequest") == 0) {
            handle_http_request_frame(client, header, body, body_len);
        } else if (strcmp(type, "httpRequestStart") == 0) {
            forward_streamed_request_to_local_http(client, header);
        } else if (strcmp(type, "abort") == 0) {
            handle_abort_frame(client, header);
        } else if (strcmp(type, "disconnect") == 0) {
            ESP_LOGW(TUNNEL_TAG, "Server requested disconnect");
            cJSON_Delete(header);
            if (body) {
                free(body);
            }
            break;
        } else {
            ESP_LOGW(TUNNEL_TAG, "Unhandled frame type: %s", type);
        }

        cJSON_Delete(header);
        if (body) {
            free(body);
        }
    }
}

static void tunnel_task(void *param) {
    tunnel_config_t config = {0};
    if (param) {
        memcpy(&config, param, sizeof(config));
        free(param);
    } else {
        load_tunnel_config(&config);
    }

    tunnel_client_t client = {
        .sock = -1,
        .identified = false,
        .assigned_id = {0},
        .config = config,
    };

    while (1) {
        if (connect_tunnel_socket(&client) != ESP_OK) {
            vTaskDelay(pdMS_TO_TICKS(TUNNEL_RECONNECT_DELAY_MS));
            continue;
        }

        tunnel_main_loop(&client);
        close_tunnel_socket(&client);
        vTaskDelay(pdMS_TO_TICKS(TUNNEL_RECONNECT_DELAY_MS));
    }
}

void tunnel_start(void) {
    if (!CONFIG_ACCESS_CONTROLLER_ENABLE_TUNNEL) {
        static bool logged_disabled = false;
        if (!logged_disabled) {
            ESP_LOGI(TUNNEL_TAG, "Controller reverse tunnel disabled by firmware config");
            logged_disabled = true;
        }
        return;
    }

    if (tunnel_task_started) {
        return;
    }

    tunnel_config_t *cfg = malloc(sizeof(tunnel_config_t));
    if (!cfg) {
        ESP_LOGE(TUNNEL_TAG, "Failed to allocate tunnel config");
        return;
    }
    load_tunnel_config(cfg);

    char host_copy[sizeof(cfg->host)];
    strncpy(host_copy, cfg->host, sizeof(host_copy) - 1);
    host_copy[sizeof(host_copy) - 1] = '\0';
    int port_copy = cfg->port;

    BaseType_t result = xTaskCreate(&tunnel_task, "tunnel_task", TUNNEL_TASK_STACK_BYTES, cfg, 5, NULL);
    if (result != pdPASS) {
        ESP_LOGE(TUNNEL_TAG,
                 "Failed to create tunnel task (stack=%d free=%lu min=%lu largest=%lu)",
                 TUNNEL_TASK_STACK_BYTES,
                 (unsigned long)esp_get_free_heap_size(),
                 (unsigned long)esp_get_minimum_free_heap_size(),
                 (unsigned long)heap_caps_get_largest_free_block(MALLOC_CAP_8BIT));
        free(cfg);
        return;
    }

    tunnel_task_started = true;
    ESP_LOGI(TUNNEL_TAG, "Tunnel task started (connecting to %s:%d)", host_copy, port_copy);
}
