Wanzi-z/access-controller/code/controller/main/services/store.c

#include <stdio.h>
#include <string.h>
#include <stdlib.h>
#include <inttypes.h>
#include <errno.h>
#include <dirent.h>
#include "freertos/FreeRTOS.h"
#include "freertos/task.h"
#include "esp_system.h"
#include "esp_log.h"
#include "nvs_flash.h"
#include "nvs.h"
#include "esp_spiffs.h"
#include "cJSON.h"
#include "esp_timer.h"
#include "automation.h"
#include "log_store.h"
#include "store.h"

static const char* STORE_TAG = "storage.c";

#define USER_FILE_PATH_FORMAT "/spiffs/user_%05lu.json"
#define USER_FILE_MAX_PATH 64
#define MAX_USER_COUNT 400
#define DEFAULT_SERVER_URL "https://open-automation.org/devices"
#define DEFAULT_SERVER_HOST "open-automation.org"
#define DEFAULT_SERVER_PORT "443"
#define OLD_DEFAULT_SERVER_URL "pyfisecurity.com/devices"
#define OLD_DEFAULT_SERVER_HOST "pyfisecurity.com"
#define OLD_DEFAULT_SERVER_PORT "80"
#define SERVER_URL_MAX_LEN 160
#define SERVER_REQUIRE_REACHABLE_KEY "srv_req_reach"

static bool spiffs_mounted = false;
static portMUX_TYPE settings_cache_mux = portMUX_INITIALIZER_UNLOCKED;
static bool server_cache_loaded = false;
static char cached_server_url[SERVER_URL_MAX_LEN] = DEFAULT_SERVER_URL;
static char cached_server_host[32] = DEFAULT_SERVER_HOST;
static char cached_server_port[8] = DEFAULT_SERVER_PORT;
static bool cached_server_require_reachable = true;
static bool wifi_credentials_cache_loaded = false;
static char cached_wifi_ssid[32] = "";
static char cached_wifi_password[64] = "";

static void get_user_file_path(uint32_t file_index, char *path, size_t path_size) {
    if (!path || path_size == 0) {
        return;
    }
    snprintf(path, path_size, USER_FILE_PATH_FORMAT, (unsigned long)file_index);
}

static bool pin_user_mode_is_valid(const char *mode) {
    return mode &&
        (strcmp(mode, "toggle") == 0 ||
         strcmp(mode, "momentary") == 0 ||
         strcmp(mode, "latch") == 0 ||
         strcmp(mode, "exit") == 0 ||
         strcmp(mode, "power_on") == 0 ||
         strcmp(mode, "power_off") == 0);
}

static bool json_bool_or_default(const cJSON *item, bool fallback) {
    if (cJSON_IsBool(item)) {
        return cJSON_IsTrue(item);
    }
    if (cJSON_IsNumber(item)) {
        return item->valueint != 0;
    }
    return fallback;
}

static void add_default_pin_user_config(cJSON *user) {
    if (!user) {
        return;
    }
    if (!cJSON_GetObjectItemCaseSensitive(user, "mode")) {
        cJSON_AddStringToObject(user, "mode", "momentary");
    }
    if (!cJSON_GetObjectItemCaseSensitive(user, "channel_mask")) {
        cJSON_AddNumberToObject(user, "channel_mask", 1);
    }
    if (!cJSON_GetObjectItemCaseSensitive(user, "keypad_mask")) {
        cJSON_AddNumberToObject(user, "keypad_mask", 3);
    }
    if (!cJSON_GetObjectItemCaseSensitive(user, "exit_seconds")) {
        cJSON_AddNumberToObject(user, "exit_seconds", 4);
    }
    if (!cJSON_GetObjectItemCaseSensitive(user, "alert")) {
        cJSON_AddBoolToObject(user, "alert", true);
    }
    if (!cJSON_GetObjectItemCaseSensitive(user, "alert_target")) {
        cJSON_AddStringToObject(user, "alert_target", "both");
    }
    if (!cJSON_GetObjectItemCaseSensitive(user, "enabled")) {
        cJSON_AddBoolToObject(user, "enabled", true);
    }
}

static void fill_pin_user_match(cJSON *user, const char *matched_pin, pin_user_match_t *out_user) {
    if (!user || !out_user) {
        return;
    }
    memset(out_user, 0, sizeof(*out_user));

    const cJSON *uuid = cJSON_GetObjectItemCaseSensitive(user, "uuid");
    const cJSON *name = cJSON_GetObjectItemCaseSensitive(user, "name");
    const cJSON *mode = cJSON_GetObjectItemCaseSensitive(user, "mode");
    const cJSON *channel_mask = cJSON_GetObjectItemCaseSensitive(user, "channel_mask");
    const cJSON *keypad_mask = cJSON_GetObjectItemCaseSensitive(user, "keypad_mask");
    const cJSON *channel = cJSON_GetObjectItemCaseSensitive(user, "channel");
    const cJSON *exit_seconds = cJSON_GetObjectItemCaseSensitive(user, "exit_seconds");
    const cJSON *delay = cJSON_GetObjectItemCaseSensitive(user, "delay");
    const cJSON *alert = cJSON_GetObjectItemCaseSensitive(user, "alert");
    const cJSON *alert_target = cJSON_GetObjectItemCaseSensitive(user, "alert_target");
    const cJSON *enabled = cJSON_GetObjectItemCaseSensitive(user, "enabled");

    strlcpy(out_user->uuid,
            (cJSON_IsString(uuid) && uuid->valuestring) ? uuid->valuestring : "",
            sizeof(out_user->uuid));
    strlcpy(out_user->name,
            (cJSON_IsString(name) && name->valuestring) ? name->valuestring : "PIN User",
            sizeof(out_user->name));
    strlcpy(out_user->pin, matched_pin ? matched_pin : "", sizeof(out_user->pin));
    strlcpy(out_user->mode,
            (cJSON_IsString(mode) && pin_user_mode_is_valid(mode->valuestring)) ? mode->valuestring : "momentary",
            sizeof(out_user->mode));

    if (cJSON_IsNumber(channel_mask)) {
        out_user->channel_mask = (int)channel_mask->valuedouble;
    } else if (cJSON_IsNumber(channel)) {
        int ch = (int)channel->valuedouble;
        out_user->channel_mask = (ch >= 1 && ch <= 2) ? (1 << (ch - 1)) : 1;
    } else {
        out_user->channel_mask = 1;
    }
    if (out_user->channel_mask <= 0 || out_user->channel_mask > 3) {
        out_user->channel_mask = 1;
    }
    out_user->keypad_mask = cJSON_IsNumber(keypad_mask) ? (int)keypad_mask->valuedouble : 3;
    if (out_user->keypad_mask <= 0 || out_user->keypad_mask > 3) {
        out_user->keypad_mask = 3;
    }

    if (cJSON_IsNumber(exit_seconds)) {
        out_user->exit_seconds = (int)exit_seconds->valuedouble;
    } else if (cJSON_IsNumber(delay)) {
        out_user->exit_seconds = (int)delay->valuedouble;
    } else {
        out_user->exit_seconds = 4;
    }
    if (out_user->exit_seconds <= 0) {
        out_user->exit_seconds = 4;
    }

    out_user->alert = json_bool_or_default(alert, true);
    if (cJSON_IsString(alert_target) && alert_target->valuestring) {
        out_user->alert_target = alert_target_from_string(alert_target->valuestring, out_user->alert);
    } else if (cJSON_IsNumber(alert_target)) {
        out_user->alert_target = alert_target_normalize(alert_target->valueint, out_user->alert);
    } else {
        out_user->alert_target = alert_target_from_bool(out_user->alert);
    }
    out_user->alert = out_user->alert_target != ALERT_TARGET_NONE;
    out_user->enabled = json_bool_or_default(enabled, true);
}

static esp_err_t ensure_spiffs(void) {
    if (spiffs_mounted) {
        return ESP_OK;
    }

    esp_vfs_spiffs_conf_t conf = {
        .base_path = "/spiffs",
        .partition_label = NULL,
        .max_files = 8,
        .format_if_mount_failed = true
    };

    esp_err_t ret = esp_vfs_spiffs_register(&conf);
    if (ret != ESP_OK) {
        if (ret == ESP_FAIL) {
            ESP_LOGE(STORE_TAG, "Failed to mount or format filesystem");
        } else if (ret == ESP_ERR_NOT_FOUND) {
            ESP_LOGE(STORE_TAG, "Failed to find SPIFFS partition");
        } else {
            ESP_LOGE(STORE_TAG, "Failed to initialize SPIFFS (%s)", esp_err_to_name(ret));
        }
        return ret;
    }

    size_t total = 0, used = 0;
    ret = esp_spiffs_info(NULL, &total, &used);
    if (ret != ESP_OK) {
        ESP_LOGE(STORE_TAG, "Failed to get SPIFFS info (%s)", esp_err_to_name(ret));
    } else {
        ESP_LOGI(STORE_TAG, "SPIFFS mounted: total=%d, used=%d", total, used);
    }

    spiffs_mounted = true;
    return ESP_OK;
}

static esp_err_t set_char(const char* key, const char* value) {
    nvs_handle_t my_handle;
    esp_err_t err;

    err = nvs_open("storage", NVS_READWRITE, &my_handle);
    if (err != ESP_OK) {
        ESP_LOGE(STORE_TAG, "Error (%s) opening NVS handle!", esp_err_to_name(err));
        return err;
    }

    err = nvs_set_str(my_handle, key, value);
    if (err == ESP_ERR_NVS_NOT_ENOUGH_SPACE) {
        ESP_LOGW(STORE_TAG, "NVS full while saving %s; clearing system logs and retrying", key);
        nvs_close(my_handle);
        log_store_clear();
        char log_msg[LOG_STORE_MESSAGE_MAX];
        snprintf(log_msg, sizeof(log_msg), "Cleared logs to free space for key %s", key);
        automation_record_log(log_msg);

                err = nvs_open("storage", NVS_READWRITE, &my_handle);
                if (err == ESP_OK) {
                    err = nvs_set_str(my_handle, key, value);
        }
    } else if (err != ESP_OK) {
        ESP_LOGW(STORE_TAG, "Error (%s) setting string %s, continuing anyway", esp_err_to_name(err), key);
    }

    if (err == ESP_OK) {
        esp_err_t commit_err = nvs_commit(my_handle);
        if (commit_err != ESP_OK) {
            ESP_LOGW(STORE_TAG, "Error (%s) committing %s", esp_err_to_name(commit_err), key);
            err = commit_err;
    } else {
        ESP_LOGI(STORE_TAG, "Successfully saved %s", key);
    }
    } else {
        ESP_LOGE(STORE_TAG, "Failed to save %s: %s", key, esp_err_to_name(err));
    }

    nvs_close(my_handle);
    return err;
}

char* get_char(const char* key) {
    nvs_handle_t my_handle;
    esp_err_t err;

    err = nvs_open("storage", NVS_READWRITE, &my_handle);
    if (err != ESP_OK) {
        ESP_LOGE(STORE_TAG, "Error (%s) opening NVS handle!", esp_err_to_name(err));
        return strdup("");
    }

    size_t required_size = 0;
    err = nvs_get_str(my_handle, key, NULL, &required_size);
    if (err == ESP_ERR_NVS_NOT_FOUND) {
        // Many keys are optional; missing should not spam the logs at error level.
        ESP_LOGD(STORE_TAG, "[%s] value not initialized, key: %s", STORE_TAG, key);
        nvs_close(my_handle);
        return strdup("");
    } else if (err != ESP_OK) {
        ESP_LOGW(STORE_TAG, "Error (%s) reading size for %s", esp_err_to_name(err), key);
        nvs_close(my_handle);
        return strdup("");
    }

    char* value = malloc(required_size);
    if (value == NULL) {
        ESP_LOGE(STORE_TAG, "Failed to allocate memory for %s", key);
        nvs_close(my_handle);
        return strdup("");
    }

    err = nvs_get_str(my_handle, key, value, &required_size);
    if (err != ESP_OK) {
        ESP_LOGW(STORE_TAG, "Error (%s) reading %s", esp_err_to_name(err), key);
        free(value);
        nvs_close(my_handle);
        return strdup("");
    }

    nvs_close(my_handle);
    return value;
}

void set_bool(const char* key, bool value) {
    static SemaphoreHandle_t storage_mutex = NULL;
    
    // Initialize mutex on first call
    if (storage_mutex == NULL) {
        storage_mutex = xSemaphoreCreateMutex();
        if (storage_mutex == NULL) {
            ESP_LOGE(STORE_TAG, "Failed to create storage mutex!");
            return;
        }
    }
    
    // Wait for mutex with timeout
    if (xSemaphoreTake(storage_mutex, pdMS_TO_TICKS(100)) != pdTRUE) {
        ESP_LOGW(STORE_TAG, "Timeout waiting for storage mutex for key: %s", key);
        return;
    }
    
    nvs_handle_t my_handle;
    esp_err_t err;

    err = nvs_open("storage", NVS_READWRITE, &my_handle);
    if (err != ESP_OK) {
        ESP_LOGE(STORE_TAG, "Error (%s) opening NVS handle!", esp_err_to_name(err));
        xSemaphoreGive(storage_mutex);
        return;
    }

    uint8_t val = value ? 1 : 0;
    bool retried = false;

    while (true) {
    err = nvs_set_u8(my_handle, key, val);
        if (err == ESP_ERR_NVS_NOT_ENOUGH_SPACE && !retried) {
            ESP_LOGW(STORE_TAG, "NVS full while saving bool %s; clearing system logs and retrying", key);
        nvs_close(my_handle);
            log_store_clear();
            char log_msg[LOG_STORE_MESSAGE_MAX];
            snprintf(log_msg, sizeof(log_msg), "Cleared logs to free space for key %s", key);
            automation_record_log(log_msg);
            retried = true;
                err = nvs_open("storage", NVS_READWRITE, &my_handle);
            if (err != ESP_OK) {
                break;
            }
            continue;
        }
        break;
    }

    if (err == ESP_OK) {
        esp_err_t commit_err = nvs_commit(my_handle);
        if (commit_err != ESP_OK) {
            ESP_LOGE(STORE_TAG, "Error (%s) committing bool %s", esp_err_to_name(commit_err), key);
            err = commit_err;
    } else {
        ESP_LOGI(STORE_TAG, "Successfully saved bool %s", key);
    }
    } else {
        ESP_LOGE(STORE_TAG, "Failed to save bool %s: %s", key, esp_err_to_name(err));
    }

    nvs_close(my_handle);
    xSemaphoreGive(storage_mutex);

    if (err != ESP_OK) {
        char msg[LOG_STORE_MESSAGE_MAX];
        snprintf(msg, sizeof(msg), "Failed to persist bool %s (err=%s)", key, esp_err_to_name(err));
        automation_record_log(msg);
    }
}

bool get_bool(const char* key, bool default_value) {
    nvs_handle_t my_handle;
    esp_err_t err;

    err = nvs_open("storage", NVS_READWRITE, &my_handle);
    if (err != ESP_OK) {
        ESP_LOGE(STORE_TAG, "Error (%s) opening NVS handle!", esp_err_to_name(err));
        return default_value;
    }

    uint8_t value = default_value ? 1 : 0;
    err = nvs_get_u8(my_handle, key, &value);
    if (err == ESP_ERR_NVS_NOT_FOUND) {
        ESP_LOGW(STORE_TAG, "Bool key %s not found, returning default", key);
        nvs_close(my_handle);
        return default_value;
    } else if (err != ESP_OK) {
        ESP_LOGW(STORE_TAG, "Error (%s) reading bool %s, returning default", esp_err_to_name(err), key);
        nvs_close(my_handle);
        return default_value;
    }

    nvs_close(my_handle);
    return value != 0;
}

static esp_err_t set_u32(const char* key, uint32_t value) {
    nvs_handle_t my_handle;
    esp_err_t err = nvs_open("storage", NVS_READWRITE, &my_handle);
    if (err != ESP_OK) {
        ESP_LOGE(STORE_TAG, "Error (%s) opening NVS handle!", esp_err_to_name(err));
        return err;
    }

    bool retried = false;
    while (true) {
    err = nvs_set_u32(my_handle, key, value);
        if (err == ESP_ERR_NVS_NOT_ENOUGH_SPACE && !retried) {
            ESP_LOGW(STORE_TAG, "NVS full while saving u32 %s; clearing system logs and retrying", key);
        nvs_close(my_handle);
            log_store_clear();
            char log_msg[LOG_STORE_MESSAGE_MAX];
            snprintf(log_msg, sizeof(log_msg), "Cleared logs to free space for key %s", key);
            automation_record_log(log_msg);
            retried = true;
                err = nvs_open("storage", NVS_READWRITE, &my_handle);
            if (err != ESP_OK) {
                break;
            }
            continue;
        }
        break;
    }

    if (err == ESP_OK) {
        esp_err_t commit_err = nvs_commit(my_handle);
        if (commit_err != ESP_OK) {
            ESP_LOGE(STORE_TAG, "Error (%s) committing u32 %s", esp_err_to_name(commit_err), key);
            err = commit_err;
    } else {
        ESP_LOGI(STORE_TAG, "Successfully saved u32 %s", key);
    }
    } else {
        ESP_LOGE(STORE_TAG, "Failed to save u32 %s: %s", key, esp_err_to_name(err));
    }

    nvs_close(my_handle);

    if (err != ESP_OK) {
        char msg[LOG_STORE_MESSAGE_MAX];
        snprintf(msg, sizeof(msg), "Failed to persist u32 %s (err=%s)", key, esp_err_to_name(err));
        automation_record_log(msg);
    }

    return err;
}

uint32_t get_u32(const char* key, uint32_t default_value) {
    nvs_handle_t my_handle;
    esp_err_t err;

    err = nvs_open("storage", NVS_READWRITE, &my_handle);
    if (err != ESP_OK) {
        ESP_LOGE(STORE_TAG, "Error (%s) opening NVS handle!", esp_err_to_name(err));
        return default_value;
    }

    uint32_t value = default_value;
    err = nvs_get_u32(my_handle, key, &value);
    if (err == ESP_ERR_NVS_NOT_FOUND) {
        // Missing u32 keys are common on first boot; don't spam error logs.
        ESP_LOGD(STORE_TAG, "[get_u32]: value not initialized, key: %s", key);
        nvs_close(my_handle);
        return default_value;
    } else if (err != ESP_OK) {
        ESP_LOGW(STORE_TAG, "Error (%s) reading u32 %s", esp_err_to_name(err), key);
        nvs_close(my_handle);
        return default_value;
    }

    nvs_close(my_handle);
    return value;
}

// Wrapper functions for backward compatibility
esp_err_t store_char(const char* key, const char* value) {
    return set_char(key, value);
}

void store_u32(const char* key, uint32_t value) {
    esp_err_t err = set_u32(key, value);
    if (err != ESP_OK) {
        ESP_LOGW(STORE_TAG, "store_u32 failed for %s (err=%s)", key, esp_err_to_name(err));
    }
}

// Dummy implementations for missing functions
esp_err_t initialize_spiffs(void) {
    return ensure_spiffs();
}

void load_wifi_credentials_from_flash(char *ssid, char *password) {
    bool loaded;
    portENTER_CRITICAL(&settings_cache_mux);
    loaded = wifi_credentials_cache_loaded;
    if (loaded) {
        snprintf(ssid, 32, "%s", cached_wifi_ssid);
        snprintf(password, 64, "%s", cached_wifi_password);
    }
    portEXIT_CRITICAL(&settings_cache_mux);

    if (loaded) {
        return;
    }

    char *ssid_str = get_char("wifi_ssid");
    char *password_str = get_char("wifi_password");

    if (strcmp(ssid_str, "")==0 || strcmp(password_str, "")==0) {
        snprintf(ssid, 32, "%s", "");
        snprintf(password, 64, "%s", "");
    } else {
        snprintf(ssid, 32, "%s", ssid_str);
        snprintf(password, 64, "%s", password_str);
    }

    portENTER_CRITICAL(&settings_cache_mux);
    snprintf(cached_wifi_ssid, sizeof(cached_wifi_ssid), "%s", ssid);
    snprintf(cached_wifi_password, sizeof(cached_wifi_password), "%s", password);
    wifi_credentials_cache_loaded = true;
    portEXIT_CRITICAL(&settings_cache_mux);

    free(ssid_str);
    free(password_str);
}

static void trim_copy(const char *input, char *output, size_t output_size) {
    if (!output || output_size == 0) {
        return;
    }
    output[0] = '\0';
    if (!input) {
        return;
    }

    while (*input == ' ' || *input == '\t' || *input == '\n' || *input == '\r') {
        input++;
    }

    size_t len = strlen(input);
    while (len > 0) {
        char c = input[len - 1];
        if (c != ' ' && c != '\t' && c != '\n' && c != '\r') {
            break;
        }
        len--;
    }

    if (len >= output_size) {
        len = output_size - 1;
    }
    memcpy(output, input, len);
    output[len] = '\0';
}

static bool is_port_digits(const char *port) {
    if (!port || port[0] == '\0') {
        return false;
    }
    for (const char *p = port; *p != '\0'; p++) {
        if (*p < '0' || *p > '9') {
            return false;
        }
    }
    return true;
}

static void parse_server_url(const char *server_url,
                             char *host,
                             size_t host_size,
                             char *port,
                             size_t port_size) {
    if (host && host_size > 0) {
        host[0] = '\0';
    }
    if (port && port_size > 0) {
        port[0] = '\0';
    }
    if (!host || host_size == 0 || !port || port_size == 0) {
        return;
    }

    char normalized[SERVER_URL_MAX_LEN];
    trim_copy(server_url, normalized, sizeof(normalized));
    if (normalized[0] == '\0') {
        snprintf(normalized, sizeof(normalized), "%s", DEFAULT_SERVER_URL);
    }

    const char *cursor = normalized;
    const char *default_port = DEFAULT_SERVER_PORT;
    if (strncmp(cursor, "http://", 7) == 0) {
        cursor += 7;
        default_port = "80";
    } else if (strncmp(cursor, "https://", 8) == 0) {
        cursor += 8;
        default_port = "443";
    }

    const char *host_start = cursor;
    while (*cursor != '\0' && *cursor != ':' && *cursor != '/' && *cursor != '?' && *cursor != '#') {
        cursor++;
    }

    size_t host_len = (size_t)(cursor - host_start);
    if (host_len == 0) {
        snprintf(host, host_size, "%s", DEFAULT_SERVER_HOST);
    } else {
        if (host_len >= host_size) {
            host_len = host_size - 1;
        }
        memcpy(host, host_start, host_len);
        host[host_len] = '\0';
    }

    if (*cursor == ':') {
        cursor++;
        const char *port_start = cursor;
        while (*cursor >= '0' && *cursor <= '9') {
            cursor++;
        }
        size_t port_len = (size_t)(cursor - port_start);
        if (port_len > 0 && port_len < port_size) {
            memcpy(port, port_start, port_len);
            port[port_len] = '\0';
        }
    }

    if (!is_port_digits(port)) {
        snprintf(port, port_size, "%s", default_port);
    }
}

static void cache_server_settings(const char *url, const char *host, const char *port, bool require_reachable) {
    portENTER_CRITICAL(&settings_cache_mux);
    snprintf(cached_server_url, sizeof(cached_server_url), "%s", url && url[0] ? url : DEFAULT_SERVER_URL);
    snprintf(cached_server_host, sizeof(cached_server_host), "%s", host && host[0] ? host : DEFAULT_SERVER_HOST);
    snprintf(cached_server_port, sizeof(cached_server_port), "%s", port && port[0] ? port : DEFAULT_SERVER_PORT);
    cached_server_require_reachable = require_reachable;
    server_cache_loaded = true;
    portEXIT_CRITICAL(&settings_cache_mux);
}

static bool read_server_settings_cache(char *url, size_t url_size, char *host, size_t host_size, char *port, size_t port_size, bool *require_reachable) {
    bool loaded;
    portENTER_CRITICAL(&settings_cache_mux);
    loaded = server_cache_loaded;
    if (loaded) {
        if (url && url_size > 0) snprintf(url, url_size, "%s", cached_server_url);
        if (host && host_size > 0) snprintf(host, host_size, "%s", cached_server_host);
        if (port && port_size > 0) snprintf(port, port_size, "%s", cached_server_port);
        if (require_reachable) *require_reachable = cached_server_require_reachable;
    }
    portEXIT_CRITICAL(&settings_cache_mux);
    return loaded;
}

static void ensure_server_settings_cache(void) {
    if (read_server_settings_cache(NULL, 0, NULL, 0, NULL, 0, NULL)) {
        return;
    }

    char url[SERVER_URL_MAX_LEN] = DEFAULT_SERVER_URL;
    char host[32] = DEFAULT_SERVER_HOST;
    char port[8] = DEFAULT_SERVER_PORT;
    bool require_reachable = get_bool(SERVER_REQUIRE_REACHABLE_KEY, true);

    char *url_str = get_char("server_url");
    if (url_str && url_str[0] != '\0') {
        trim_copy(url_str, url, sizeof(url));
        if (strcmp(url, OLD_DEFAULT_SERVER_URL) == 0 ||
            strcmp(url, "http://" OLD_DEFAULT_SERVER_URL) == 0) {
            snprintf(url, sizeof(url), "%s", DEFAULT_SERVER_URL);
        }
    } else {
        char *ip_str = get_char("server_ip");
        char *port_str = get_char("server_port");
        if (ip_str && ip_str[0] != '\0') {
            if (port_str && port_str[0] != '\0' && strcmp(port_str, DEFAULT_SERVER_PORT) != 0) {
                snprintf(url, sizeof(url), "%s:%s", ip_str, port_str);
            } else {
                snprintf(url, sizeof(url), "%s", ip_str);
            }
        }
        free(ip_str);
        free(port_str);
    }
    free(url_str);

    parse_server_url(url, host, sizeof(host), port, sizeof(port));
    cache_server_settings(url, host, port, require_reachable);
}

void load_server_url_from_flash(char *server_url, size_t size) {
    if (!server_url || size == 0) {
        return;
    }
    ensure_server_settings_cache();
    read_server_settings_cache(server_url, size, NULL, 0, NULL, 0, NULL);
}

void load_server_info_from_flash(char *server_ip, char *server_port) {
    ensure_server_settings_cache();
    read_server_settings_cache(NULL, 0, server_ip, 32, server_port, 8, NULL);
}

esp_err_t store_server_require_reachable(bool required) {
    set_bool(SERVER_REQUIRE_REACHABLE_KEY, required);
    ensure_server_settings_cache();
    portENTER_CRITICAL(&settings_cache_mux);
    cached_server_require_reachable = required;
    portEXIT_CRITICAL(&settings_cache_mux);
    automation_record_log(required
        ? "Server reachability required for station mode"
        : "Server reachability not required for station mode");
    return ESP_OK;
}

bool load_server_require_reachable(void) {
    bool require_reachable = true;
    ensure_server_settings_cache();
    read_server_settings_cache(NULL, 0, NULL, 0, NULL, 0, &require_reachable);
    return require_reachable;
}

/* ---------- WiFi list management ---------- */
static uint64_t now_ms_store(void) { return esp_timer_get_time() / 1000ULL; }
static esp_err_t wifi_list_save_array(cJSON *arr); // forward
static bool wifi_list_prepend_item(cJSON *arr, cJSON *item); // forward

static cJSON *wifi_list_load_array(void) {
    char *json = get_char("wifi_list");
    cJSON *arr = NULL;
    if (json && json[0] != '\0') {
        arr = cJSON_Parse(json);
    }
    if (!cJSON_IsArray(arr)) {
        if (arr) cJSON_Delete(arr);
        arr = cJSON_CreateArray();
    }
    free(json);

    char active_ssid[32] = {0};
    char active_password[64] = {0};
    load_wifi_credentials_from_flash(active_ssid, active_password);
    if (active_ssid[0] != '\0') {
        bool found = false;
        int count = cJSON_GetArraySize(arr);
        for (int i = 0; i < count; i++) {
            cJSON *item = cJSON_GetArrayItem(arr, i);
            const cJSON *ssid = cJSON_GetObjectItemCaseSensitive(item, "ssid");
            if (cJSON_IsString(ssid) && ssid->valuestring && strcmp(ssid->valuestring, active_ssid) == 0) {
                found = true;
                break;
            }
        }
        if (!found) {
            cJSON *obj = cJSON_CreateObject();
            if (obj) {
                cJSON_AddStringToObject(obj, "ssid", active_ssid);
                cJSON_AddStringToObject(obj, "password", active_password);
                cJSON_AddNumberToObject(obj, "last_used_ms", 0);
                if (!wifi_list_prepend_item(arr, obj)) {
                    cJSON_Delete(obj);
                }
            }
        }
    }

    return arr;
}

static esp_err_t wifi_list_save_array(cJSON *arr) {
    if (!arr) return ESP_ERR_INVALID_ARG;
    char *json = cJSON_PrintUnformatted(arr);
    if (!json) return ESP_ERR_NO_MEM;
    esp_err_t err = store_char("wifi_list", json);
    free(json);
    return err;
}

static void wifi_list_remove_ssid(cJSON *arr, const char *ssid) {
    if (!arr || !ssid) return;
    int count = cJSON_GetArraySize(arr);
    for (int i = count - 1; i >= 0; i--) {
        cJSON *item = cJSON_GetArrayItem(arr, i);
        const cJSON *s = cJSON_GetObjectItemCaseSensitive(item, "ssid");
        if (cJSON_IsString(s) && s->valuestring && strcmp(s->valuestring, ssid) == 0) {
            cJSON_DeleteItemFromArray(arr, i);
        }
    }
}

static bool wifi_list_prepend_item(cJSON *arr, cJSON *item) {
    return arr && item && cJSON_InsertItemInArray(arr, 0, item);
}

static esp_err_t wifi_list_store_first_as_active_or_clear(cJSON *arr) {
    if (!arr || cJSON_GetArraySize(arr) == 0) {
        return store_wifi_credentials_to_flash("", "");
    }

    cJSON *item = cJSON_GetArrayItem(arr, 0);
    const cJSON *ssid = cJSON_GetObjectItemCaseSensitive(item, "ssid");
    const cJSON *password = cJSON_GetObjectItemCaseSensitive(item, "password");
    if (!cJSON_IsString(ssid) || !ssid->valuestring || ssid->valuestring[0] == '\0') {
        return store_wifi_credentials_to_flash("", "");
    }

    const char *pwd = (cJSON_IsString(password) && password->valuestring) ? password->valuestring : "";
    return store_wifi_credentials_to_flash(ssid->valuestring, pwd);
}

esp_err_t wifi_list_add(const char *ssid, const char *password) {
    if (!ssid || ssid[0] == '\0') return ESP_ERR_INVALID_ARG;
    cJSON *arr = wifi_list_load_array();
    if (!arr) return ESP_ERR_NO_MEM;
    wifi_list_remove_ssid(arr, ssid);
    cJSON *obj = cJSON_CreateObject();
    cJSON_AddStringToObject(obj, "ssid", ssid);
    cJSON_AddStringToObject(obj, "password", password ? password : "");
    cJSON_AddNumberToObject(obj, "last_used_ms", (double)now_ms_store());
    if (!wifi_list_prepend_item(arr, obj)) {
        cJSON_Delete(obj);
        cJSON_Delete(arr);
        return ESP_ERR_NO_MEM;
    }
    esp_err_t err = wifi_list_save_array(arr);
    cJSON_Delete(arr);
    // also set active creds
    if (err == ESP_OK) {
        store_wifi_credentials_to_flash(ssid, password ? password : "");
    }
    return err;
}

esp_err_t wifi_list_delete(const char *ssid) {
    if (!ssid) return ESP_ERR_INVALID_ARG;
    cJSON *arr = wifi_list_load_array();
    if (!arr) return ESP_ERR_NO_MEM;
    wifi_list_remove_ssid(arr, ssid);
    esp_err_t err = wifi_list_save_array(arr);
    if (err == ESP_OK) {
        err = wifi_list_store_first_as_active_or_clear(arr);
    }
    cJSON_Delete(arr);
    return err;
}

esp_err_t wifi_list_set_active(const char *ssid) {
    if (!ssid) return ESP_ERR_INVALID_ARG;
    cJSON *arr = wifi_list_load_array();
    if (!arr) return ESP_ERR_NO_MEM;
    cJSON *active_item = NULL;
    char active_password[64] = {0};
    int count = cJSON_GetArraySize(arr);
    for (int i = 0; i < count; i++) {
        cJSON *item = cJSON_GetArrayItem(arr, i);
        const cJSON *s = cJSON_GetObjectItemCaseSensitive(item, "ssid");
        const cJSON *p = cJSON_GetObjectItemCaseSensitive(item, "password");
        if (cJSON_IsString(s) && s->valuestring && strcmp(s->valuestring, ssid) == 0) {
            const char *pwd = (cJSON_IsString(p) && p->valuestring) ? p->valuestring : "";
            strncpy(active_password, pwd, sizeof(active_password) - 1);
            active_item = cJSON_DetachItemFromArray(arr, i);
            break;
        }
    }

    esp_err_t err = ESP_ERR_NOT_FOUND;
    if (active_item) {
        cJSON_DeleteItemFromObject(active_item, "last_used_ms");
        cJSON_AddNumberToObject(active_item, "last_used_ms", (double)now_ms_store());
        if (wifi_list_prepend_item(arr, active_item)) {
            store_wifi_credentials_to_flash(ssid, active_password);
            err = wifi_list_save_array(arr);
        } else {
            cJSON_Delete(active_item);
            err = ESP_ERR_NO_MEM;
        }
    }
    cJSON_Delete(arr);
    return err;
}

cJSON *wifi_list_snapshot(void) {
    cJSON *arr = wifi_list_load_array();
    if (!arr) return NULL;
    // Strip passwords for snapshot
    int count = cJSON_GetArraySize(arr);
    for (int i = 0; i < count; i++) {
        cJSON *item = cJSON_GetArrayItem(arr, i);
        cJSON_DeleteItemFromObject(item, "password");
    }
    return arr;
}

cJSON *wifi_list_credentials_snapshot(void) {
    return wifi_list_load_array();
}

void get_md5_from_flash(char *md5_hash, size_t size) {
    char *stored_md5 = get_char("firmware_md5");
    if (stored_md5 && strlen(stored_md5) > 0) {
        strncpy(md5_hash, stored_md5, size - 1);
        md5_hash[size - 1] = '\0';
    } else {
        md5_hash[0] = '\0';
    }
    free(stored_md5);
}

cJSON* load_user_from_flash(uint32_t user_id) {
    if (user_id == 0 || user_id > MAX_USER_COUNT) {
        return NULL;
    }

    if (ensure_spiffs() != ESP_OK) {
        return NULL;
    }

    char file_path[USER_FILE_MAX_PATH];
    snprintf(file_path, sizeof(file_path), USER_FILE_PATH_FORMAT, (unsigned long)(user_id - 1));

    FILE *file = fopen(file_path, "r");
    if (!file) {
        ESP_LOGD(STORE_TAG, "User file %s not found", file_path);
        return NULL;
    }

    if (fseek(file, 0, SEEK_END) != 0) {
        fclose(file);
        return NULL;
    }
    long length = ftell(file);
    if (length < 0) {
        fclose(file);
        return NULL;
    }
    rewind(file);

    char *buffer = malloc(length + 1);
    if (!buffer) {
        fclose(file);
        return NULL;
    }

    size_t read = fread(buffer, 1, length, file);
    fclose(file);
    buffer[read] = '\0';

    cJSON *user = cJSON_Parse(buffer);
    free(buffer);
    return user;
}

static esp_err_t write_user_to_file(size_t index, cJSON *user) {
    if (!user) return ESP_ERR_INVALID_ARG;
    if (ensure_spiffs() != ESP_OK) {
        return ESP_FAIL;
    }

    char file_path[USER_FILE_MAX_PATH];
    snprintf(file_path, sizeof(file_path), USER_FILE_PATH_FORMAT, (unsigned long)index);

    FILE *file = fopen(file_path, "w");
    if (!file) {
        ESP_LOGE(STORE_TAG, "Failed to open %s for writing", file_path);
        return ESP_FAIL;
    }

    char *json = cJSON_PrintUnformatted(user);
    if (!json) {
        fclose(file);
        return ESP_ERR_NO_MEM;
    }

    fprintf(file, "%s", json);
    fclose(file);
    free(json);
    return ESP_OK;
}

esp_err_t store_user_to_flash(char *uuid, char *name, char *pin) {
    if (!uuid || !name || !pin) {
        ESP_LOGE(STORE_TAG, "Invalid user payload");
        return ESP_ERR_INVALID_ARG;
    }

    uint32_t user_index = get_user_count_from_flash();
    if (user_index >= MAX_USER_COUNT) {
        ESP_LOGE(STORE_TAG, "Reached maximum user count");
        return ESP_ERR_NO_MEM;
    }

    cJSON *user = cJSON_CreateObject();
    if (!user) {
        ESP_LOGE(STORE_TAG, "Failed to allocate user json");
        return ESP_ERR_NO_MEM;
    }

    cJSON_AddStringToObject(user, "uuid", uuid);
    cJSON_AddStringToObject(user, "name", name);
    cJSON_AddStringToObject(user, "pin", pin);
    add_default_pin_user_config(user);
    cJSON *pins = cJSON_CreateArray();
    if (pins) {
        if (pin[0] != '\0') {
            cJSON_AddItemToArray(pins, cJSON_CreateString(pin));
        }
        cJSON_AddItemToObject(user, "pins", pins);
    }

    esp_err_t err = write_user_to_file(user_index, user);
    if (err == ESP_OK) {
        store_u32("auth_user_count", user_index + 1);
        ESP_LOGI(STORE_TAG, "Stored user %s", uuid);
    } else {
        ESP_LOGE(STORE_TAG, "Failed to store user %s (%s)", uuid, esp_err_to_name(err));
    }
    cJSON_Delete(user);
    return err;
}

uint32_t get_user_count_from_flash(void) {
    uint32_t cached_count = get_u32("auth_user_count", 0);
    if (ensure_spiffs() != ESP_OK) {
        return cached_count <= MAX_USER_COUNT ? cached_count : 0;
    }

    uint32_t file_count = 0;
    DIR *dir = opendir("/spiffs");
    if (!dir) {
        ESP_LOGW(STORE_TAG, "Failed to scan PIN user files; using cached count");
        return cached_count <= MAX_USER_COUNT ? cached_count : 0;
    }

    struct dirent *entry;
    while ((entry = readdir(dir)) != NULL) {
        unsigned long file_index = 0;
        char trailing = '\0';
        if (sscanf(entry->d_name, "user_%lu.json%c", &file_index, &trailing) == 1 &&
            file_index < MAX_USER_COUNT && file_index + 1 > file_count) {
            file_count = (uint32_t)file_index + 1;
        }
    }
    closedir(dir);

    if (cached_count != file_count) {
        ESP_LOGW(STORE_TAG,
                 "Repairing PIN user count from files (cached=%" PRIu32 ", files=%" PRIu32 ")",
                 cached_count,
                 file_count);
        store_u32("auth_user_count", file_count);
    }
    return file_count;
}

esp_err_t find_pin_user_in_flash(const char* pin, pin_user_match_t *out_user) {
    if (!pin) return ESP_ERR_INVALID_ARG;

    uint32_t user_count = get_user_count_from_flash();
    ESP_LOGI(STORE_TAG, "Total User Count: %" PRIu32, user_count);

    for (uint32_t i = 0; i < user_count; i++) {
        cJSON *user = load_user_from_flash(i + 1);
        if (!user) continue;

        cJSON *pin_json = cJSON_GetObjectItemCaseSensitive(user, "pin");
        cJSON *pins_json = cJSON_GetObjectItemCaseSensitive(user, "pins");
        bool matched = cJSON_IsString(pin_json) && pin_json->valuestring && strcmp(pin_json->valuestring, pin) == 0;
        if (!matched && cJSON_IsArray(pins_json)) {
            int pin_count = cJSON_GetArraySize(pins_json);
            for (int p = 0; p < pin_count; p++) {
                cJSON *pin_item = cJSON_GetArrayItem(pins_json, p);
                if (cJSON_IsString(pin_item) && pin_item->valuestring && strcmp(pin_item->valuestring, pin) == 0) {
                    matched = true;
                    break;
                }
            }
        }
        if (matched) {
            if (out_user) {
                fill_pin_user_match(user, pin, out_user);
            }
            cJSON_Delete(user);
            return ESP_OK;
        }
        cJSON_Delete(user);
    }

    return ESP_ERR_NOT_FOUND;
}

esp_err_t record_pin_user_use_in_flash(const char *uuid, const char *pin) {
    if (!uuid || uuid[0] == '\0' || !pin || pin[0] == '\0') {
        return ESP_ERR_INVALID_ARG;
    }

    uint32_t user_count = get_user_count_from_flash();
    for (uint32_t i = 0; i < user_count; i++) {
        cJSON *user = load_user_from_flash(i + 1);
        if (!user) {
            continue;
        }

        const cJSON *uuid_json = cJSON_GetObjectItemCaseSensitive(user, "uuid");
        bool uuid_match = cJSON_IsString(uuid_json) && uuid_json->valuestring && strcmp(uuid_json->valuestring, uuid) == 0;
        if (!uuid_match) {
            cJSON_Delete(user);
            continue;
        }

        uint64_t used_ms = now_ms_store();
        cJSON_DeleteItemFromObject(user, "last_used_ms");
        cJSON_AddNumberToObject(user, "last_used_ms", (double)used_ms);
        cJSON_DeleteItemFromObject(user, "last_used_unix_time");
        cJSON_AddNumberToObject(user, "last_used_unix_time", (double)automation_unix_time_for_timestamp_ms(used_ms));
        cJSON_DeleteItemFromObject(user, "last_used_pin");
        cJSON_AddStringToObject(user, "last_used_pin", pin);

        esp_err_t err = write_user_to_file(i + 1, user);
        cJSON_Delete(user);
        return err;
    }

    return ESP_ERR_NOT_FOUND;
}

char* find_pin_in_flash(const char* pin) {
    pin_user_match_t match;
    if (find_pin_user_in_flash(pin, &match) != ESP_OK) {
        return NULL;
    }
    return strdup(match.name);
}

esp_err_t update_pin_user_in_flash(const char *uuid,
                                   const char *name,
                                   const char *pin,
                                   int pin_index,
                                   const char *mode,
                                   int channel_mask,
                                   int keypad_mask,
                                   int exit_seconds,
                                   bool alert,
                                   int alert_target,
                                   bool enabled) {
    if (!uuid || uuid[0] == '\0' || !name || name[0] == '\0' || !mode) {
        return ESP_ERR_INVALID_ARG;
    }
    if (pin && pin[0] != '\0' && (strlen(pin) < 4 || strlen(pin) > 8)) {
        return ESP_ERR_INVALID_ARG;
    }
    if (!pin_user_mode_is_valid(mode) || channel_mask <= 0 || channel_mask > 3 || keypad_mask <= 0 || keypad_mask > 3) {
        return ESP_ERR_INVALID_ARG;
    }
    if (exit_seconds <= 0) {
        exit_seconds = 4;
    }

    uint32_t user_count = get_user_count_from_flash();
    for (uint32_t i = 0; i < user_count; i++) {
        cJSON *user = load_user_from_flash(i + 1);
        if (!user) continue;

        cJSON *uuid_json = cJSON_GetObjectItemCaseSensitive(user, "uuid");
        bool match = cJSON_IsString(uuid_json) && uuid_json->valuestring && strcmp(uuid_json->valuestring, uuid) == 0;
        if (!match) {
            cJSON_Delete(user);
            continue;
        }

        cJSON_DeleteItemFromObject(user, "name");
        cJSON_AddStringToObject(user, "name", name);

        if (pin) {
            cJSON_DeleteItemFromObject(user, "pin");
            cJSON_AddStringToObject(user, "pin", pin);

            if (pin_index >= 0) {
                cJSON *pins = cJSON_GetObjectItemCaseSensitive(user, "pins");
                if (!cJSON_IsArray(pins)) {
                    cJSON_DeleteItemFromObject(user, "pins");
                    pins = cJSON_CreateArray();
                    if (!pins) {
                        cJSON_Delete(user);
                        return ESP_ERR_NO_MEM;
                    }
                    cJSON_AddItemToObject(user, "pins", pins);
                }

                int count = cJSON_GetArraySize(pins);
                if (pin_index >= count) {
                    cJSON_Delete(user);
                    return ESP_ERR_INVALID_ARG;
                }
                cJSON_ReplaceItemInArray(pins, pin_index, cJSON_CreateString(pin));
            } else {
                cJSON_DeleteItemFromObject(user, "pins");
                cJSON *pins = cJSON_CreateArray();
                if (!pins) {
                    cJSON_Delete(user);
                    return ESP_ERR_NO_MEM;
                }
                if (pin[0] != '\0') {
                    cJSON_AddItemToArray(pins, cJSON_CreateString(pin));
                }
                cJSON_AddItemToObject(user, "pins", pins);
            }
        }

        cJSON_DeleteItemFromObject(user, "mode");
        cJSON_AddStringToObject(user, "mode", mode);
        cJSON_DeleteItemFromObject(user, "channel_mask");
        cJSON_AddNumberToObject(user, "channel_mask", channel_mask);
        cJSON_DeleteItemFromObject(user, "keypad_mask");
        cJSON_AddNumberToObject(user, "keypad_mask", keypad_mask);
        cJSON_DeleteItemFromObject(user, "exit_seconds");
        cJSON_AddNumberToObject(user, "exit_seconds", exit_seconds);
        cJSON_DeleteItemFromObject(user, "alert");
        int normalized_alert_target = alert_target_normalize(alert_target, alert);
        cJSON_AddBoolToObject(user, "alert", normalized_alert_target != ALERT_TARGET_NONE);
        cJSON_DeleteItemFromObject(user, "alert_target");
        cJSON_AddStringToObject(user, "alert_target", alert_target_to_string(normalized_alert_target));
        cJSON_DeleteItemFromObject(user, "enabled");
        cJSON_AddBoolToObject(user, "enabled", enabled);

        esp_err_t err = write_user_to_file(i, user);
        cJSON_Delete(user);
        return err;
    }

    return ESP_ERR_NOT_FOUND;
}

void modify_user_from_flash(const char *uuid, const char *newName, const char *newPin) {
    if (!uuid) return;

    uint32_t user_count = get_user_count_from_flash();
    for (uint32_t i = 0; i < user_count; i++) {
        cJSON *user = load_user_from_flash(i + 1);
        if (!user) continue;

        cJSON *uuid_json = cJSON_GetObjectItemCaseSensitive(user, "uuid");
        if (cJSON_IsString(uuid_json) && strcmp(uuid_json->valuestring, uuid) == 0) {
            if (newName) {
                cJSON_ReplaceItemInObject(user, "name", cJSON_CreateString(newName));
            }
            if (newPin) {
                cJSON_DeleteItemFromObject(user, "pin");
                cJSON_AddStringToObject(user, "pin", newPin);
                cJSON *pins = cJSON_CreateArray();
                if (pins && newPin[0] != '\0') {
                    cJSON_AddItemToArray(pins, cJSON_CreateString(newPin));
                }
                if (pins) {
                    cJSON_DeleteItemFromObject(user, "pins");
                    cJSON_AddItemToObject(user, "pins", pins);
                }
            }
            write_user_to_file(i, user);
            cJSON_Delete(user);
            return;
        }
        cJSON_Delete(user);
    }
}

esp_err_t delete_user_from_flash(const char *uuid_to_delete) {
    if (!uuid_to_delete || uuid_to_delete[0] == '\0') {
        return ESP_ERR_INVALID_ARG;
    }

    uint32_t user_count = get_user_count_from_flash();
    bool deleted = false;
    for (uint32_t i = 0; i < user_count;) {
        cJSON *user = load_user_from_flash(i + 1);
        if (!user) {
            i++;
            continue;
        }

        cJSON *uuid_json = cJSON_GetObjectItemCaseSensitive(user, "uuid");
        bool match = cJSON_IsString(uuid_json) && strcmp(uuid_json->valuestring, uuid_to_delete) == 0;
        cJSON_Delete(user);

        if (!match) {
            i++;
            continue;
        }

        for (uint32_t j = i; j < user_count - 1; j++) {
            cJSON *next_user = load_user_from_flash(j + 2);
            if (!next_user) {
                ESP_LOGE(STORE_TAG, "Failed to load user file %" PRIu32 " while deleting %s", j + 1, uuid_to_delete);
                return ESP_FAIL;
            }

            esp_err_t write_err = write_user_to_file(j, next_user);
            cJSON_Delete(next_user);
            if (write_err != ESP_OK) {
                ESP_LOGE(STORE_TAG, "Failed to compact user file %" PRIu32 " while deleting %s", j, uuid_to_delete);
                return write_err;
            }
        }

        char last_path[USER_FILE_MAX_PATH];
        get_user_file_path(user_count - 1, last_path, sizeof(last_path));
        if (remove(last_path) != 0 && errno != ENOENT) {
            ESP_LOGW(STORE_TAG, "Failed to remove stale user file %s: errno=%d", last_path, errno);
        }
        user_count--;
        store_u32("auth_user_count", user_count);
        deleted = true;
        ESP_LOGI(STORE_TAG, "Deleted user %s", uuid_to_delete);
    }

    return deleted ? ESP_OK : ESP_ERR_NOT_FOUND;
}

esp_err_t delete_user_pin_from_flash(const char *uuid, int pin_index) {
    if (!uuid || uuid[0] == '\0' || pin_index < 0) {
        return ESP_ERR_INVALID_ARG;
    }

    uint32_t user_count = get_user_count_from_flash();
    for (uint32_t i = 0; i < user_count; i++) {
        cJSON *user = load_user_from_flash(i + 1);
        if (!user) continue;

        cJSON *uuid_json = cJSON_GetObjectItemCaseSensitive(user, "uuid");
        bool match = cJSON_IsString(uuid_json) && uuid_json->valuestring && strcmp(uuid_json->valuestring, uuid) == 0;
        if (!match) {
            cJSON_Delete(user);
            continue;
        }

        cJSON *pins = cJSON_GetObjectItemCaseSensitive(user, "pins");
        if (!cJSON_IsArray(pins)) {
            cJSON_Delete(user);
            return ESP_ERR_NOT_FOUND;
        }

        int count = cJSON_GetArraySize(pins);
        if (pin_index >= count) {
            cJSON_Delete(user);
            return ESP_ERR_NOT_FOUND;
        }

        cJSON_DeleteItemFromArray(pins, pin_index);
        count = cJSON_GetArraySize(pins);
        if (count == 0) {
            cJSON_Delete(user);
            return delete_user_from_flash(uuid);
        }

        cJSON_DeleteItemFromObject(user, "pin");
        cJSON *first = cJSON_GetArrayItem(pins, 0);
        cJSON_AddStringToObject(user, "pin",
                                (cJSON_IsString(first) && first->valuestring) ? first->valuestring : "");

        esp_err_t err = write_user_to_file(i, user);
        cJSON_Delete(user);
        return err;
    }

    return ESP_ERR_NOT_FOUND;
}

esp_err_t delete_all_users_from_flash(void) {
    if (ensure_spiffs() != ESP_OK) {
        return ESP_FAIL;
    }

    uint32_t user_count = get_user_count_from_flash();
    uint32_t removed = 0;
    DIR *dir = opendir("/spiffs");

    if (dir) {
        struct dirent *entry;
        while ((entry = readdir(dir)) != NULL) {
            if (strncmp(entry->d_name, "user_", 5) != 0 || !strstr(entry->d_name, ".json")) {
                continue;
            }

            char path[USER_FILE_MAX_PATH];
            strlcpy(path, "/spiffs/", sizeof(path));
            strlcat(path, entry->d_name, sizeof(path));
            if (remove(path) == 0) {
                removed++;
            } else if (errno != ENOENT) {
                ESP_LOGW(STORE_TAG, "Failed to remove user file %s: errno=%d", path, errno);
            }
        }
        closedir(dir);
    } else {
        ESP_LOGW(STORE_TAG, "Failed to open SPIFFS directory while deleting users; falling back to indexed cleanup");
    }

    for (uint32_t i = 0; !dir && i < user_count; i++) {
        char path[USER_FILE_MAX_PATH];
        get_user_file_path(i, path, sizeof(path));
        if (remove(path) != 0 && errno != ENOENT) {
            ESP_LOGW(STORE_TAG, "Failed to remove user file %s: errno=%d", path, errno);
        } else {
            removed++;
        }
    }

    store_u32("auth_user_count", 0);
    ESP_LOGI(STORE_TAG, "Deleted all users (count=%" PRIu32 ", files_removed=%" PRIu32 ")", user_count, removed);
    return ESP_OK;
}

esp_err_t append_user_pin_to_flash(const char *uuid, const char *pin, bool *out_added) {
    if (out_added) {
        *out_added = false;
    }
    if (!uuid || uuid[0] == '\0' || !pin || pin[0] == '\0') {
        return ESP_ERR_INVALID_ARG;
    }

    uint32_t user_count = get_user_count_from_flash();
    for (uint32_t i = 0; i < user_count; i++) {
        cJSON *user = load_user_from_flash(i + 1);
        if (!user) continue;

        cJSON *uuid_json = cJSON_GetObjectItemCaseSensitive(user, "uuid");
        bool match = cJSON_IsString(uuid_json) && uuid_json->valuestring && strcmp(uuid_json->valuestring, uuid) == 0;
        if (!match) {
            cJSON_Delete(user);
            continue;
        }

        cJSON *legacy_pin = cJSON_GetObjectItemCaseSensitive(user, "pin");
        cJSON *pins = cJSON_GetObjectItemCaseSensitive(user, "pins");
        if (!cJSON_IsArray(pins)) {
            cJSON_DeleteItemFromObject(user, "pins");
            pins = cJSON_CreateArray();
            if (pins) {
                cJSON_AddItemToObject(user, "pins", pins);
            }
        }
        if (!pins) {
            cJSON_Delete(user);
            return ESP_ERR_NO_MEM;
        }

        bool legacy_present = cJSON_IsString(legacy_pin) && legacy_pin->valuestring && legacy_pin->valuestring[0] != '\0';
        bool legacy_in_pins = false;
        int pin_count = cJSON_GetArraySize(pins);
        for (int p = 0; legacy_present && !legacy_in_pins && p < pin_count; p++) {
            cJSON *pin_item = cJSON_GetArrayItem(pins, p);
            legacy_in_pins = cJSON_IsString(pin_item) && pin_item->valuestring && strcmp(pin_item->valuestring, legacy_pin->valuestring) == 0;
        }
        if (legacy_present && !legacy_in_pins) {
            cJSON_AddItemToArray(pins, cJSON_CreateString(legacy_pin->valuestring));
            pin_count++;
        }

        bool exists = legacy_present && strcmp(legacy_pin->valuestring, pin) == 0;
        for (int p = 0; !exists && p < pin_count; p++) {
            cJSON *pin_item = cJSON_GetArrayItem(pins, p);
            exists = cJSON_IsString(pin_item) && pin_item->valuestring && strcmp(pin_item->valuestring, pin) == 0;
        }

        if (!exists) {
            cJSON_AddItemToArray(pins, cJSON_CreateString(pin));
            if (!cJSON_IsString(legacy_pin) || !legacy_pin->valuestring || legacy_pin->valuestring[0] == '\0') {
                cJSON_DeleteItemFromObject(user, "pin");
                cJSON_AddStringToObject(user, "pin", pin);
            }
            if (out_added) {
                *out_added = true;
            }
        }

        esp_err_t err = write_user_to_file(i, user);
        cJSON_Delete(user);
        return err;
    }

    return ESP_ERR_NOT_FOUND;
}

esp_err_t upsert_user_pin_to_flash(const char *uuid, const char *name, const char *pin, bool *out_added) {
    if (out_added) {
        *out_added = false;
    }
    if (!uuid || uuid[0] == '\0' || !name || name[0] == '\0' || !pin || pin[0] == '\0') {
        return ESP_ERR_INVALID_ARG;
    }

    uint32_t user_count = get_user_count_from_flash();
    for (uint32_t i = 0; i < user_count; i++) {
        cJSON *user = load_user_from_flash(i + 1);
        if (!user) {
            continue;
        }

        cJSON *uuid_json = cJSON_GetObjectItemCaseSensitive(user, "uuid");
        bool match = cJSON_IsString(uuid_json) && uuid_json->valuestring && strcmp(uuid_json->valuestring, uuid) == 0;
        cJSON_Delete(user);
        if (match) {
            return append_user_pin_to_flash(uuid, pin, out_added);
        }
    }

    esp_err_t err = store_user_to_flash((char *)uuid, (char *)name, (char *)pin);
    if (err == ESP_OK && out_added) {
        *out_added = true;
    }
    return err;
}
esp_err_t store_server_info_to_flash(const char *server_ip, const char *server_port) {
    esp_err_t err_ip = store_char("server_ip", server_ip);
    esp_err_t err_port = store_char("server_port", server_port);
    if (server_ip && server_ip[0] != '\0' && server_port && server_port[0] != '\0') {
        char server_url[SERVER_URL_MAX_LEN];
        if (strcmp(server_port, DEFAULT_SERVER_PORT) == 0) {
            snprintf(server_url, sizeof(server_url), "%s", server_ip);
        } else {
            snprintf(server_url, sizeof(server_url), "%s:%s", server_ip, server_port);
        }
        store_char("server_url", server_url);
    }

    if (err_ip == ESP_OK && err_port == ESP_OK) {
        char server_url[SERVER_URL_MAX_LEN];
        if (server_ip && server_ip[0] != '\0' && server_port && server_port[0] != '\0' && strcmp(server_port, DEFAULT_SERVER_PORT) != 0) {
            snprintf(server_url, sizeof(server_url), "%s:%s", server_ip, server_port);
        } else if (server_ip && server_ip[0] != '\0') {
            snprintf(server_url, sizeof(server_url), "%s", server_ip);
        } else {
            snprintf(server_url, sizeof(server_url), "%s", DEFAULT_SERVER_URL);
        }
        cache_server_settings(server_url, server_ip, server_port, cached_server_require_reachable);
        char log_msg[LOG_STORE_MESSAGE_MAX];
        snprintf(log_msg, sizeof(log_msg), "Server settings updated (IP=%s, port=%s)", server_ip, server_port);
        automation_record_log(log_msg);
        return ESP_OK;
    }

    if (err_ip != ESP_OK) {
        ESP_LOGE(STORE_TAG, "Failed to store server IP: %s", esp_err_to_name(err_ip));
        automation_record_log("Failed to update server IP in NVS");
        return err_ip;
    }

    ESP_LOGE(STORE_TAG, "Failed to store server port: %s", esp_err_to_name(err_port));
    automation_record_log("Failed to update server port in NVS");
    return err_port;
}

esp_err_t store_server_url_to_flash(const char *server_url) {
    char normalized[SERVER_URL_MAX_LEN];

    trim_copy(server_url, normalized, sizeof(normalized));
    if (normalized[0] == '\0') {
        snprintf(normalized, sizeof(normalized), "%s", DEFAULT_SERVER_URL);
    }

    esp_err_t err_info = store_server_url_fields_to_flash(normalized);
    esp_err_t err_url = store_char("server_url", normalized);
    if (err_url == ESP_OK && err_info == ESP_OK) {
        char server_host[32];
        char server_port[8];
        parse_server_url(normalized, server_host, sizeof(server_host), server_port, sizeof(server_port));
        cache_server_settings(normalized, server_host, server_port, cached_server_require_reachable);
        char log_msg[LOG_STORE_MESSAGE_MAX];
        snprintf(log_msg, sizeof(log_msg), "Server URL updated (%.72s)", normalized);
        automation_record_log(log_msg);
        return ESP_OK;
    }

    if (err_url != ESP_OK) {
        ESP_LOGE(STORE_TAG, "Failed to store server URL: %s", esp_err_to_name(err_url));
        automation_record_log("Failed to update server URL in NVS");
        return err_url;
    }
    return err_info;
}

esp_err_t store_server_url_fields_to_flash(const char *server_url) {
    char normalized[SERVER_URL_MAX_LEN];
    char server_host[32];
    char server_port[8];

    trim_copy(server_url, normalized, sizeof(normalized));
    if (normalized[0] == '\0') {
        snprintf(normalized, sizeof(normalized), "%s", DEFAULT_SERVER_URL);
    }

    parse_server_url(normalized, server_host, sizeof(server_host), server_port, sizeof(server_port));

    esp_err_t err_ip = store_char("server_ip", server_host);
    esp_err_t err_port = store_char("server_port", server_port);
    if (err_ip == ESP_OK && err_port == ESP_OK) {
        cache_server_settings(normalized, server_host, server_port, cached_server_require_reachable);
        return ESP_OK;
    }

    if (err_ip != ESP_OK) {
        ESP_LOGE(STORE_TAG, "Failed to store server host from URL: %s", esp_err_to_name(err_ip));
        return err_ip;
    }

    ESP_LOGE(STORE_TAG, "Failed to store server port from URL: %s", esp_err_to_name(err_port));
    return err_port;
}
esp_err_t store_wifi_credentials_to_flash(const char *ssid, const char *password) {
    esp_err_t err_ssid = store_char("wifi_ssid", ssid);
    esp_err_t err_pass = store_char("wifi_password", password);

    if (err_ssid == ESP_OK && err_pass == ESP_OK) {
        portENTER_CRITICAL(&settings_cache_mux);
        snprintf(cached_wifi_ssid, sizeof(cached_wifi_ssid), "%s", ssid ? ssid : "");
        snprintf(cached_wifi_password, sizeof(cached_wifi_password), "%s", password ? password : "");
        wifi_credentials_cache_loaded = true;
        portEXIT_CRITICAL(&settings_cache_mux);
        size_t pass_len = strlen(password);
        char mask_buf[LOG_STORE_MESSAGE_MAX];
        if (pass_len == 0) {
            snprintf(mask_buf, sizeof(mask_buf), "WiFi credentials updated (SSID=%s, password empty)", ssid);
        } else {
            size_t mask_len = pass_len < 32 ? pass_len : 32;
            char mask[33];
            memset(mask, '*', mask_len);
            mask[mask_len] = '\0';
            snprintf(mask_buf, sizeof(mask_buf), "WiFi credentials updated (SSID=%s, password=%s)", ssid, mask);
        }
        ESP_LOGI(STORE_TAG, "Stored WiFi credentials for SSID '%s' (password length=%zu)", ssid, pass_len);
        automation_record_log(mask_buf);
        return ESP_OK;
    }

    if (err_ssid != ESP_OK) {
        char msg[LOG_STORE_MESSAGE_MAX];
        snprintf(msg, sizeof(msg), "Failed to store WiFi SSID (err=%s)", esp_err_to_name(err_ssid));
        ESP_LOGE(STORE_TAG, "%s", msg);
        automation_record_log(msg);
        return err_ssid;
    }

    char msg[LOG_STORE_MESSAGE_MAX];
    snprintf(msg, sizeof(msg), "Failed to store WiFi password (err=%s)", esp_err_to_name(err_pass));
    ESP_LOGE(STORE_TAG, "%s", msg);
    automation_record_log(msg);
    return err_pass;
}

// Dummy implementations for missing setting functions
int storeSetting(char *key, cJSON *payload) {
    if (!payload) {
        return -1;
    }

    char *json = cJSON_PrintUnformatted(payload);
    if (!json) {
        cJSON_Delete(payload);
        return -1;
    }

    esp_err_t err = store_char(key, json);
    free(json);
    cJSON_Delete(payload);
    return err == ESP_OK ? 0 : -1;
}

int restoreSetting(char *key) {
    char *stored = get_char(key);
    if (strcmp(stored, "") != 0) {
        cJSON *msg = cJSON_Parse(stored);
        if (msg) {
            addServiceMessageToQueue(msg); // ownership transferred
        }
    }
    free(stored);
    return 0;
}
