Wanzi-z/access-controller/code/controller/main/services/file_server.c

/* HTTP File Server Example

   This example code is in the Public Domain (or CC0 licensed, at your option.)

   Unless required by applicable law or agreed to in writing, this
   software is distributed on an "AS IS" BASIS, WITHOUT WARRANTIES OR
   CONDITIONS OF ANY KIND, either express or implied.
*/



#include <stdio.h>
#include <string.h>
#include <sys/param.h>
#include <sys/unistd.h>
#include <sys/stat.h>
#include <dirent.h>

#include "esp_err.h"
#include "esp_log.h"

#include "esp_vfs.h"
#include "esp_spiffs.h"
#include "esp_http_server.h"
#include "freertos/FreeRTOS.h"
#include "freertos/task.h"

/* Max length a file path can have on storage */
#define FILE_PATH_MAX (ESP_VFS_PATH_MAX + CONFIG_SPIFFS_OBJ_NAME_LEN)

/* Max size of an individual file. Make sure this
 * value is same as that set in upload_script.html */
#define MAX_FILE_SIZE   (200*1024) // 200 KB
#define MAX_FILE_SIZE_STR "200KB"

/* Scratch buffer size */
#define SCRATCH_BUFSIZE  4096

httpd_handle_t server = NULL;

struct file_server_data {
    /* Base path of file storage */
    char base_path[ESP_VFS_PATH_MAX + 1];

    /* Scratch buffer for temporary storage during file transfer */
    char scratch[SCRATCH_BUFSIZE];
};

static const char *FILE_TAG = "file_server";

extern void register_api_routes(httpd_handle_t server);

static esp_err_t send_embedded_asset(httpd_req_t *req,
                                     const unsigned char *start,
                                     size_t size,
                                     const char *content_type,
                                     const char *cache_control,
                                     const char *content_encoding)
{
    httpd_resp_set_type(req, content_type);
    httpd_resp_set_hdr(req, "Cache-Control", cache_control);
    httpd_resp_set_hdr(req, "Connection", "close");
    if (content_encoding && content_encoding[0] != '\0') {
        httpd_resp_set_hdr(req, "Content-Encoding", content_encoding);
        httpd_resp_set_hdr(req, "Vary", "Accept-Encoding");
    }

    if (size <= 32768) {
        return httpd_resp_send(req, (const char *)start, size);
    }

    const size_t chunk_size = 4096;
    size_t offset = 0;
    while (offset < size) {
        size_t remaining = size - offset;
        size_t to_send = remaining > chunk_size ? chunk_size : remaining;
        if (httpd_resp_send_chunk(req, (const char *)(start + offset), to_send) != ESP_OK) {
            ESP_LOGW(FILE_TAG, "Embedded asset send failed after %u/%u bytes",
                     (unsigned int)offset,
                     (unsigned int)size);
            return ESP_FAIL;
        }
        offset += to_send;
        vTaskDelay(1);
    }

    return httpd_resp_send_chunk(req, NULL, 0);
}

static bool request_accepts_gzip(httpd_req_t *req)
{
    char accept_encoding[128] = {0};
    size_t len = httpd_req_get_hdr_value_len(req, "Accept-Encoding");
    if (len == 0 || len >= sizeof(accept_encoding)) {
        return false;
    }
    if (httpd_req_get_hdr_value_str(req, "Accept-Encoding", accept_encoding, sizeof(accept_encoding)) != ESP_OK) {
        return false;
    }
    return strstr(accept_encoding, "gzip") != NULL;
}

/* Handler to redirect incoming GET request for /index.html to /
 * This can be overridden by uploading file with same name */
static esp_err_t index_html_get_handler(httpd_req_t *req)
{
    httpd_resp_set_status(req, "307 Temporary Redirect");
    httpd_resp_set_hdr(req, "Cache-Control", "no-store, no-cache, must-revalidate");
    httpd_resp_set_hdr(req, "Pragma", "no-cache");
    httpd_resp_set_hdr(req, "Location", "/");
    httpd_resp_send(req, NULL, 0);  // Response body can be empty
    return ESP_OK;
}

/* Handler to respond with an icon file embedded in flash.
 * Browsers expect to GET website icon at URI /favicon.ico.
 * This can be overridden by uploading file with same name */
static esp_err_t favicon_get_handler(httpd_req_t *req)
{
    extern const unsigned char favicon_ico_start[] asm("_binary_favicon_ico_start");
    extern const unsigned char favicon_ico_end[]   asm("_binary_favicon_ico_end");
    const size_t favicon_ico_size = (favicon_ico_end - favicon_ico_start);
    return send_embedded_asset(req,
                               favicon_ico_start,
                               favicon_ico_size,
                               "image/x-icon",
                               "public, max-age=86400, immutable",
                               NULL);
}

static esp_err_t script_get_handler(httpd_req_t *req)
{
    extern const unsigned char script_js_start[] asm("_binary_script_js_start");
    extern const unsigned char script_js_end[]   asm("_binary_script_js_end");
    extern const unsigned char script_js_gz_start[] asm("_binary_script_js_gz_start");
    extern const unsigned char script_js_gz_end[]   asm("_binary_script_js_gz_end");
    const bool gzip = request_accepts_gzip(req);
    const size_t script_js_size = (script_js_end - script_js_start);
    const size_t script_js_gz_size = (script_js_gz_end - script_js_gz_start);
    return send_embedded_asset(req,
                               gzip ? script_js_gz_start : script_js_start,
                               gzip ? script_js_gz_size : script_js_size,
                               "application/javascript",
                               "no-store, no-cache, must-revalidate",
                               gzip ? "gzip" : NULL);
}

static esp_err_t style_get_handler(httpd_req_t *req)
{
    extern const unsigned char style_css_start[] asm("_binary_style_css_start");
    extern const unsigned char style_css_end[]   asm("_binary_style_css_end");
    extern const unsigned char style_css_gz_start[] asm("_binary_style_css_gz_start");
    extern const unsigned char style_css_gz_end[]   asm("_binary_style_css_gz_end");
    const bool gzip = request_accepts_gzip(req);
    const size_t style_css_size = (style_css_end - style_css_start);
    const size_t style_css_gz_size = (style_css_gz_end - style_css_gz_start);
    return send_embedded_asset(req,
                               gzip ? style_css_gz_start : style_css_start,
                               gzip ? style_css_gz_size : style_css_size,
                               "text/css",
                               "no-store, no-cache, must-revalidate",
                               gzip ? "gzip" : NULL);
}

static esp_err_t index_get_handler(httpd_req_t *req)
{
    extern const unsigned char index_html_start[] asm("_binary_index_html_start");
    extern const unsigned char index_html_end[]   asm("_binary_index_html_end");
    extern const unsigned char index_html_gz_start[] asm("_binary_index_html_gz_start");
    extern const unsigned char index_html_gz_end[]   asm("_binary_index_html_gz_end");
    const bool gzip = request_accepts_gzip(req);
    const size_t index_html_size = (index_html_end - index_html_start);
    const size_t index_html_gz_size = (index_html_gz_end - index_html_gz_start);
    return send_embedded_asset(req,
                               gzip ? index_html_gz_start : index_html_start,
                               gzip ? index_html_gz_size : index_html_size,
                               "text/html",
                               "no-store",
                               gzip ? "gzip" : NULL);
}

/* Send HTTP response with a run-time generated html consisting of
 * a list of all files and folders under the requested path.
 * In case of SPIFFS this returns empty list when path is any
 * string other than '/', since SPIFFS doesn't support directories */
static esp_err_t http_resp_dir_html(httpd_req_t *req, const char *dirpath)
{
	extern const unsigned char index_html_start[] asm("_binary_index_html_start");
	extern const unsigned char index_html_end[]   asm("_binary_index_html_end");
	const size_t index_html_size = (index_html_end - index_html_start);
	return send_embedded_asset(req,
	                           index_html_start,
	                           index_html_size,
	                           "text/html",
	                           "no-store",
	                           NULL);
}

#define IS_FILE_EXT(filename, ext) \
    (strcasecmp(&filename[strlen(filename) - sizeof(ext) + 1], ext) == 0)

/* Set HTTP response content type according to file extension */
static esp_err_t set_content_type_from_file(httpd_req_t *req, const char *filename)
{
    if (IS_FILE_EXT(filename, ".pdf")) {
        return httpd_resp_set_type(req, "application/pdf");
    } else if (IS_FILE_EXT(filename, ".html")) {
        return httpd_resp_set_type(req, "text/html");
    } else if (IS_FILE_EXT(filename, ".jpeg")) {
        return httpd_resp_set_type(req, "image/jpeg");
    } else if (IS_FILE_EXT(filename, ".ico")) {
        return httpd_resp_set_type(req, "image/x-icon");
    }
    /* This is a limited set only */
    /* For any other type always set as plain text */
    return httpd_resp_set_type(req, "text/plain");
}

/* Copies the full path into destination buffer and returns
 * pointer to path (skipping the preceding base path) */
static const char* get_path_from_uri(char *dest, const char *base_path, const char *uri, size_t destsize)
{
    const size_t base_pathlen = strlen(base_path);
    size_t pathlen = strlen(uri);

    const char *quest = strchr(uri, '?');
    if (quest) {
        pathlen = MIN(pathlen, quest - uri);
    }
    const char *hash = strchr(uri, '#');
    if (hash) {
        pathlen = MIN(pathlen, hash - uri);
    }

    if (base_pathlen + pathlen + 1 > destsize) {
        /* Full path string won't fit into destination buffer */
        return NULL;
    }

    /* Construct full path (base + path) */
    strcpy(dest, base_path);
    strlcpy(dest + base_pathlen, uri, pathlen + 1);

    /* Return pointer to path, skipping the base */
    return dest + base_pathlen;
}

/* Handler to download a file kept on the server */
static esp_err_t download_get_handler(httpd_req_t *req)
{
    char filepath[FILE_PATH_MAX];
    FILE *fd = NULL;
    struct stat file_stat;

    const char *filename = get_path_from_uri(filepath, ((struct file_server_data *)req->user_ctx)->base_path,
                                             req->uri, sizeof(filepath));
    if (!filename) {
        ESP_LOGE(FILE_TAG, "Filename is too long");
        /* Respond with 500 Internal Server Error */
        httpd_resp_send_err(req, HTTPD_500_INTERNAL_SERVER_ERROR, "Filename too long");
        return ESP_FAIL;
    }

    /*
     * The controller UI is embedded into the firmware image. Always serve
     * these core assets from flash so stale SPIFFS uploads cannot mask a
     * successful firmware update.
     */
    if (strcmp(filename, "/") == 0 || strcmp(filename, "/index.html") == 0) {
        return index_get_handler(req);
    } else if (strcmp(filename, "/favicon.ico") == 0) {
        return favicon_get_handler(req);
    } else if (strcmp(filename, "/style.css") == 0) {
        return style_get_handler(req);
    } else if (strcmp(filename, "/script.js") == 0 || strcmp(filename, "/jquery-min.js") == 0) {
        return script_get_handler(req);
    }

    /* If name has trailing '/', respond with directory contents (serve index) */
    if (filename[strlen(filename) - 1] == '/' || strlen(filename) == 0) {
        return http_resp_dir_html(req, filepath);
    }

    if (stat(filepath, &file_stat) == -1) {
        ESP_LOGE(FILE_TAG, "Failed to stat file : %s", filepath);
        /* Respond with 404 Not Found */
        httpd_resp_send_err(req, HTTPD_404_NOT_FOUND, "File does not exist");
        return ESP_FAIL;
    }

    fd = fopen(filepath, "r");
    if (!fd) {
        ESP_LOGE(FILE_TAG, "Failed to read existing file : %s", filepath);
        /* Respond with 500 Internal Server Error */
        httpd_resp_send_err(req, HTTPD_500_INTERNAL_SERVER_ERROR, "Failed to read existing file");
        return ESP_FAIL;
    }

    ESP_LOGI(FILE_TAG, "Sending file : %s (%ld bytes)...", filename, file_stat.st_size);
    set_content_type_from_file(req, filename);

    /* Prevent browser from caching HTML/JS/CSS so updated files are always loaded */
    httpd_resp_set_hdr(req, "Cache-Control", "no-store, no-cache, must-revalidate");
    httpd_resp_set_hdr(req, "Pragma", "no-cache");
    httpd_resp_set_hdr(req, "Connection", "close");

    /* Retrieve the pointer to scratch buffer for temporary storage */
    char *chunk = ((struct file_server_data *)req->user_ctx)->scratch;
    size_t chunksize;
    do {
        /* Read file in chunks into the scratch buffer */
        chunksize = fread(chunk, 1, SCRATCH_BUFSIZE, fd);

        if (chunksize > 0) {
            /* Send the buffer contents as HTTP response chunk */
            if (httpd_resp_send_chunk(req, chunk, chunksize) != ESP_OK) {
                fclose(fd);
                ESP_LOGE(FILE_TAG, "File sending failed!");
                /* Abort sending file */
                httpd_resp_sendstr_chunk(req, NULL);
                /* Respond with 500 Internal Server Error */
                httpd_resp_send_err(req, HTTPD_500_INTERNAL_SERVER_ERROR, "Failed to send file");
               return ESP_FAIL;
           }
        }

        /* Keep looping till the whole file is sent */
    } while (chunksize != 0);

    /* Close file after sending complete */
    fclose(fd);
    ESP_LOGI(FILE_TAG, "File sending complete");

    /* Respond with an empty chunk to signal HTTP response completion */
    httpd_resp_set_hdr(req, "Connection", "close");
    httpd_resp_send_chunk(req, NULL, 0);
    return ESP_OK;
}

/* Handler to upload a file onto the server */
static esp_err_t upload_post_handler(httpd_req_t *req)
{
    char filepath[FILE_PATH_MAX];
    FILE *fd = NULL;
    struct stat file_stat;

    /* Skip leading "/upload" from URI to get filename */
    /* Note sizeof() counts NULL termination hence the -1 */
    const char *filename = get_path_from_uri(filepath, ((struct file_server_data *)req->user_ctx)->base_path,
                                             req->uri + sizeof("/upload") - 1, sizeof(filepath));
    if (!filename) {
        /* Respond with 500 Internal Server Error */
        httpd_resp_send_err(req, HTTPD_500_INTERNAL_SERVER_ERROR, "Filename too long");
        return ESP_FAIL;
    }

    /* Filename cannot have a trailing '/' */
    if (filename[strlen(filename) - 1] == '/') {
        ESP_LOGE(FILE_TAG, "Invalid filename : %s", filename);
        httpd_resp_send_err(req, HTTPD_500_INTERNAL_SERVER_ERROR, "Invalid filename");
        return ESP_FAIL;
    }

    if (stat(filepath, &file_stat) == 0) {
        ESP_LOGE(FILE_TAG, "File already exists : %s", filepath);
        /* Respond with 400 Bad Request */
        httpd_resp_send_err(req, HTTPD_400_BAD_REQUEST, "File already exists");
        return ESP_FAIL;
    }

    /* File cannot be larger than a limit */
    if (req->content_len > MAX_FILE_SIZE) {
        ESP_LOGE(FILE_TAG, "File too large : %d bytes", req->content_len);
        /* Respond with 400 Bad Request */
        httpd_resp_send_err(req, HTTPD_400_BAD_REQUEST,
                            "File size must be less than "
                            MAX_FILE_SIZE_STR "!");
        /* Return failure to close underlying connection else the
         * incoming file content will keep the socket busy */
        return ESP_FAIL;
    }

    fd = fopen(filepath, "w");
    if (!fd) {
        ESP_LOGE(FILE_TAG, "Failed to create file : %s", filepath);
        /* Respond with 500 Internal Server Error */
        httpd_resp_send_err(req, HTTPD_500_INTERNAL_SERVER_ERROR, "Failed to create file");
        return ESP_FAIL;
    }

    ESP_LOGI(FILE_TAG, "Receiving file : %s...", filename);

    /* Retrieve the pointer to scratch buffer for temporary storage */
    char *buf = ((struct file_server_data *)req->user_ctx)->scratch;
    int received;

    /* Content length of the request gives
     * the size of the file being uploaded */
    int remaining = req->content_len;

    while (remaining > 0) {

        ESP_LOGI(FILE_TAG, "Remaining size : %d", remaining);
        /* Receive the file part by part into a buffer */
        if ((received = httpd_req_recv(req, buf, MIN(remaining, SCRATCH_BUFSIZE))) <= 0) {
            if (received == HTTPD_SOCK_ERR_TIMEOUT) {
                /* Retry if timeout occurred */
                continue;
            }

            /* In case of unrecoverable error,
             * close and delete the unfinished file*/
            fclose(fd);
            unlink(filepath);

            ESP_LOGE(FILE_TAG, "File reception failed!");
            /* Respond with 500 Internal Server Error */
            httpd_resp_send_err(req, HTTPD_500_INTERNAL_SERVER_ERROR, "Failed to receive file");
            return ESP_FAIL;
        }

        /* Write buffer content to file on storage */
        if (received && (received != fwrite(buf, 1, received, fd))) {
            /* Couldn't write everything to file!
             * Storage may be full? */
            fclose(fd);
            unlink(filepath);

            ESP_LOGE(FILE_TAG, "File write failed!");
            /* Respond with 500 Internal Server Error */
            httpd_resp_send_err(req, HTTPD_500_INTERNAL_SERVER_ERROR, "Failed to write file to storage");
            return ESP_FAIL;
        }

        /* Keep track of remaining size of
         * the file left to be uploaded */
        remaining -= received;
    }

    /* Close file upon upload completion */
    fclose(fd);
    ESP_LOGI(FILE_TAG, "File reception complete");

    /* Redirect onto root to see the updated file list */
    httpd_resp_set_status(req, "303 See Other");
    httpd_resp_set_hdr(req, "Location", "/");
    httpd_resp_set_hdr(req, "Connection", "close");
    httpd_resp_sendstr(req, "File uploaded successfully");
    return ESP_OK;
}

/* Handler to delete a file from the server */
static esp_err_t delete_post_handler(httpd_req_t *req)
{
    char filepath[FILE_PATH_MAX];
    struct stat file_stat;

    /* Skip leading "/delete" from URI to get filename */
    /* Note sizeof() counts NULL termination hence the -1 */
    const char *filename = get_path_from_uri(filepath, ((struct file_server_data *)req->user_ctx)->base_path,
                                             req->uri  + sizeof("/delete") - 1, sizeof(filepath));
    if (!filename) {
        /* Respond with 500 Internal Server Error */
        httpd_resp_send_err(req, HTTPD_500_INTERNAL_SERVER_ERROR, "Filename too long");
        return ESP_FAIL;
    }

    /* Filename cannot have a trailing '/' */
    if (filename[strlen(filename) - 1] == '/') {
        ESP_LOGE(FILE_TAG, "Invalid filename : %s", filename);
        httpd_resp_send_err(req, HTTPD_500_INTERNAL_SERVER_ERROR, "Invalid filename");
        return ESP_FAIL;
    }

    if (stat(filepath, &file_stat) == -1) {
        ESP_LOGE(FILE_TAG, "File does not exist : %s", filename);
        /* Respond with 400 Bad Request */
        httpd_resp_send_err(req, HTTPD_400_BAD_REQUEST, "File does not exist");
        return ESP_FAIL;
    }

    ESP_LOGI(FILE_TAG, "Deleting file : %s", filename);
    /* Delete file */
    unlink(filepath);

    /* Redirect onto root to see the updated file list */
    httpd_resp_set_status(req, "303 See Other");
    httpd_resp_set_hdr(req, "Location", "/");
    httpd_resp_set_hdr(req, "Connection", "close");
    httpd_resp_sendstr(req, "File deleted successfully");
    return ESP_OK;
}

/* Function to start the file server */
esp_err_t start_file_server(const char *base_path)
{
    static struct file_server_data *server_data = NULL;

    /* Validate file storage base path */
    if (!base_path || strcmp(base_path, "/spiffs") != 0) {
        ESP_LOGE(FILE_TAG, "File server presently supports only '/spiffs' as base path");
        return ESP_ERR_INVALID_ARG;
    }

    if (server_data) {
        ESP_LOGE(FILE_TAG, "File server already started");
        return ESP_ERR_INVALID_STATE;
    }

    /* Allocate memory for server data */
    server_data = calloc(1, sizeof(struct file_server_data));
    if (!server_data) {
        ESP_LOGE(FILE_TAG, "Failed to allocate memory for server data");
        return ESP_ERR_NO_MEM;
    }
    strlcpy(server_data->base_path, base_path,
            sizeof(server_data->base_path));

    httpd_config_t config = HTTPD_DEFAULT_CONFIG();
    config.max_uri_handlers = 64; // allow API, websocket, OTA, upload, schedules, and embedded asset routes
    // LWIP_MAX_SOCKETS is 10; leave headroom for the tunnel/ws/DNS sockets and cap
    // how many heavy JSON responses (/api/state etc.) can build concurrently, so a
    // burst of clients degrades (lru_purge) instead of exhausting heap and crashing.
    config.max_open_sockets = 5;
    config.backlog_conn = 4;
    config.lru_purge_enable = true;
    config.task_priority = 8;
    config.stack_size = 8192;
    config.recv_wait_timeout = 5;
    config.send_wait_timeout = 10;
    config.keep_alive_enable = false;

    /* Use the URI wildcard matching function in order to
     * allow the same handler to respond to multiple different
     * target URIs which match the wildcard scheme */
    config.uri_match_fn = httpd_uri_match_wildcard;

    ESP_LOGI(FILE_TAG, "Starting HTTP Server (max_uri_handlers=%d)", config.max_uri_handlers);
    if (httpd_start(&server, &config) != ESP_OK) {
        ESP_LOGE(FILE_TAG, "Failed to start file server!");
        return ESP_FAIL;
    }

    ws_mutex = xSemaphoreCreateMutex();
    if (ws_mutex == NULL) {
        ESP_LOGE(FILE_TAG, "Mutex creation failed");
        return ESP_FAIL;
    }
    start_ws_server(server);
    register_api_routes(server);

    /* URI handler for getting uploaded files */
    httpd_uri_t file_download = {
        .uri       = "/*",  // Match all URIs of type /path/to/file
        .method    = HTTP_GET,
        .handler   = download_get_handler,
        .user_ctx  = server_data    // Pass server data as context
    };
    httpd_register_uri_handler(server, &file_download);

    /* URI handler for uploading files to server */
    httpd_uri_t file_upload = {
        .uri       = "/upload/*",   // Match all URIs of type /upload/path/to/file
        .method    = HTTP_POST,
        .handler   = upload_post_handler,
        .user_ctx  = server_data    // Pass server data as context
    };
    httpd_register_uri_handler(server, &file_upload);

    /* URI handler for deleting files from server */
    httpd_uri_t file_delete = {
        .uri       = "/delete/*",   // Match all URIs of type /delete/path/to/file
        .method    = HTTP_POST,
        .handler   = delete_post_handler,
        .user_ctx  = server_data    // Pass server data as context
    };
    httpd_register_uri_handler(server, &file_delete);

    return ESP_OK;
}
