Wanzi-z/access-controller/(commit log)

2026-07-06 Support multiple enrolled PIN credentials
2026-07-06 Polish enrollment credential flow
2026-07-06 Make ESP32 flash script show real connection retries
2026-07-06 Fix persisted bulk credential removal
    [api.c, authorize.c, main.c, rf_registry.c, rf_registry.h, store.c, store.h, wiegand_registry.c]
2026-07-06 Automate ESP32 flashing and harden bulk clears
2026-07-07 Add browser OTA update path
    [partitions.csv]
2026-07-07 docs: add cloud tunnel & device-manager integration guide
    Covers reverse SSH tunnel architecture, public/internal endpoints,
    device punch-in API schema, ESP32 firmware integration, SSL, DNS,
    and troubleshooting for the open-automation.org setup.
2026-07-08 Clean up controller KiCad project
    [Adapter-TE-52-B_Cu.gbr, Adapter-TE-52-B_Mask.gbr, Adapter-TE-52-B_Paste.gbr, Adapter-TE-52-Edge_Cuts.gbr, Adapter-TE-52-F_Cu.gbr, Adapter-TE-52-F_Mask.gbr, Adapter-TE-52-F_Paste.gbr, Adapter-TE-52-F_SilkS.gbr]
2026-07-08 Stabilize controller load and OTA testing
    [api.c, buzzer.c, file_server.c, fob.c, keypad.c, motion.c, station.c, tunnel.c]
2026-07-09 Stabilize controller RF enrollment and tunnel API
    [api.c, file_server.c, log_store.c, main.c, rf_receiver.c, rf_registry.c, rf_registry.h, store.c]
2026-07-09 Stabilize credential UI under load
    [api.c, file_server.c, fob.c, keypad.c, motion.c, station.c, store.c, wiegand.c]
2026-07-09 Update controller enclosure model assets
    [controller-cover.3mf, controller-cover.stl, controller-plate.stl, controller.blend]
2026-07-10 Fix Wiegand PIN credentials and activity outlines
    [api.c, authorize.c, enrollment.c, rf_receiver.c, store.c, store.h, wiegand.c, wiegand_registry.c]
2026-07-10 Stabilize controller Wi-Fi and input tests
    [ap.c, api.c, authorize.c, file_server.c, fob.c, keypad.c, lock.c, main.c]
2026-07-10 Fix immediate keypad pulse for aux inputs
    [lock.c, tunnel.c]
2026-07-10 Add controller backup and test artifacts
    [Adapter-TE-52-B_Cu.gbr, Adapter-TE-52-B_Mask.gbr, Adapter-TE-52-B_Paste.gbr, Adapter-TE-52-Edge_Cuts.gbr, Adapter-TE-52-F_Cu.gbr, Adapter-TE-52-F_Mask.gbr, Adapter-TE-52-F_Paste.gbr, Adapter-TE-52-F_SilkS.gbr]
2026-07-10 Stabilize AP Wi-Fi scanning and recovery UI
    [api.c, store.c]
2026-07-10 Restructure device controls by locks exits and Wiegand
2026-07-11 Tighten device control layout
2026-07-11 Flatten device controls layout
2026-07-11 Add time-based access schedules with IP-resolved local time
    [api.c, authorize.c, file_server.c, ip_timezone.c, ip_timezone.h, main.c, rf_registry.c, schedule.c]
2026-07-11 Fix Wi-Fi form sizing and device grid breakpoints
2026-07-11 Add power/energy-harvesting design investigation doc
2026-07-12 Stop beeping on rejected PIN codes
    Wrong, disabled, and schedule-denied PINs were pulsing both Wiegand
    outputs via beep_keypad's hardcoded ALERT_TARGET_BOTH -- only a
    successful unlock or enrollment capture should produce audible
    feedback.
    [wiegand.c]
2026-07-12 Overhaul credential UI: per-user delete, dedup on enrollment, persisted tab, layout fixes
    - Add a delete icon to each user's dropdown header that removes the
    user and every credential they own
    - Fix enrollment/typed-name flows minting a duplicate user instead of
    reusing an already-displayed one when adding a second credential
    - Remember the active Device/Settings/System tab across page refreshes
    - Show at least two Wi-Fi networks per row on small phone screens
    instead of one full-width card
    - Redesign the card test/play icon to match the enable icon's visual
    weight
    - Rename "WG1"/"WG2" labels to "Wiegand 1"/"Wiegand 2"
    - User groups now start collapsed instead of auto-expanding when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
2026-07-21 fix(hardware): correct Wiegand input biasing
    [access-controller.kicad_sch, wiegand.kicad_sch]
2026-07-24 chore(hardware): upgrade KiCad project to Eeschema 10.0 format
    Re-saved in KiCad 10 (generator_version bump, new zone-fill and
    footprint-default schema fields, float precision cleanup). Verified
    component counts (lib_id) are unchanged in every schematic sheet -
    formatting only, no circuit edits.
    [access-controller.kicad_sch, control.kicad_sch, ethernet.kicad_sch, microcontroller.kicad_sch, power.kicad_sch, quad-optocoupler.kicad_sch, wiegand.kicad_sch]
2026-07-24 feat(wiegand): validate frame parity, auto-detect polarity, and filter electrical noise
    Extract frame validation into wiegand_format.c: reject frames outside
    24-58 bits, frames without both DATA0 and DATA1 pulses, and 26/34-bit
    frames with invalid parity. When parity fails, try the DATA0/DATA1-swapped
    orientation and adopt it if valid, persisting the learned polarity per
    channel to NVS so both card and keypad decoding stay consistent across
    reboots. wiegand_registry.c normalizes stored credentials the same way
    and merges duplicates that were enrolled under different polarity.
    wiegand.c also timestamps pulses in the ISR (instead of sampling GPIO
    level, which could race), drops pulses under 5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
    [main.c, wiegand.c, wiegand_format.c, wiegand_format.h, wiegand_registry.c]
2026-07-24 fix(firmware): seed input state from hardware at boot; rename lock polarity to fail-secure
    Lock/exit/fob/keypad/motion structs start zeroed, which left every
    re-arm timer armed (expired=false) and made check_*_timer() treat an
    already-active input as a fresh press on boot - including firing the
    alert beep. Sample each pin and seed expired/count/isPressed/prevPress
    before the service tasks start, and add an early return once a timer
    is already expired so it can't be double-processed. fob_main() also
    now calls restoreFobSettings() before creating its tasks instead of
    after.
    Collapse alert_output_signal_force into alert_output_signal - the force
    variant existed only to bypass quiet mode for au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
    [fob.c, keypad.c, lock.c, motion.c]
2026-07-24 fix(enrollment): resolve display names for RFID/RF-only users
    The credential UI groups keypad/Wiegand/RF credentials into one
    identity list, so a user whose only credential is an RFID card or RF
    remote needs to resolve a name too - previously enrollment_load_user_name
    only checked the keypad flash store and 404'd for them. Add
    rf_registry_find_name_by_uuid() and check both the Wiegand and RF
    registries as fallbacks.
    [enrollment.c, rf_registry.c, rf_registry.h]
2026-07-24 fix(store): self-heal PIN user count from flash instead of trusting NVS
    get_user_count_from_flash() now scans /spiffs for user_<n>.json files
    and repairs the cached auth_user_count in NVS if it has drifted, rather
    than trusting a counter that could desync from what's actually on disk.
    store_user_to_flash() uses the same self-healing read.
    This makes api.c's prune_empty_default_keypad_users() workaround (which
    deleted phantom "Default User" entries created by the old drift) dead
    code; remove it along with its two helpers.
    [api.c, store.c]
2026-07-24 test: add schedule-resilience UI suite; harden Playwright toggle helper
    - New ui-schedule-resilience.mjs suite plus runner/package.json wiring,
    alongside the wiegand-format and boot-audio unit tests added in prior
    commits (test:wiegand-format, test:boot-audio scripts).
    - ui-playwright.mjs's uiToggleTest/uiModeTest now poll for the expected
    API value instead of sleeping a fixed timeout, sync the checkbox
    before interacting with it, and drive alert-target multi-select
    controls directly - fixed timeouts were flaking after bulk NVS
    exercises where writes lag behind the request.
    - reliability-soak.mjs's browser worker now clicks into the device tab
    before waiting on #modeExit_1, mat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
2026-07-25 fix(tunnel): self-healing DM proxy bind + fast device reconnect
    The Device Manager could not control the controller through the tunnel proxy
    when the device was on a NAT'd network (ec3409): the esp32-tunnel HTTP proxy
    (9110) was never bound. Root cause was a boot race — the tunnel service starts
    before Docker creates docker0, so httpServer.listen(9110,'172.17.0.1') failed
    EADDRNOTAVAIL and the error was logged-and-swallowed, leaving the proxy dark
    while the tunnel TCP port (9111) came up fine.
    server.js: retry the HTTP-proxy bind every 3s on EADDRNOTAVAIL/EADDRINUSE until
    the address exists (self-healing, survives any boot ordering).
    tunnel.c: the device also wedged on reconnect — 60s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
    [tunnel.c]
2026-07-25 fix(lock): route every input to an enabled lock; boot locked
    Exits 5-8 (and any input) targeting a disabled lock channel would beep but not
    fire the lock. Added lock_resolve_target_mask() which maps a requested target
    mask onto the set of enabled locks (falling back to the lowest enabled lock),
    applied in exit/fob/keypad/motion/wiegand so tags, PINs, fobs, motion and exit
    buttons all actuate the enabled lock regardless of the configured channel.
    Also drive the lock output at boot so the door boots LOCKED (fail-secure) instead
    of starting open. Adds tests/suites/exit-target-matrix.mjs (16/16).
    [automation.h, fob.c, keypad.c, lock.c, motion.c, wiegand.c]
2026-07-25 fix(stability): RAM-only logs, stay on LAN, guard boot OTA
    The device went flaky/unreachable after settings saves: the 20K NVS partition was
    chronically full because log_store persisted the diagnostic ring to NVS, so every
    save thrashed NVS and starved heap. LOG_STORE_PERSIST 0 keeps logs in RAM only
    (freeing the stored blob once), so saves are clean and heap holds ~55-62K.
    main.c: guard the boot self-OTA behind a valid-MD5 check, and stay on WiFi/LAN
    instead of falling back to AP when the server is unreachable (eliminates the
    punch-cycling heap thrash on NAT'd networks). file_server.c: cap max_open_sockets
    at 5 to bound httpd memory under load.
    [file_server.c, log_store.c, main.c]
2026-07-25 feat(ui): show arm/disarm state in the lock button
    Fold the lock state into the arm control itself: the pill shows '🔒 Armed' /
    '🔓 Disarmed' and styles amber when disarmed, instead of a separate status row.
    Clarifies the fail-secure tooltip (keep checked: armed drives the door LOCKED).
    Regenerates the gzipped assets and bumps the ?v cache-buster.
2026-07-25 docs: flashing guide + buttonless reset helper
    FLASHING.md documents the update paths (buttonless OTA over WiFi, buttonless OTA
    off-LAN through Device Manager, buttonless RTS reset, and PROG-button serial flash
    for recovery) and the ttyUSB0-vs-ttyACM0 serial-port gotcha. reset_to_app.sh
    pulses EN via RTS (GPIO0 held high) to reboot a wedged device into the app with
    no button press.
2026-07-25 docs: authoritative deploy/OTA/USB reference with decision table
    Rewrite code/controller/FLASHING.md into the single source of truth for getting
    firmware onto the controller, with a decision table up front and every method we
    validated: build (ESP-IDF v6.0 @3cc59d2c); OTA over LAN (tools/ota_client.py),
    off-LAN through the Device Manager tunnel, and AP-mode in the field (SoftAP
    ac_<mac>/pyfitech at 192.168.4.1); buttonless RTS reset (reset_to_app.sh); serial
    flash with the PROG button (DTR not wired to GPIO0); the ttyUSB0-vs-ttyACM0 gotcha;
    field-laptop setup (clone + install.sh esp32s3); and how to verify an OTA landed
    (version string, app0<->app1 flip, 'OTA image marked valid'). Cross-link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
2026-07-25 feat(exit): add per-input Invert (NC) toggle
    Exit inputs default to Normally-Open (idle HIGH, press pulls LOW). The new
    per-exit 'invert' flag reads the pin as-is instead of inverted, so a
    Normally-Closed button fires on the same press edge (isPressed low->high)
    rather than on release, and latch-mode sense is no longer inverted. Off by
    default (existing NO installs unchanged); persisted, reflected in state, and
    seeded into the boot edge-detector so NC doesn't glitch a press at startup.
    Adds an 'Invert (NC)' switch to the Exit 1 & Exit 5 cards (v=42).
2026-07-26 docs: Edmond Coins install-day photos — bench prep, on-site, WiFi note
    8 additional 2026-07-24 bench photos (new-cable-bundle splice work etc.,
    beyond the 5 already committed for v6.0/v6.1), 2 on-site stills from the
    2026-07-25 install, a video-frame capture of the installed front-door
    keypad/strike, and the on-site WiFi-credentials sticky note photo.
    Companion Journal artifacts: pyfi-install_guide.md v7.0 and
    pyfi-edmond_coins-post_install_analysis.md.
