Wanzi-z/access-controller/images/20260708_183142.jpg

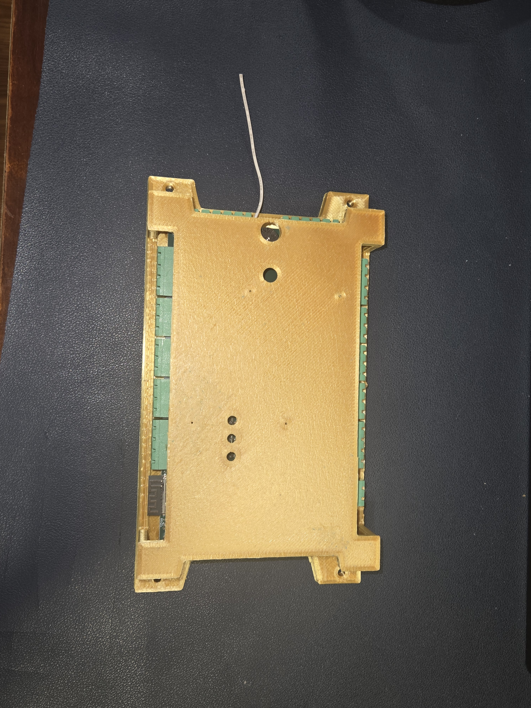
images/20260708_183142.jpg
