Wanzi-z/access-controller/images/20260724_203247.jpg

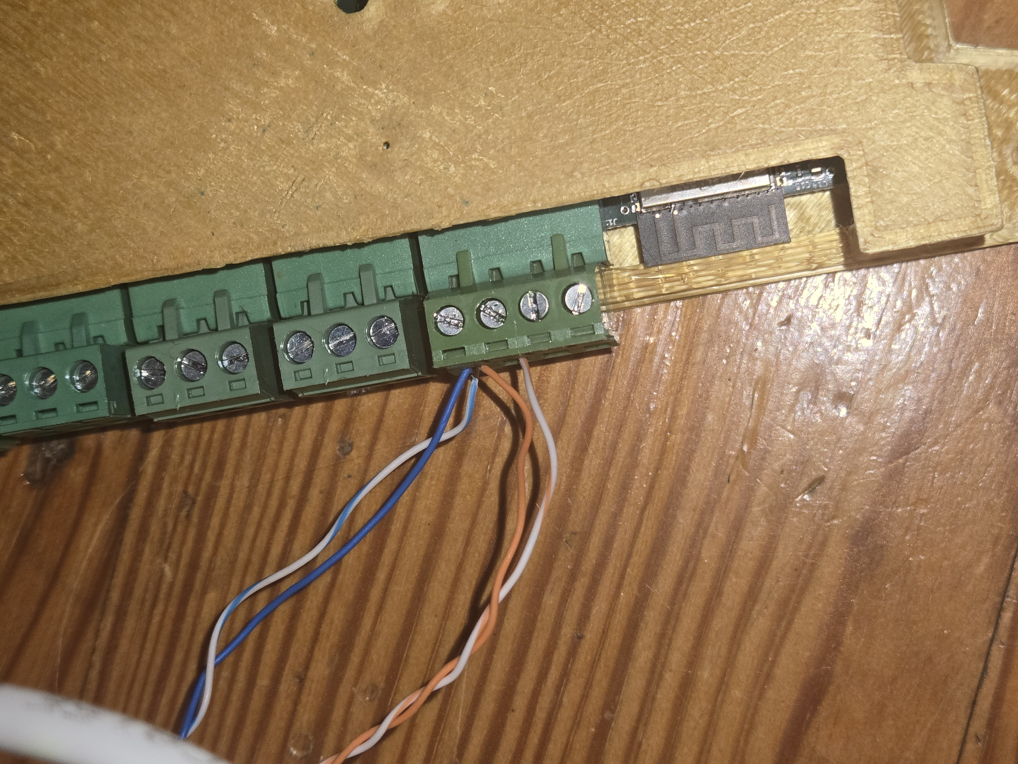
images/20260724_203247.jpg
