Wanzi-z/access-controller/images/20260725_160216.jpg

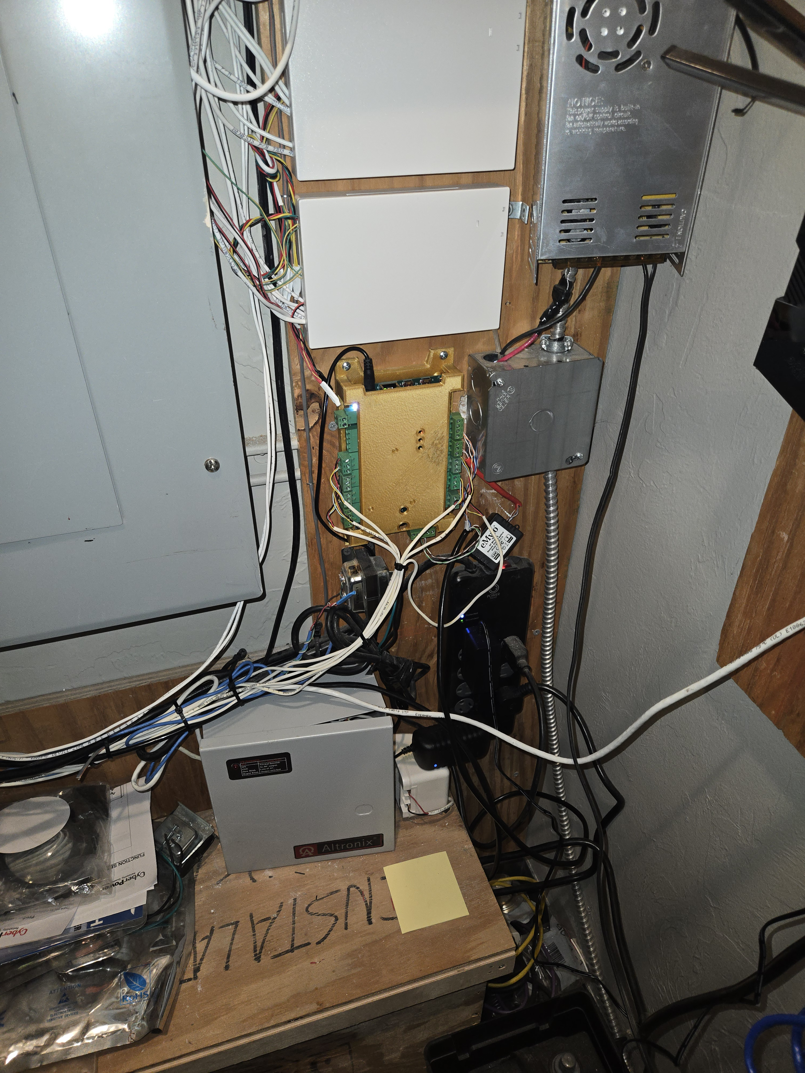
images/20260725_160216.jpg
