Wanzi-z/access-controller/images/20260725_160221.jpg

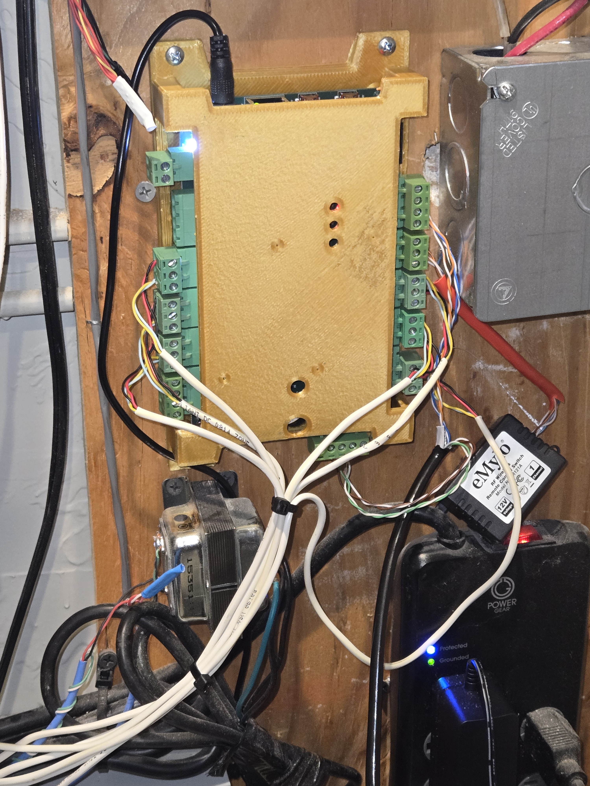
images/20260725_160221.jpg
