Wanzi-z/access-controller/images/image-1783644701203.jpg

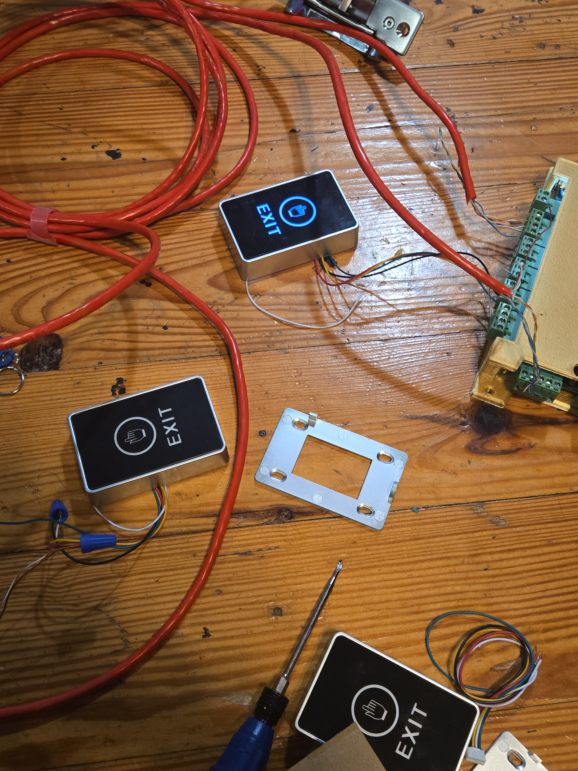
images/image-1783644701203.jpg
